NoBlackBoxes/BlackBoxes/README.md

# Black Boxes

> A collection of **black boxes** and instructions for opening them.

----

## License

<br />The entire BlackBoxes repository (hardware and software) is licensed under a <a rel="license" href="http://creativecommons.org/licenses/by-nc-sa/4.0/">Creative Commons Attribution-NonCommercial-ShareAlike 4.0 International License</a>.
