NoBlackBoxes/BlackBoxes/vision/python/README.md

# Vision : python

```bash
pip install opencv-python
```

```bash
# On Host (current Python version 3.12.3)
echo "/home/${USER}/NoBlackBoxes/LastBlackBox/boxes/vision/python/libs" > /home/${USER}/NoBlackBoxes/LastBlackBox/_tmp/NBB/lib/python3.12/site-packages/NBB_vision.pth
```
