NoBlackBoxes/BlackBoxes/electrons/README_new.md

# Electrons

Electrons are sub-atomic particles with a negative electric charge. Their negative charge produces a *force* that attracts positive charges and repels negative charges.

In this box, we will learn about electricity...how to measure it and how to **control** it.

### Required Materials

- {01}: NBB-11, multimeter
- {10}: NBB-21, multimeter
- {11}: NBB-31, multimeter, oscilliscope

## Electric Fields

Electric fields describe the force that a charged particle feels when nearby another charged particle.

{01}
Watch this video...closely.
- *Video*: [LBB:Electrons:Electric Fields](https://vimeo.com/625820421)

{10}
Watch this video.
- *Video*: [NB3:Electrons:Dipoles](https://vimeo.com/843622939)

Use the following image as a starting point for the next task.
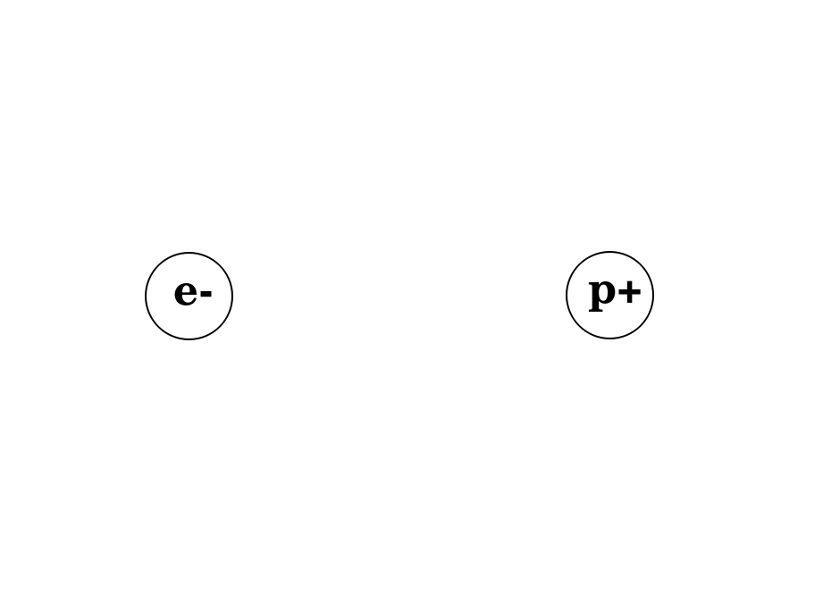
[picture p2: electrons/_data/images/dipole_field_template.png]
dipole field template


- **Task**(draw_a_dipole_field): Draw the electric field around an electron(-) and a proton(+) seperated by some small distance (as experienced by another electon). Upload a photo of your field drawing. [photo]

## Voltage

Voltage describes the difference in net charge in one location versus another.

{01}
- *Video*: [LBB:Electrons:Voltage](https://vimeo.com/XXX)

## Batteries

Producing a stable voltage was hard, but very useful.

{01}
- *Video*: [LBB:Electrons:Batteries](https://vimeo.com/XXX)

{10}
- *Video*: [NB3:Electrons:Household Battery](https://vimeo.com/XXX)
- **Task**(build_a_battery): Build a battery. Upload a photo of your design and the voltage generated (as shown on the multimeter screen) here: [photo]
 
## Measuring Voltage

We can measure voltage (and other electrical properties) with a multi-meter.

{01}
- *Video*: [NB3:Electrons:Measuring Voltage](https://vimeo.com/XXX)
- **Task**(measure_AA_battery): Measure the voltage of a AA battery. Enter your measurement [number].
- **Task**(measure_4xAA_batteries): Measure the voltage of 4xAA batteries in series (i.e. in your battery holder). Enter your measurement here [number].

## Conductors

Some materials have electrons that are very loosely connected to their atom's nucleus. In a material made up of many atom's of this type, then the electrons can hop from nucleus to nucleus. The electrons can "move". We call these materials conductors.

{10}
- *Video*: [LBB:Electrons:Conductors](https://vimeo.com/XXX)

## Resistors

In other materials, some electrons are free and others are not. They can move, but not as well. They experience resistance. We call these materials resitors, and they will help us *control* electricity.

{10}
- *Video*: [LBB:Electrons:Resistors](https://vimeo.com/XXX)

## Measuring Resistance

We can measure resitance (and other electrical properties) with a multi-mteter.

{10}
- *Video*: [NB3:Electrons:Measuring Resistance](https://vimeo.com/XXX)

## Circuit Diagrams

We can draw simple schematics of electronic circuits using symbols for the real devices. We will draw and build *many* of these.

{01}
- *Video*: [LBB:Electrons:Circuit Diagrams](https://vimeo.com/XXX)
- **Task**(draw_a_simple_circuit): Draw a circuit with one battery and two resistors. Lable the voltage and resistor values. Upload a picture of your circuit here [photo].

## Prototyping

Let's build a prototyping board for creating and testing our first circuits.

{01}
- *Video*: [NB3:Electrons:Assemble NB3 Body](https://vimeo.com/XXX)
- **Task**(assemble_nb3_body): Build your NB3 body [photo].

## Printed Circuit Boards

Let's have a look at a printed circuit board.

{01}
- *Video*: [NB3:Electrons:Assemble NB3 Body](https://vimeo.com/XXX)
- **Task**(assemble_nb3_body): Build your NB3 body [photo].
  
## Current

Electrons, pushed by a voltage, moving in a conductor, or less so in a resistor create a current.

{01}
- *Video*: [LBB:Electrons:Current](https://vimeo.com/XXX)
- **Task**(measure_current): Measure the current flowing across a resitor. Enter the votage you used here [number.voltage], the resistor value here [number.resistance], and the measured current here [number.current].

## Measuring Current

We can measure current (and other electrical properties) with a multi-mteter.

{01}
- *Video*: [LBB:Electrons:Measuring Current](https://vimeo.com/XXX)
- **Task**(measure_current): Measure the current flowing across a resistor. Enter the votage you used here [number.voltage], the resistor value here [number.resistance], and the measured current here [number.current].

## Ohm's Law

A simple, linear, relationship between voltage, current, and resistance.

{01}
- *Video*: [LBB:Electrons:Ohms's Law](https://vimeo.com/XXX)
- **Task**: Measure the current flowing across a resitor [number].

## Voltage Divider

Your first circuit.

{01}
- *Video*: [LBB:Electrons:Voltage Divider](https://vimeo.com/625820421)
- **Task**: Build a voltage divider using two resistors and measure the "divided" voltage level. Is it what you epxected? Upload a picture of your circuit diagram with voltage and resistor values indicated [photo].

## Capacitors

Capacitors are cool.

{10}
- *Video*: [LBB:Electrons:Capacitors](https://vimeo.com/625820421)
- **Task**: Measure the capacitance of your cap [number]
