NoBlackBoxes/BlackBoxes/amplifiers/images/NB3_amplifiers.png

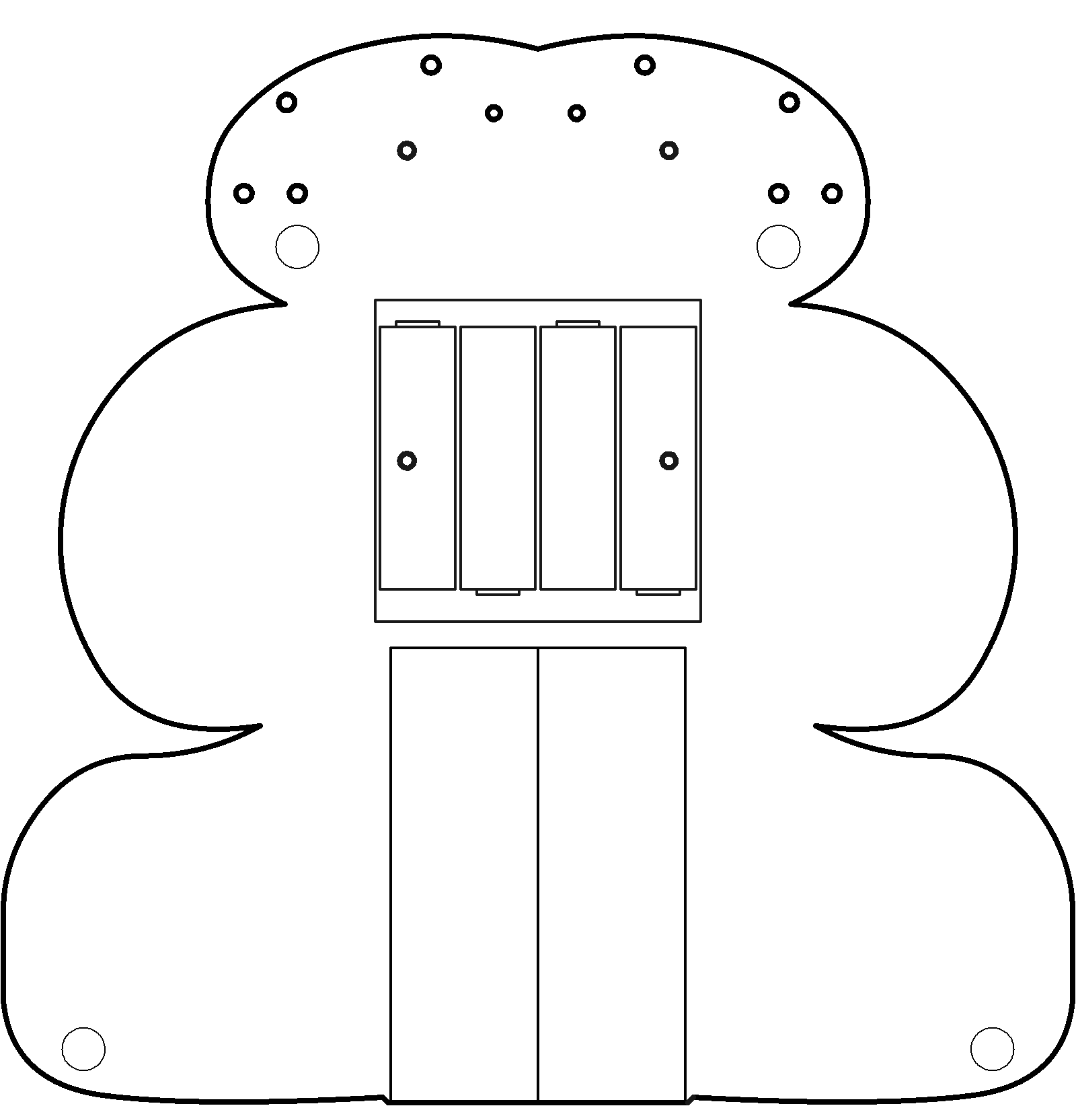
amplifiers/images/NB3_amplifiers.png
