NoBlackBoxes/BlackBoxes/atoms/_data/images/periodic_table.png

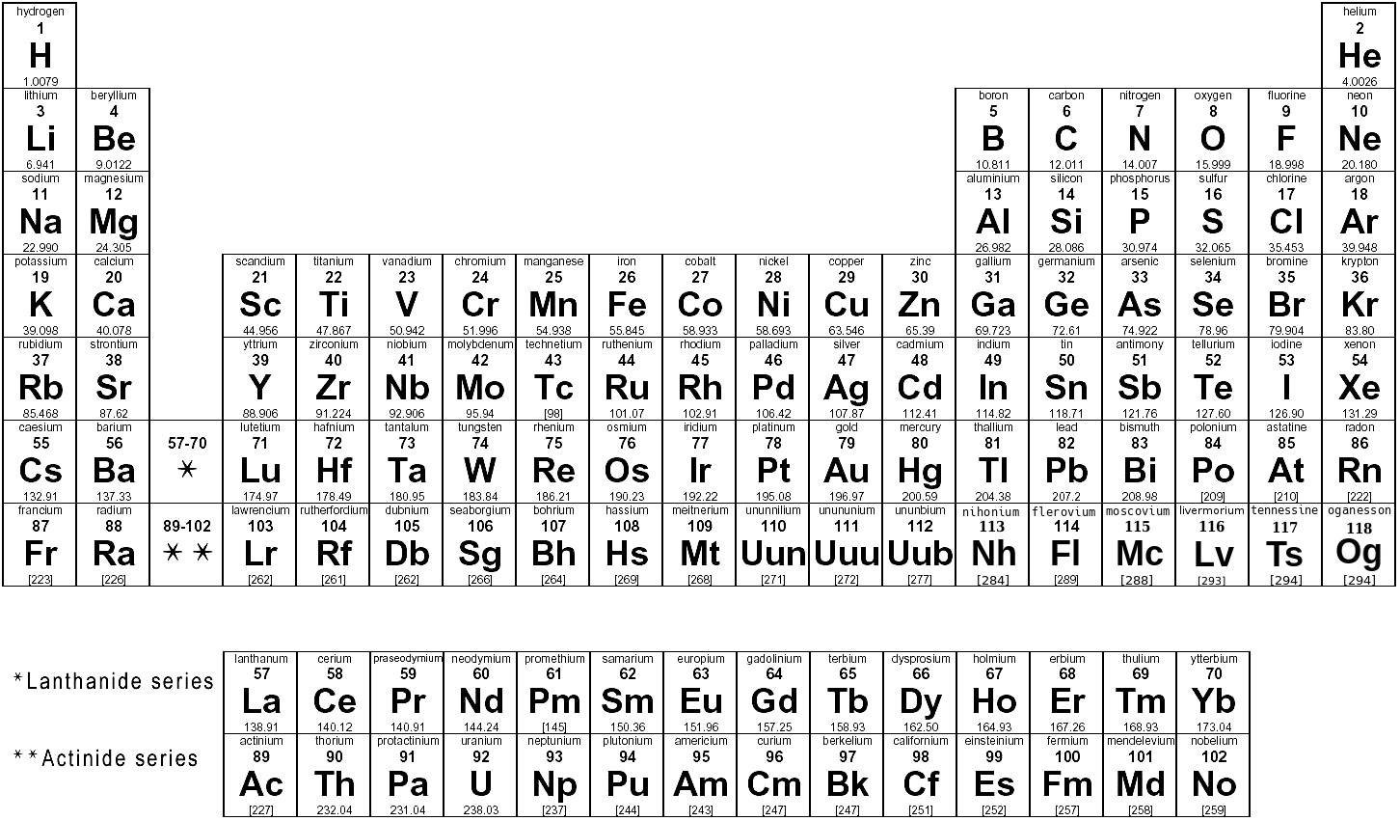
atoms/_data/images/periodic_table.png
