NoBlackBoxes/BlackBoxes/atoms/card/periodic_table_card_back.png

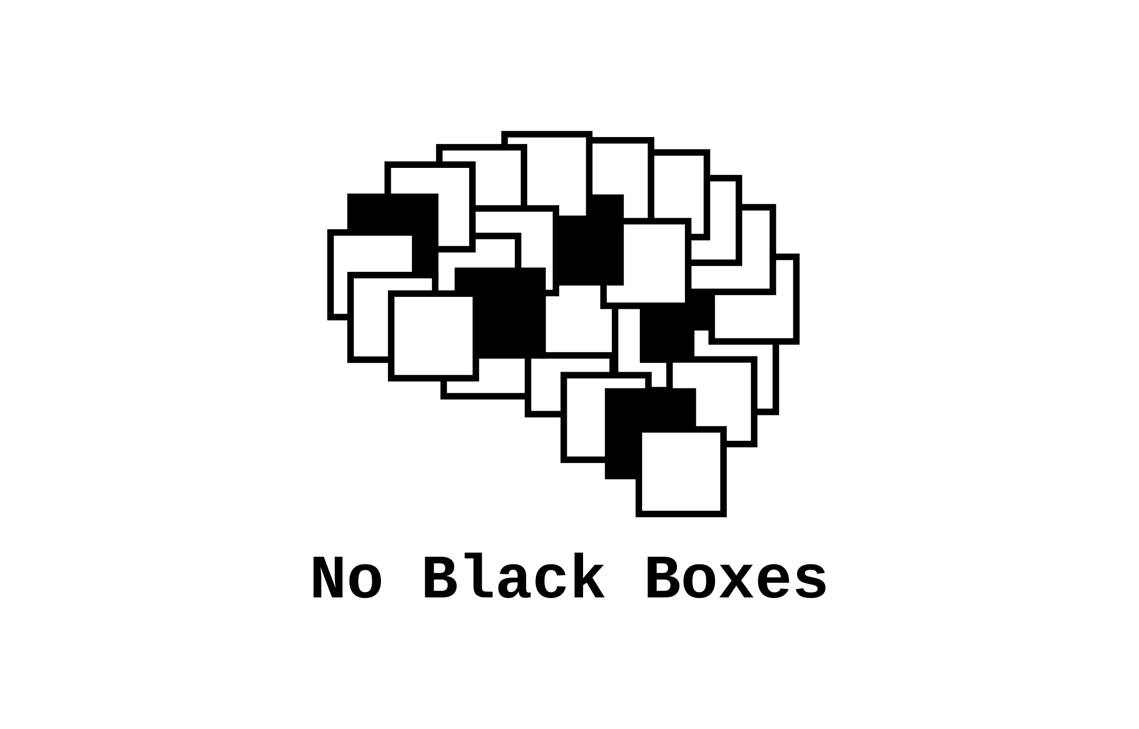
atoms/card/periodic_table_card_back.png
