NoBlackBoxes/BlackBoxes/atoms/card/periodic_table_card_front.png

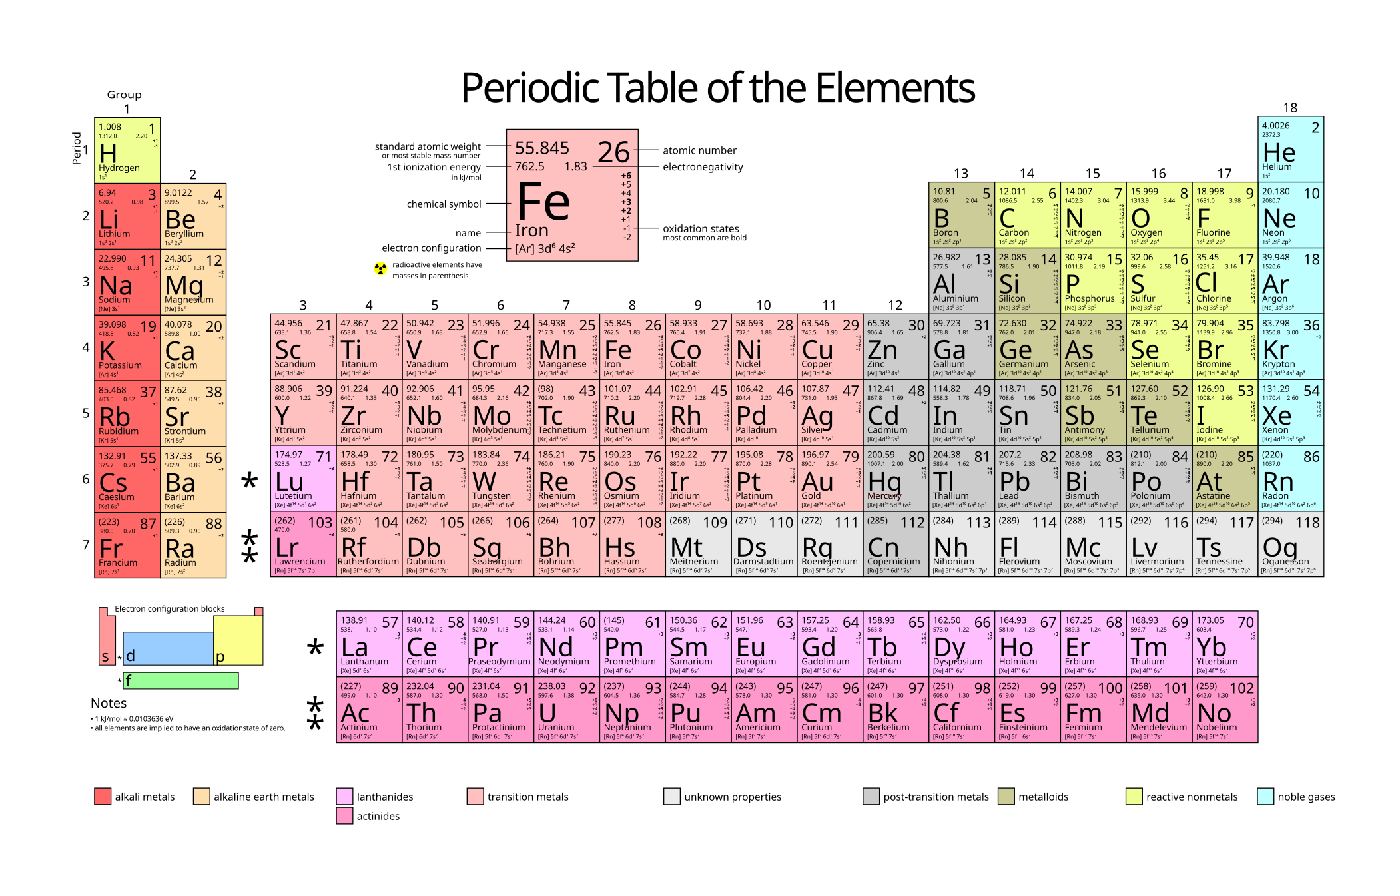
atoms/card/periodic_table_card_front.png
