NoBlackBoxes/BlackBoxes/audio/_data/datasheets/CQR0508.jpg

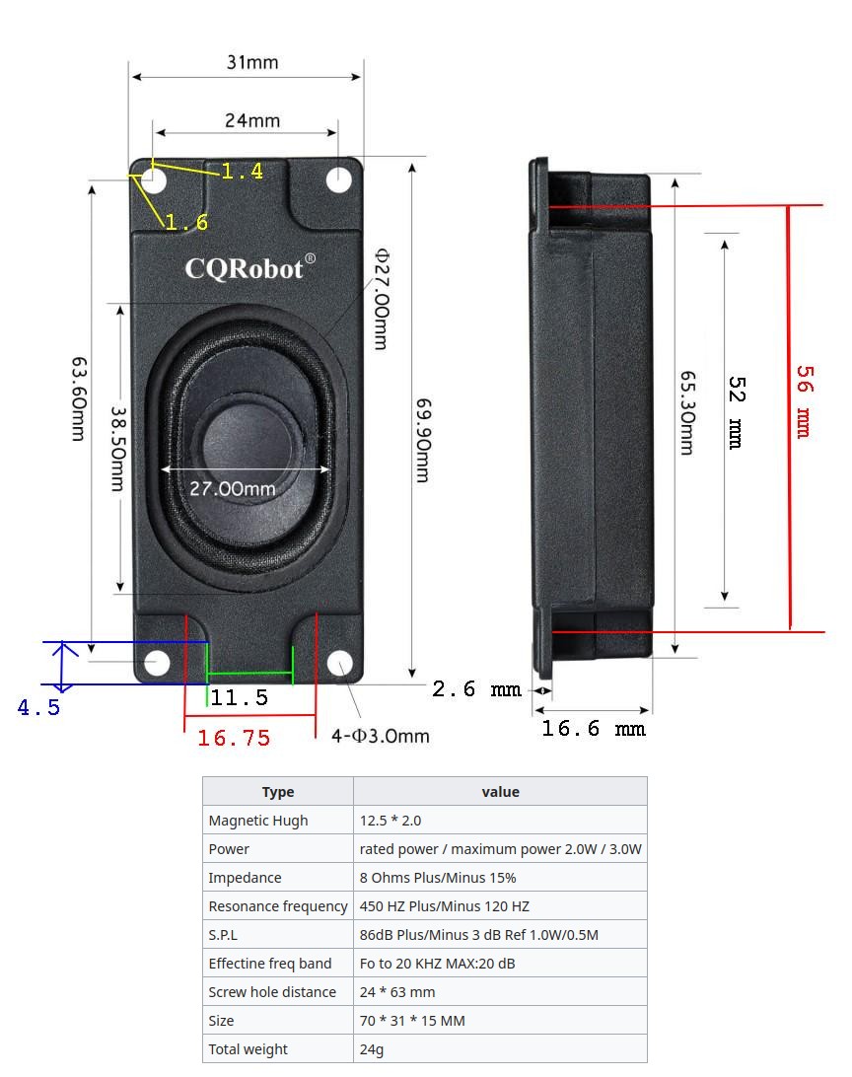
audio/_data/datasheets/CQR0508.jpg
