NoBlackBoxes/BlackBoxes/audio/_data/images/I2S.png

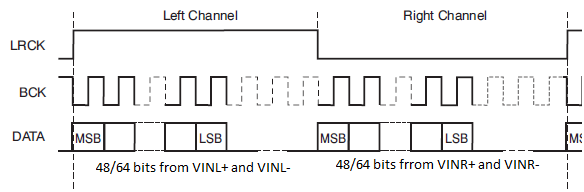
audio/_data/images/I2S.png
