NoBlackBoxes/BlackBoxes/audio/_data/images/NB3_audio.png

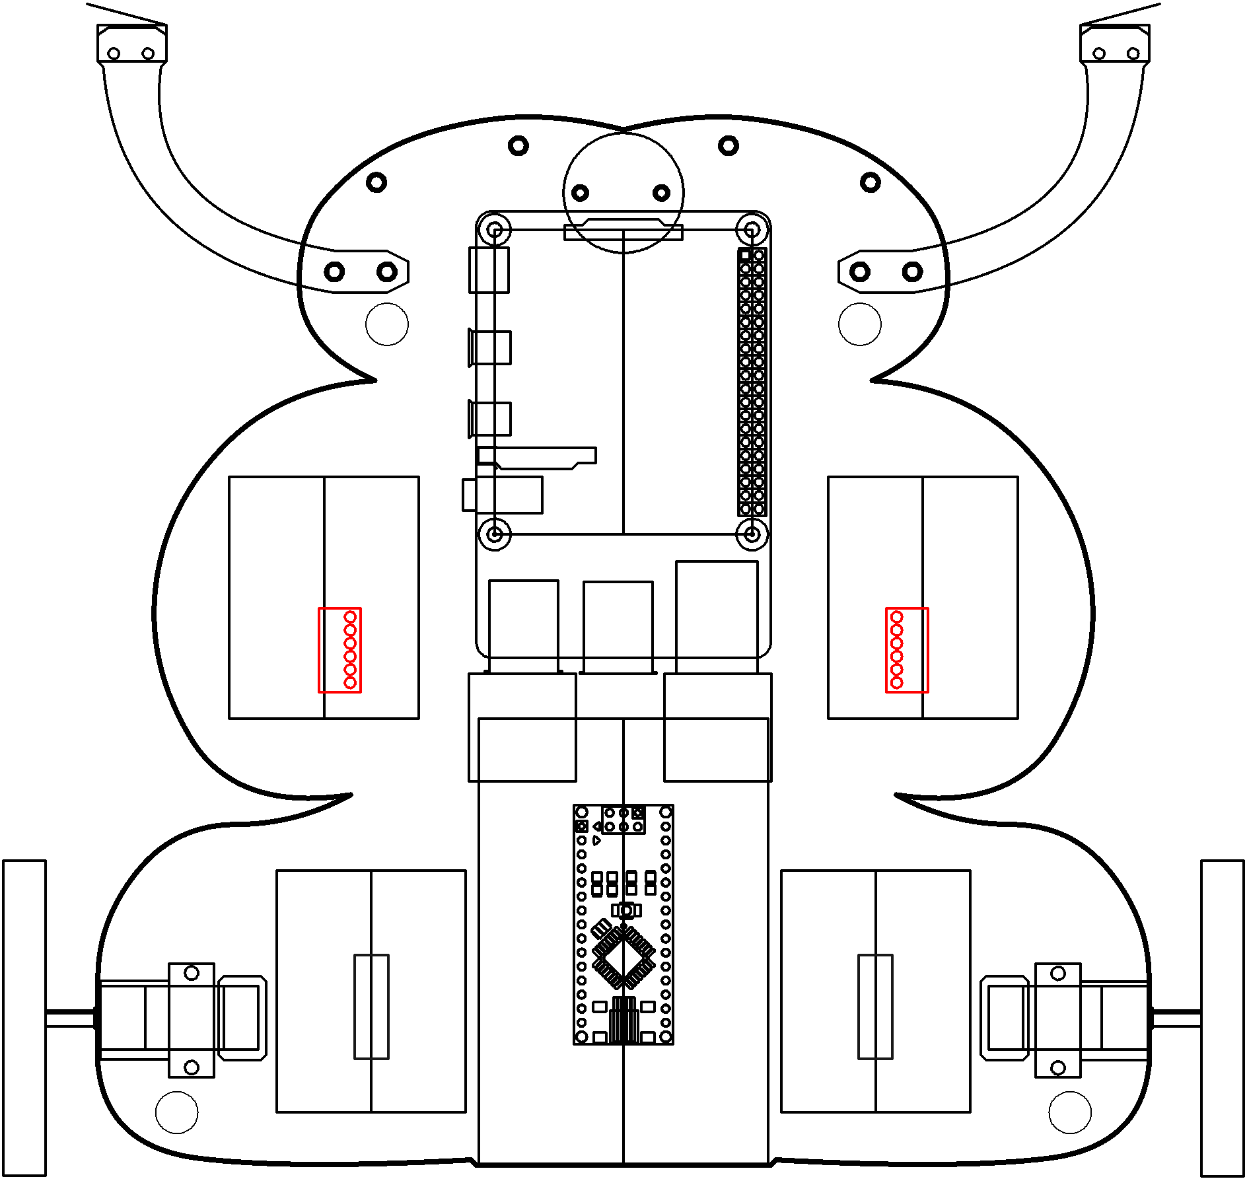
audio/_data/images/NB3_audio.png
