NoBlackBoxes/BlackBoxes/audio/NB3_ear/NB3_ear_back.png

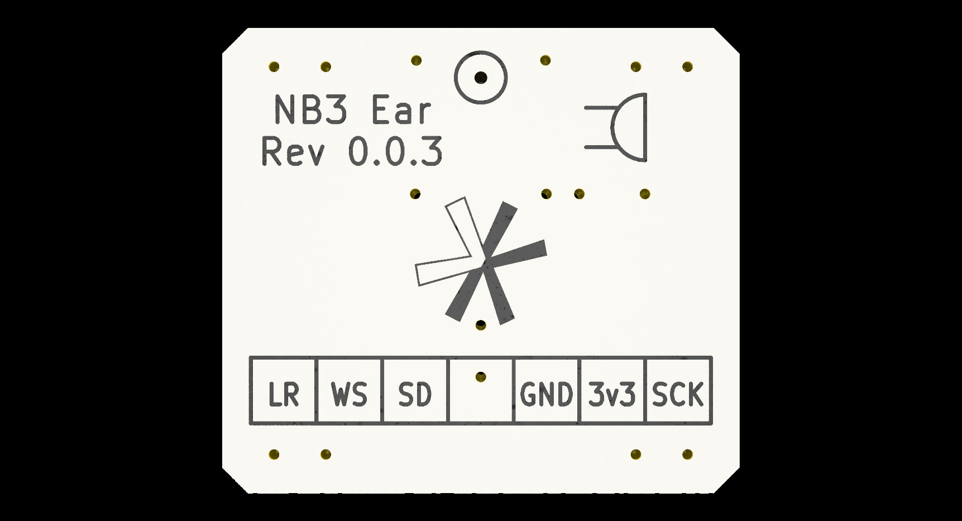
audio/NB3_ear/NB3_ear_back.png
