NoBlackBoxes/BlackBoxes/audio/NB3_ear/NB3_ear_FAB_drill_settings.png

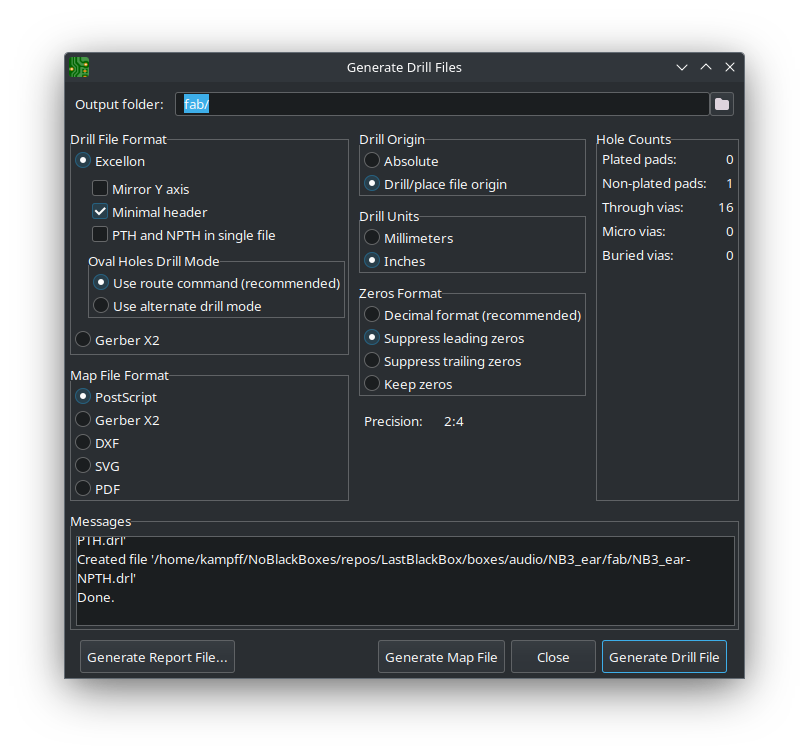
audio/NB3_ear/NB3_ear_FAB_drill_settings.png
