NoBlackBoxes/BlackBoxes/audio/NB3_ear/NB3_ear_FAB_plot_settings.png

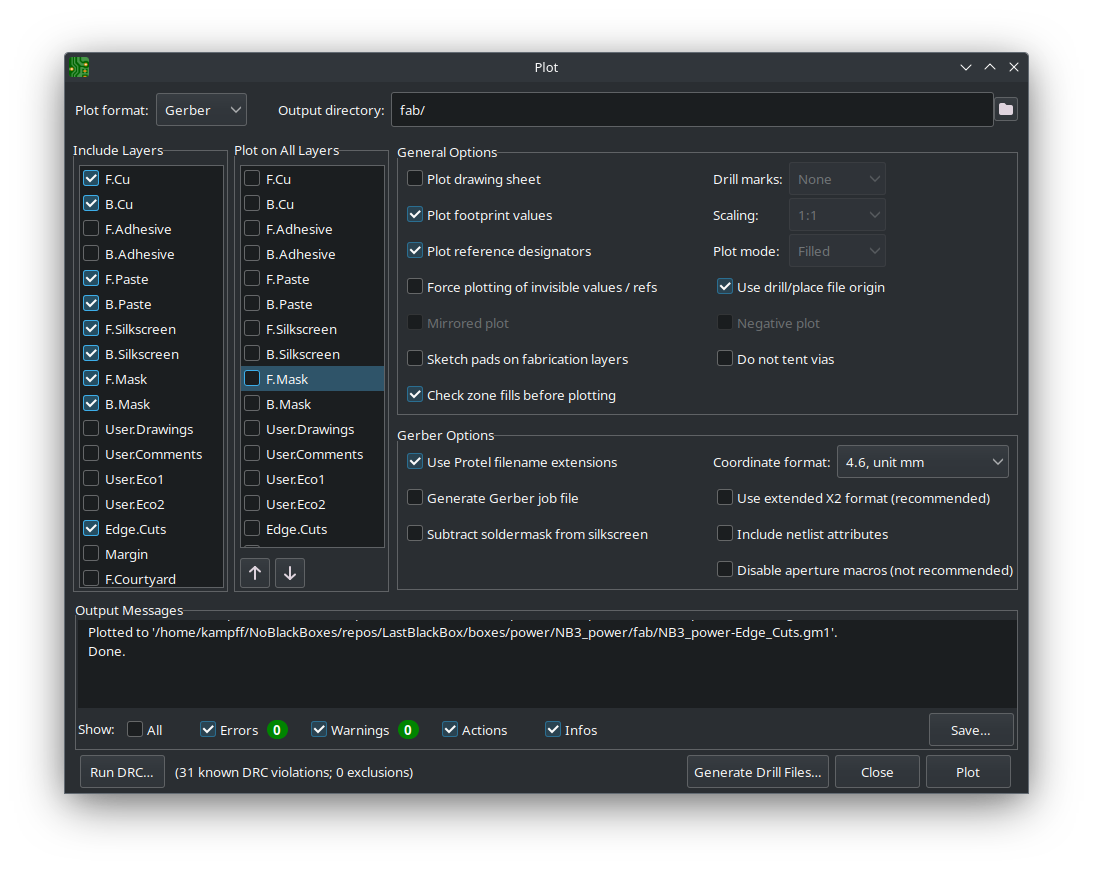
audio/NB3_ear/NB3_ear_FAB_plot_settings.png
