NoBlackBoxes/BlackBoxes/audio/NB3_ear/NB3_ear_FAB_pos_settings.png

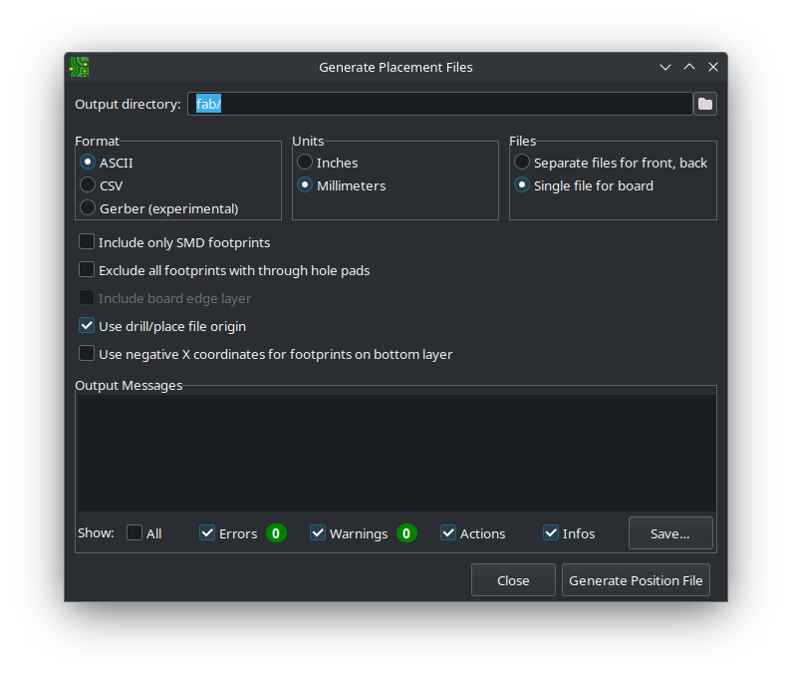
audio/NB3_ear/NB3_ear_FAB_pos_settings.png
