NoBlackBoxes/BlackBoxes/audio/NB3_ear/NB3_ear_front.png

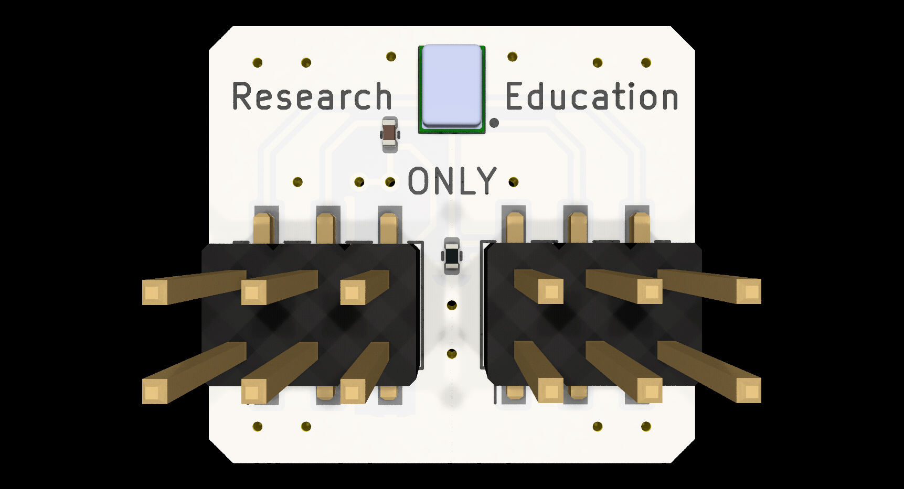
audio/NB3_ear/NB3_ear_front.png
