NoBlackBoxes/BlackBoxes/audio/NB3_mouth/NB3_mouth_back.png

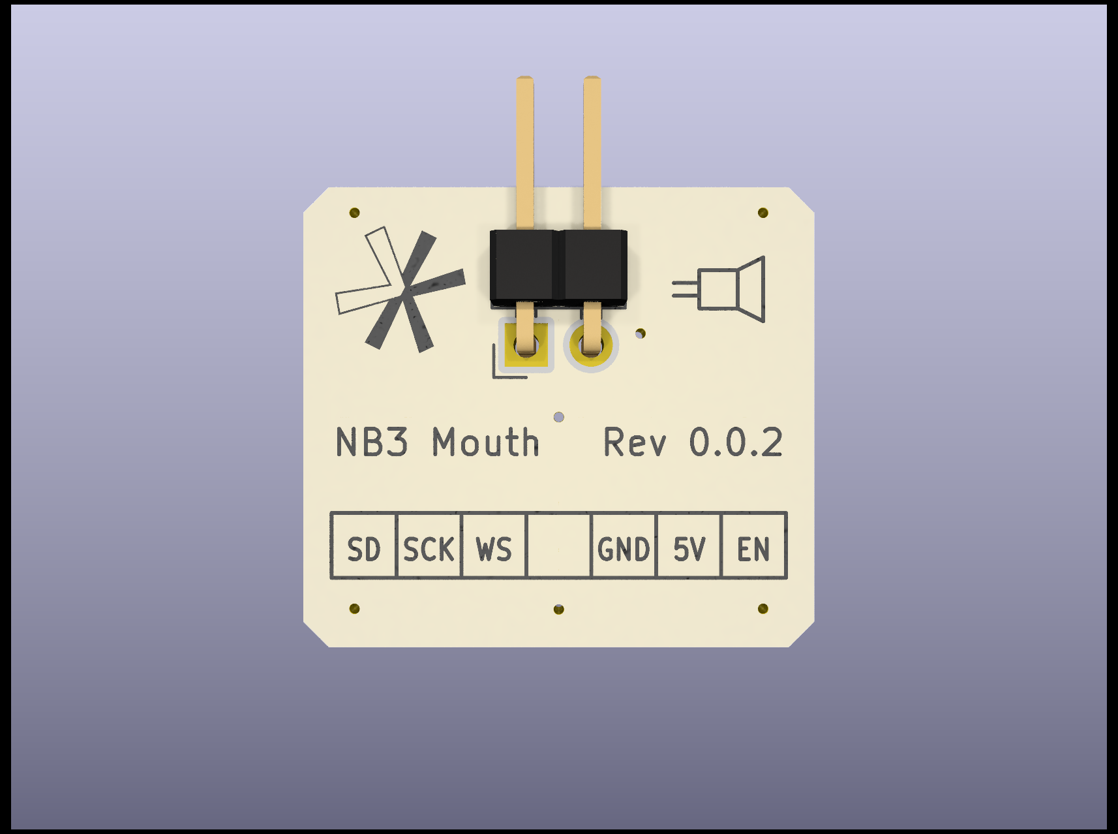
audio/NB3_mouth/NB3_mouth_back.png
