NoBlackBoxes/BlackBoxes/audio/NB3_mouth/NB3_mouth_front.png

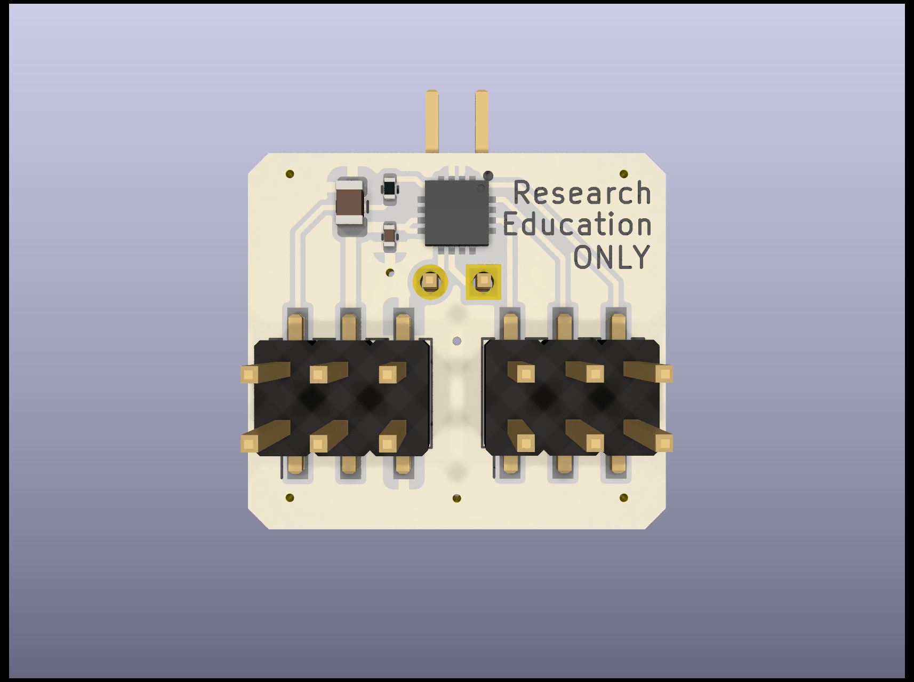
audio/NB3_mouth/NB3_mouth_front.png
