NoBlackBoxes/BlackBoxes/circuits/_data/images/NB3_reflexes.png

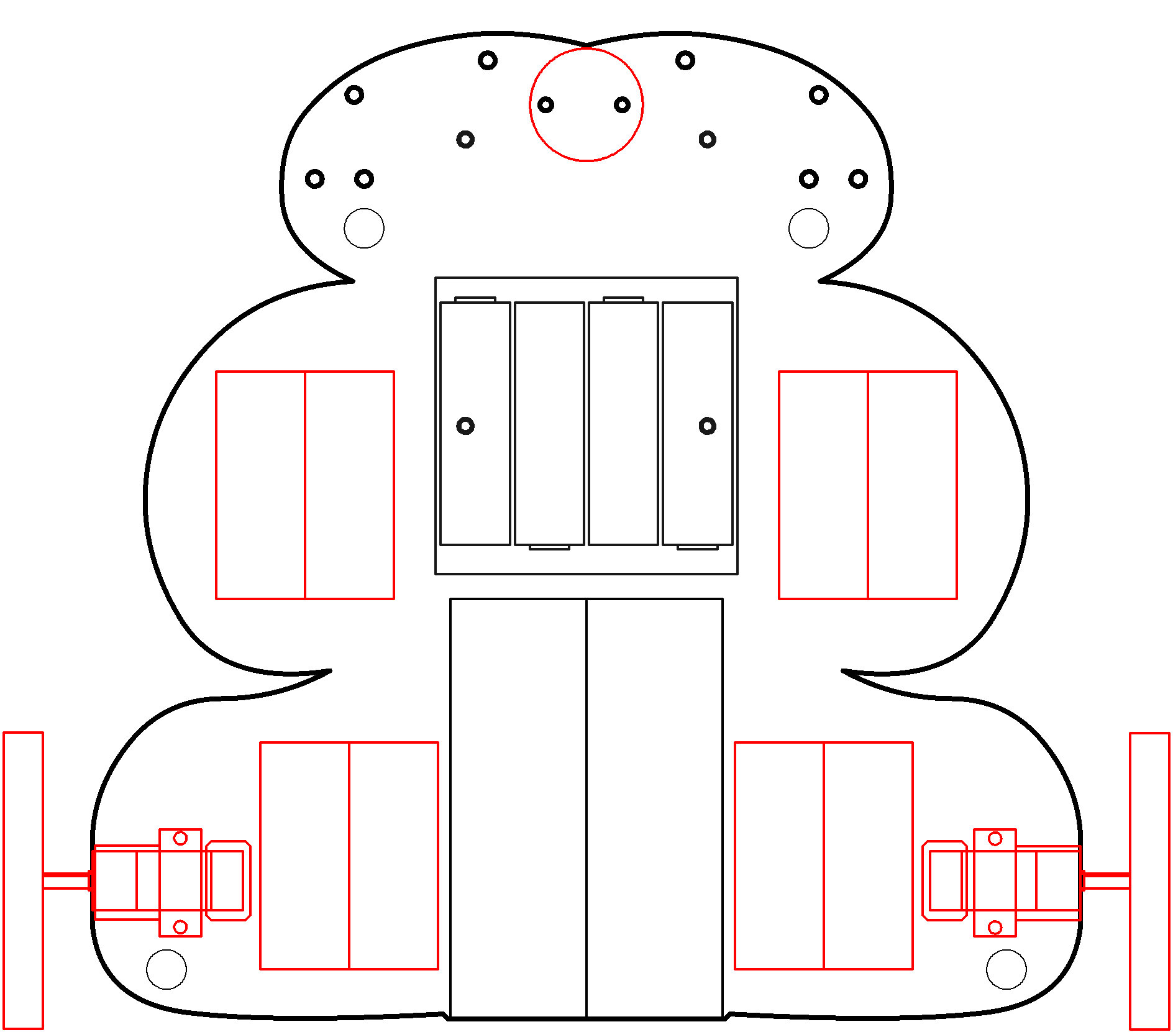
circuits/_data/images/NB3_reflexes.png
