NoBlackBoxes/BlackBoxes/computers/_data/images/ACE.png

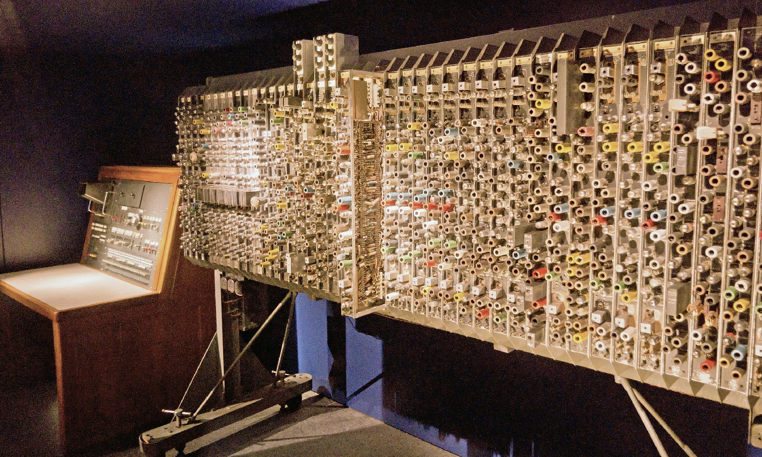
computers/_data/images/ACE.png
