NoBlackBoxes/BlackBoxes/computers/_data/images/ada_lovelace.png

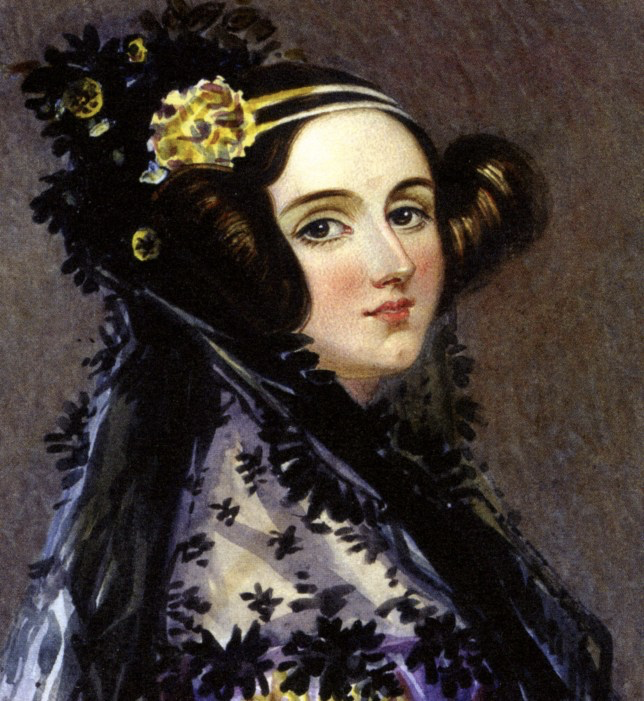
computers/_data/images/ada_lovelace.png
