NoBlackBoxes/BlackBoxes/computers/_data/images/AlanTuring.png

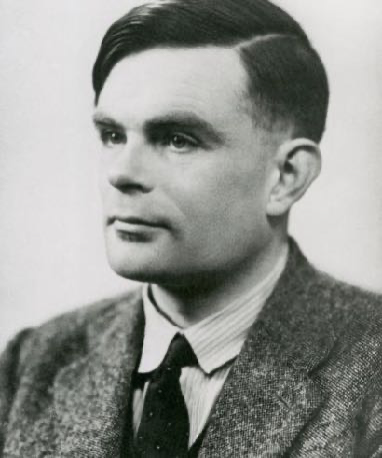
computers/_data/images/AlanTuring.png
