NoBlackBoxes/BlackBoxes/computers/_data/images/analog_analogues.png

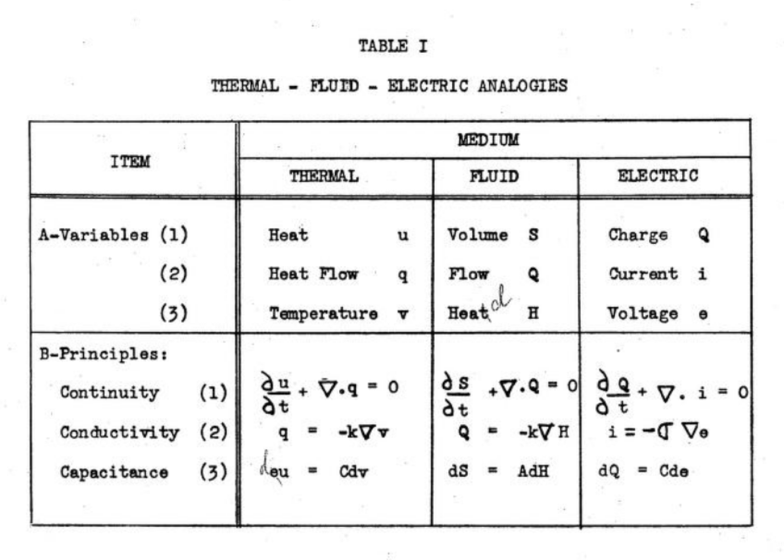
computers/_data/images/analog_analogues.png
