NoBlackBoxes/BlackBoxes/computers/_data/images/attiny_layout.png

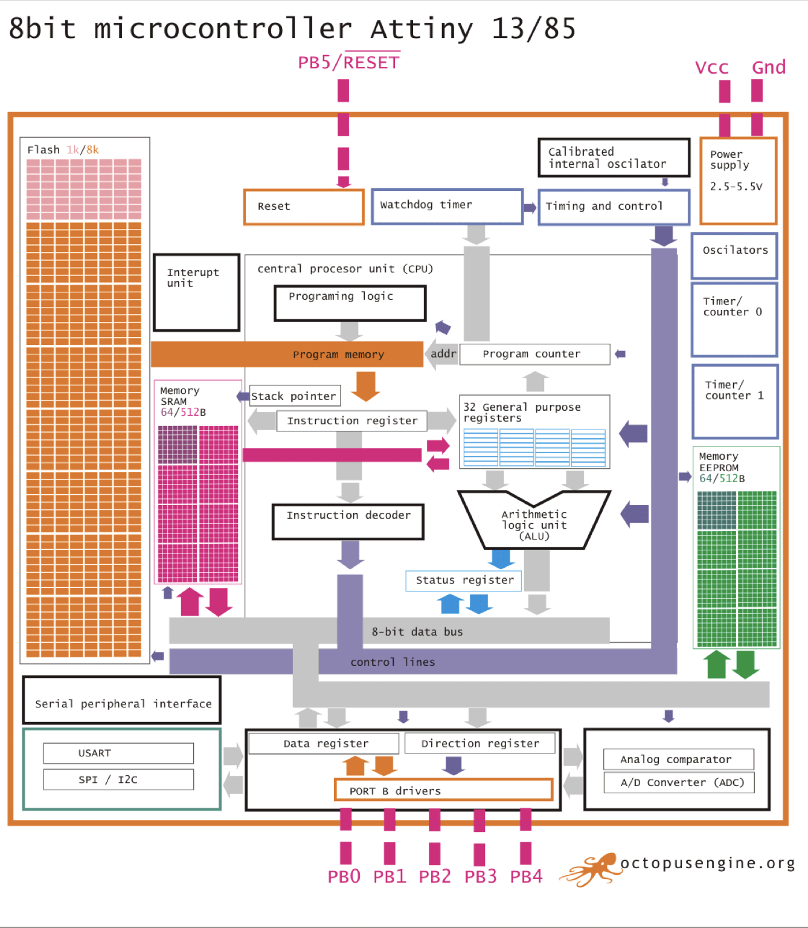
computers/_data/images/attiny_layout.png
