NoBlackBoxes/BlackBoxes/computers/_data/images/attiny_zoomin.png

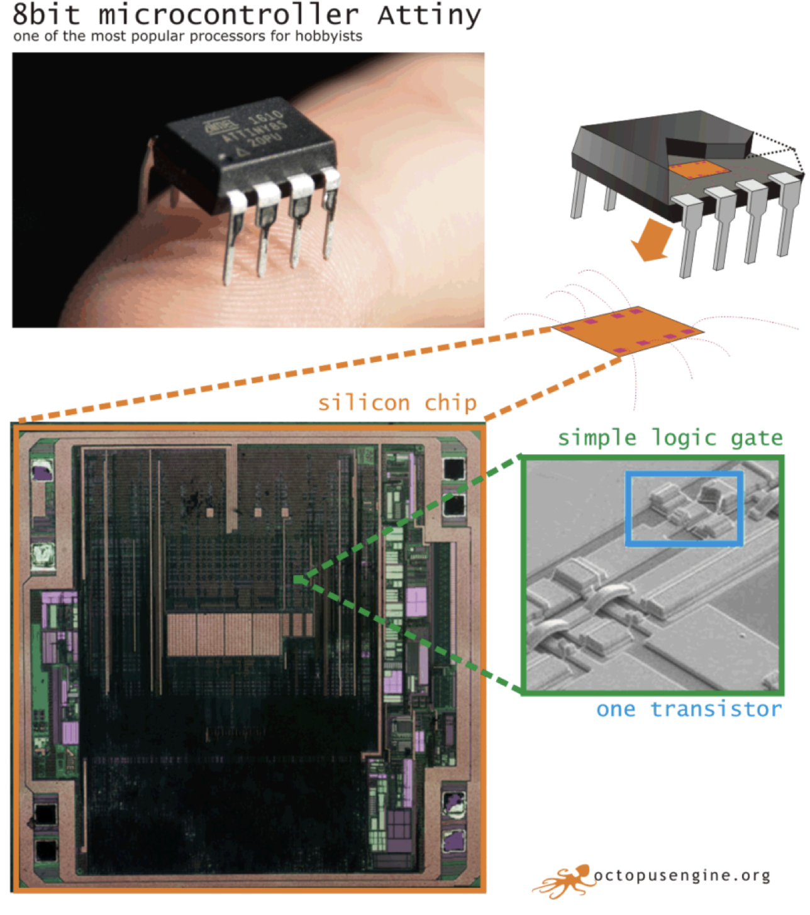
computers/_data/images/attiny_zoomin.png
