NoBlackBoxes/BlackBoxes/computers/_data/images/babbage.png

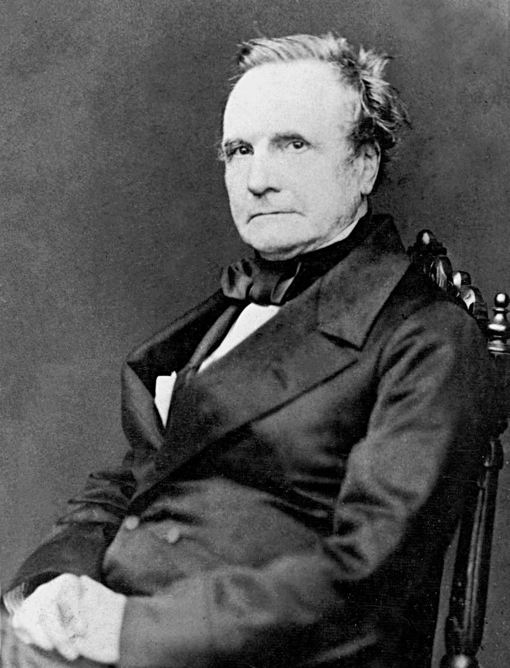
computers/_data/images/babbage.png
