NoBlackBoxes/BlackBoxes/computers/_data/images/ball_and_disk_integrator.png

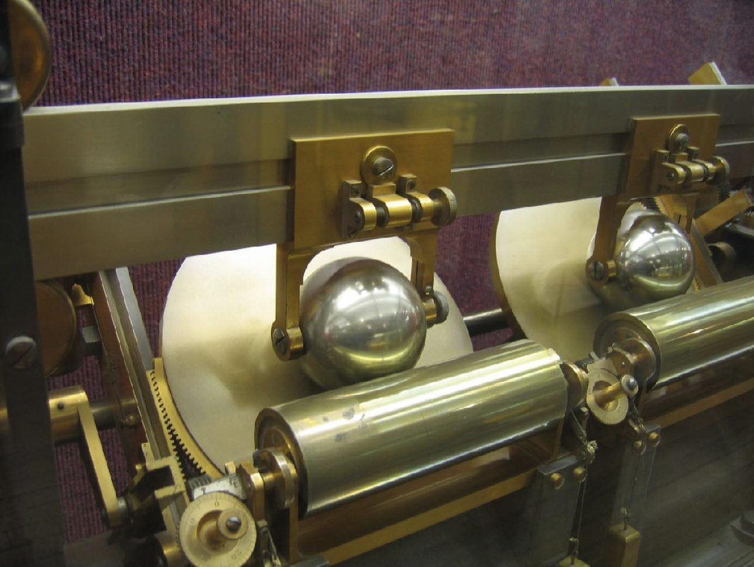
computers/_data/images/ball_and_disk_integrator.png
