NoBlackBoxes/BlackBoxes/computers/_data/images/BC237.png

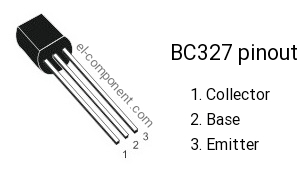
computers/_data/images/BC237.png
