NoBlackBoxes/BlackBoxes/computers/_data/images/colossus.png

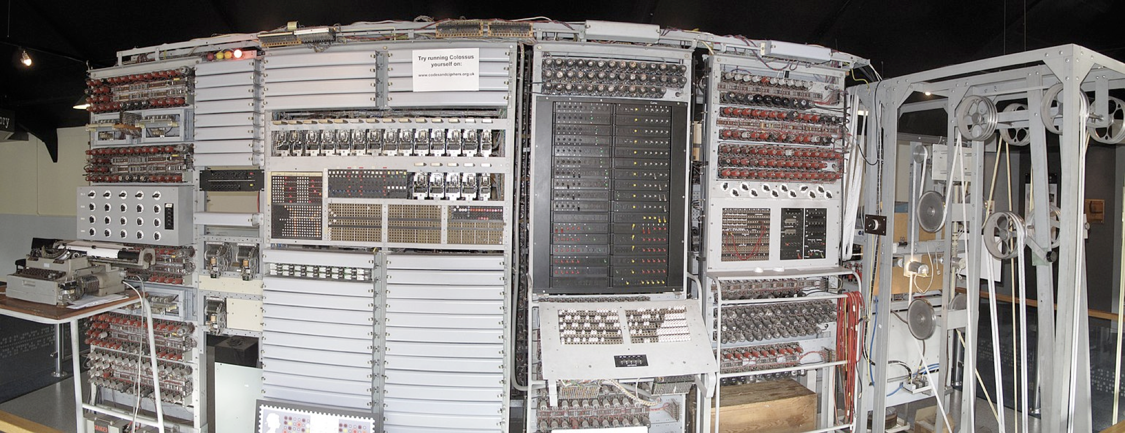
computers/_data/images/colossus.png
