NoBlackBoxes/BlackBoxes/computers/_data/images/difference_engine.png

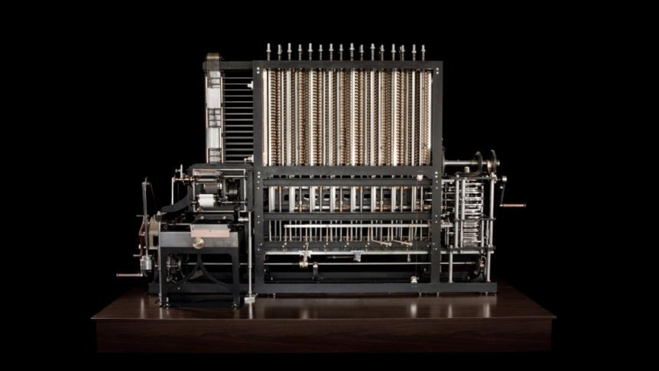
computers/_data/images/difference_engine.png
