NoBlackBoxes/BlackBoxes/computers/_data/images/differential_analyzer.png

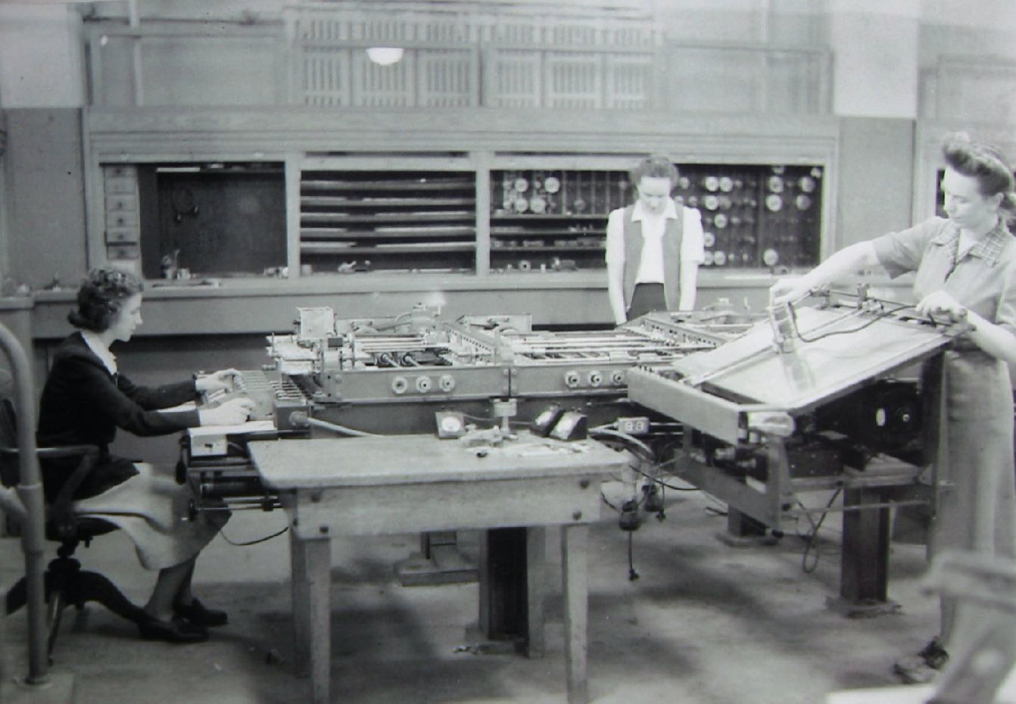
computers/_data/images/differential_analyzer.png
