NoBlackBoxes/BlackBoxes/computers/_data/images/EDVAC.png

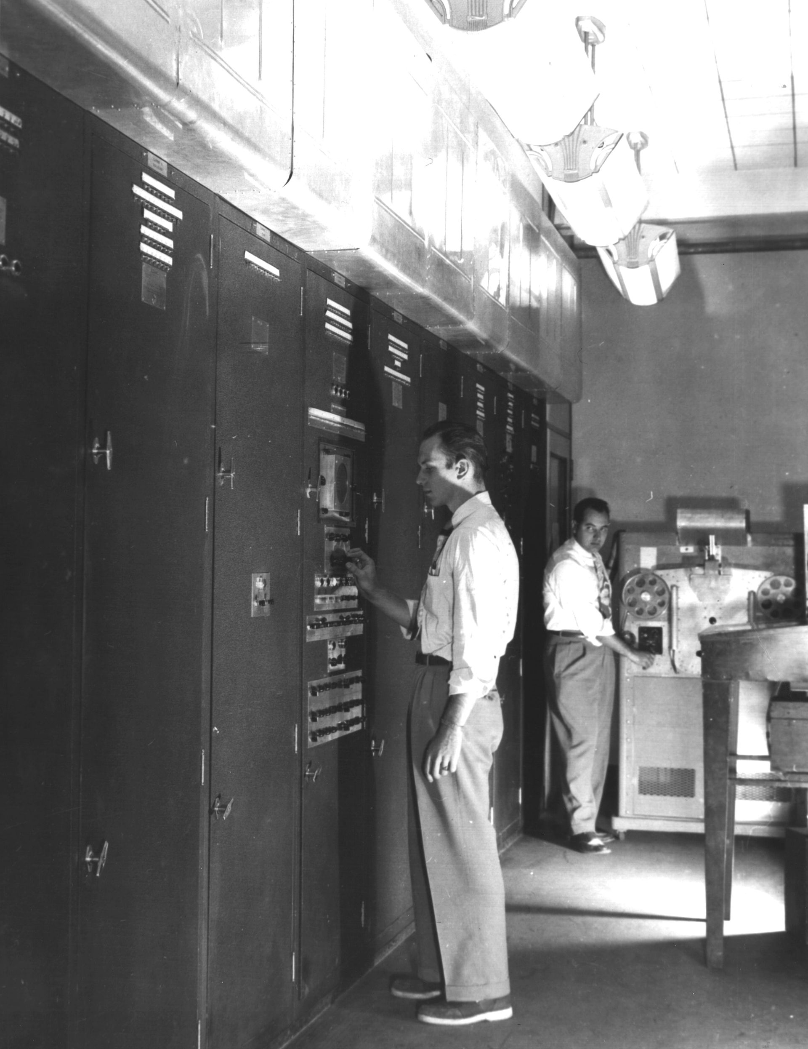
computers/_data/images/EDVAC.png
