NoBlackBoxes/BlackBoxes/computers/_data/images/ENIAC.png

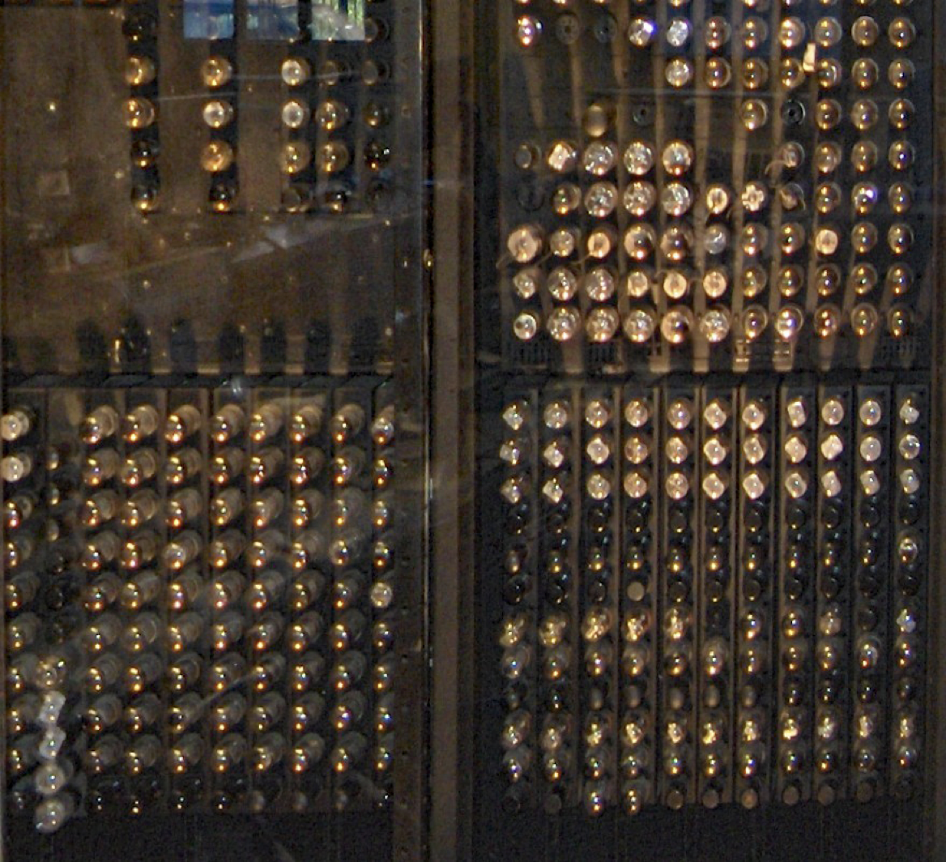
computers/_data/images/ENIAC.png
