NoBlackBoxes/BlackBoxes/computers/_data/images/first_transistor.png

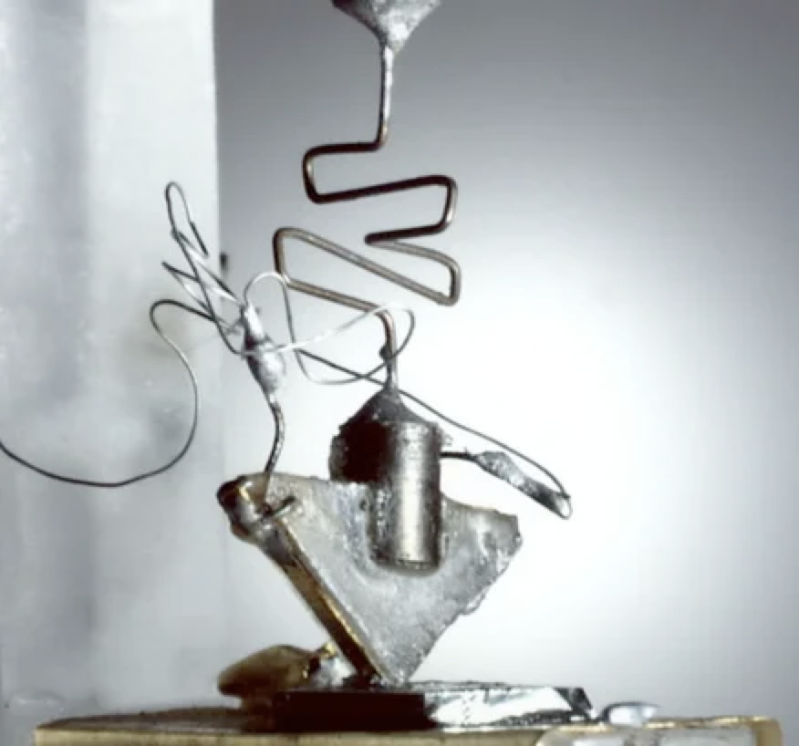
computers/_data/images/first_transistor.png
