NoBlackBoxes/BlackBoxes/computers/_data/images/first_transistor_schematic.png

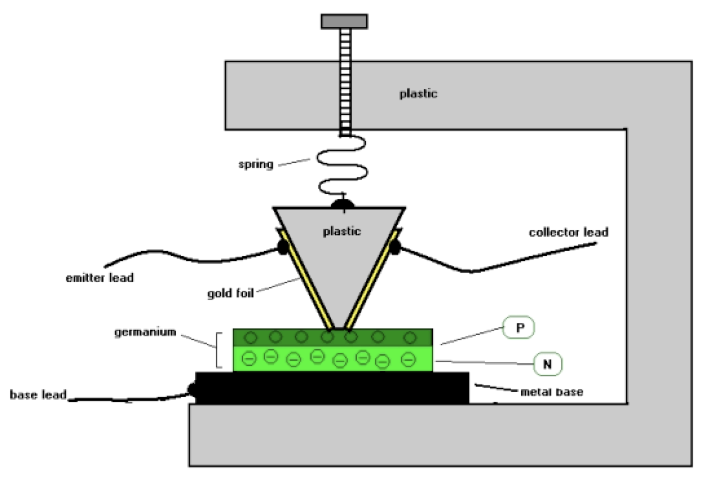
computers/_data/images/first_transistor_schematic.png
