NoBlackBoxes/BlackBoxes/computers/_data/images/ic_layout.png

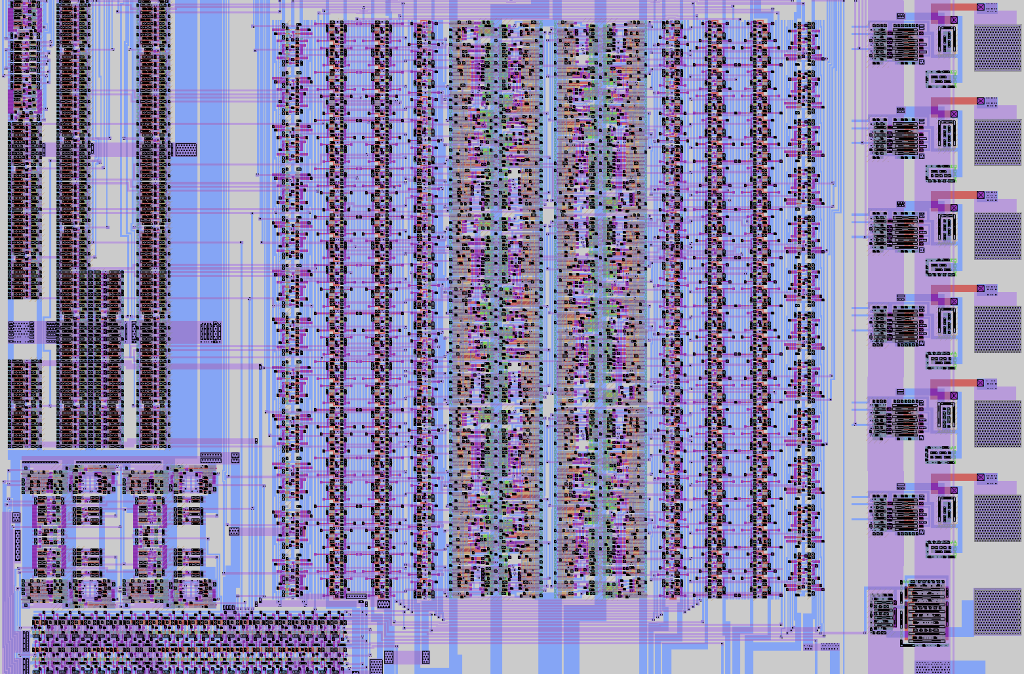
computers/_data/images/ic_layout.png
