NoBlackBoxes/BlackBoxes/computers/_data/images/MaxNewman.png

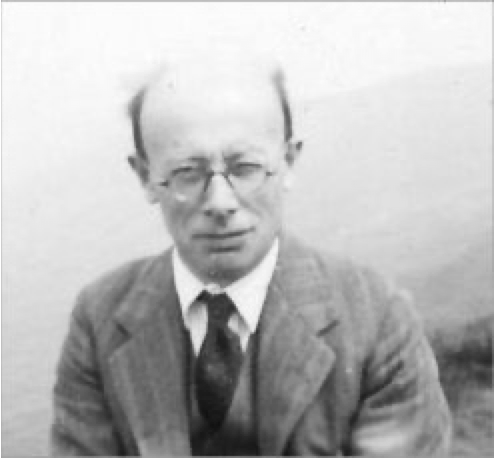
computers/_data/images/MaxNewman.png
