NoBlackBoxes/BlackBoxes/computers/_data/images/MONIAC.png

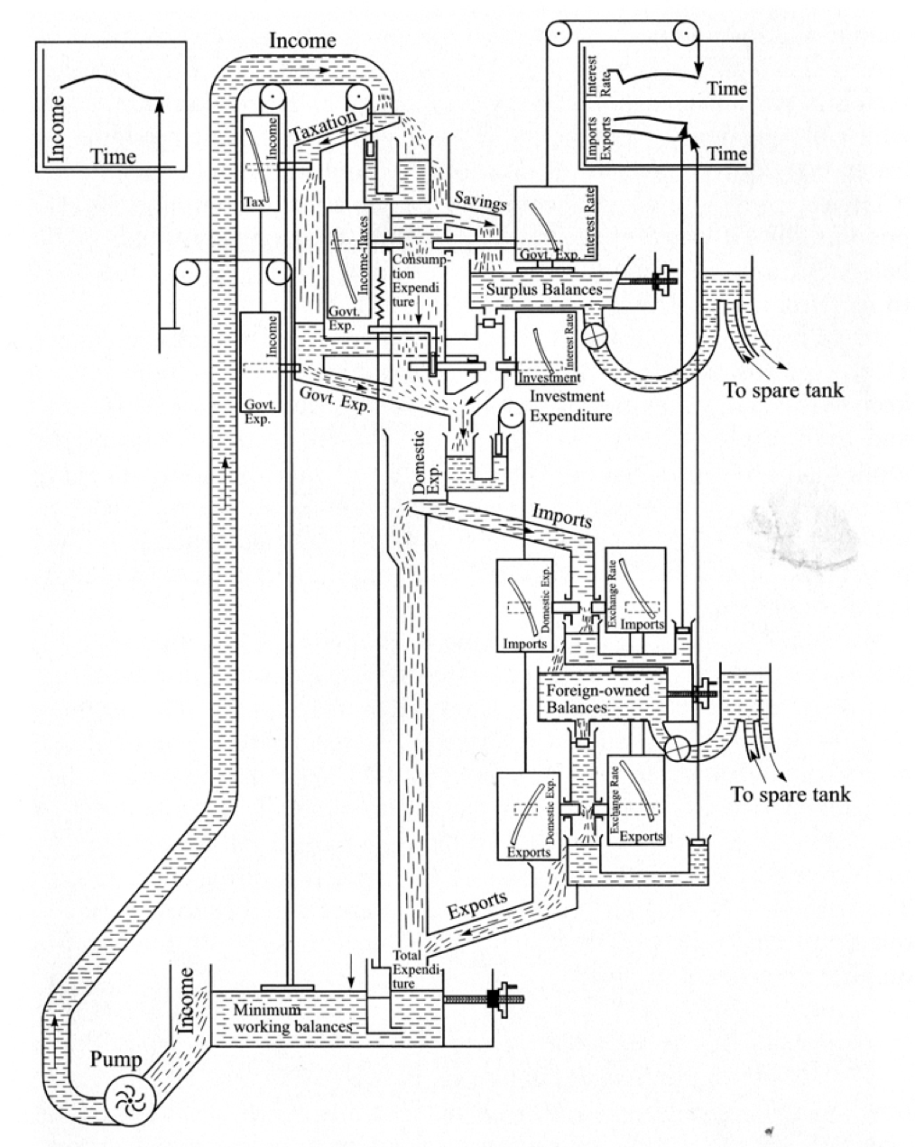
computers/_data/images/MONIAC.png
