NoBlackBoxes/BlackBoxes/computers/_data/images/moores_law.png

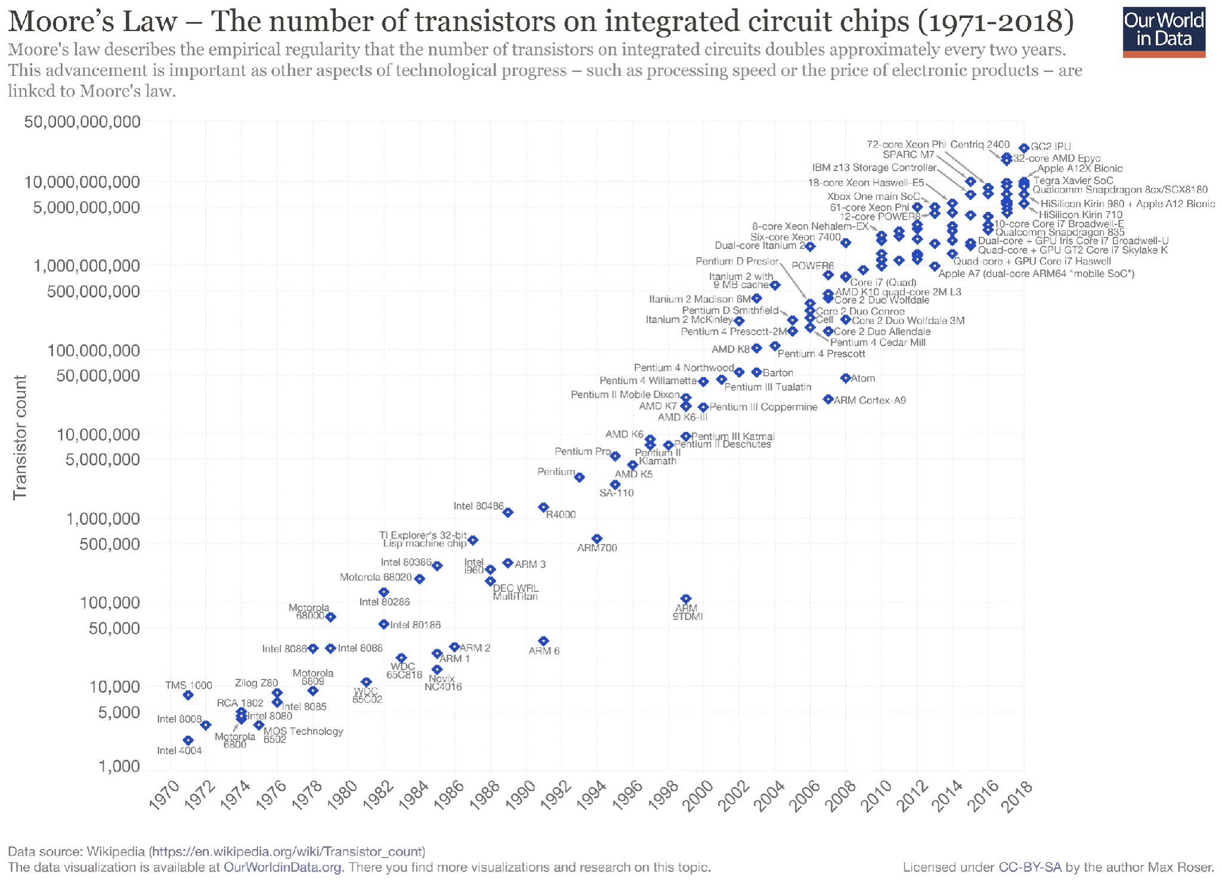
computers/_data/images/moores_law.png
