NoBlackBoxes/BlackBoxes/computers/_data/images/NB3_computers.png

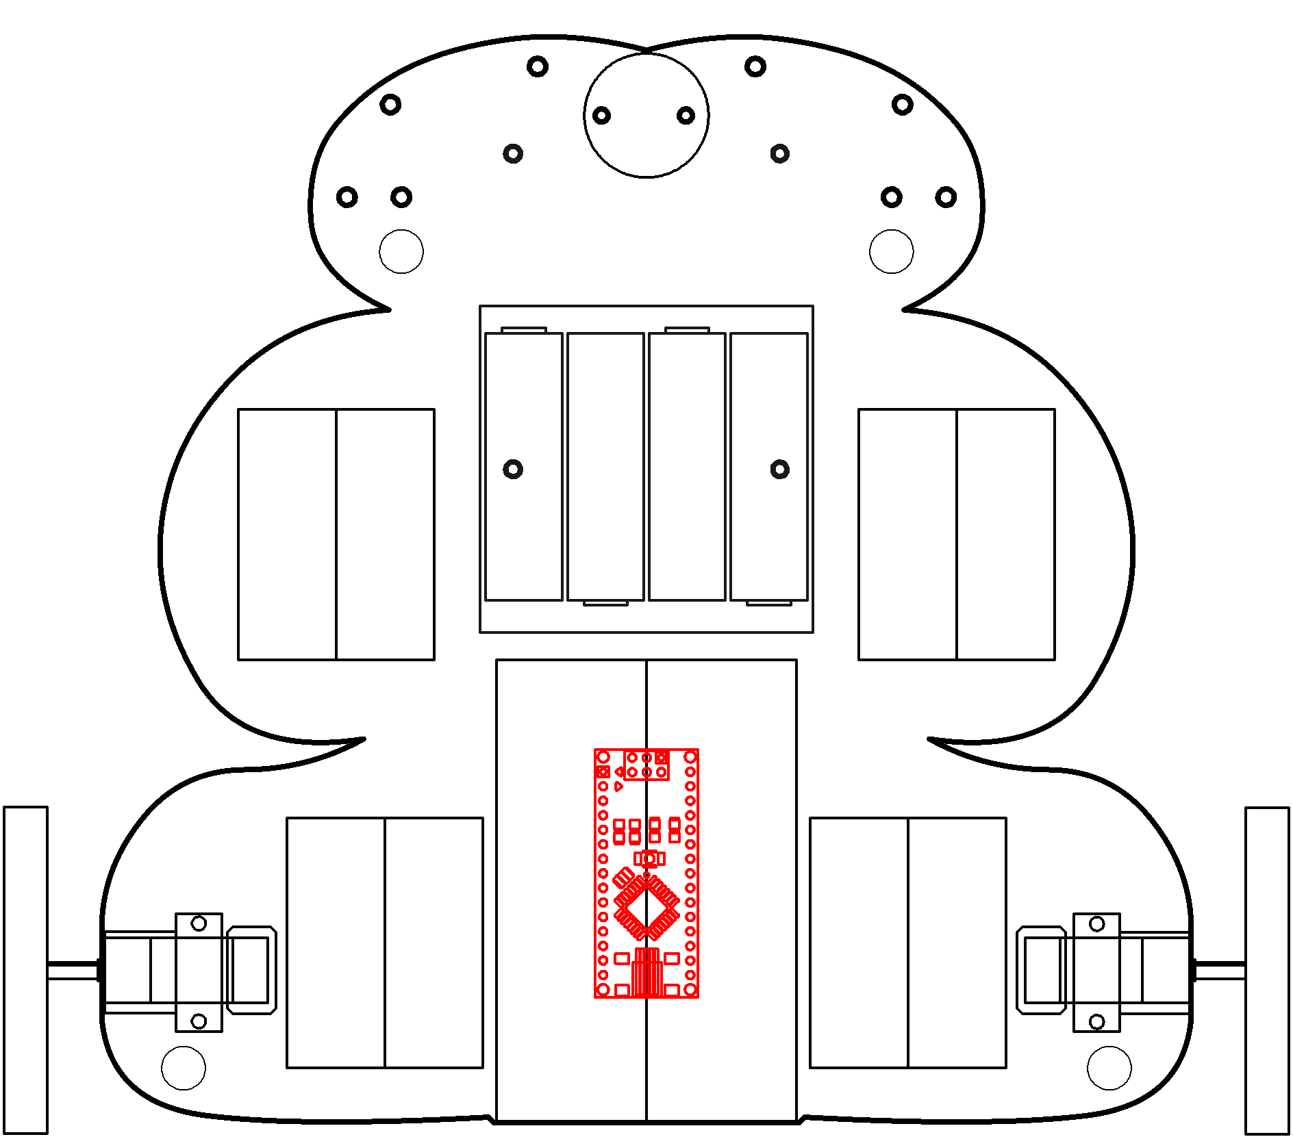
computers/_data/images/NB3_computers.png
