NoBlackBoxes/BlackBoxes/computers/_data/images/neumann.png

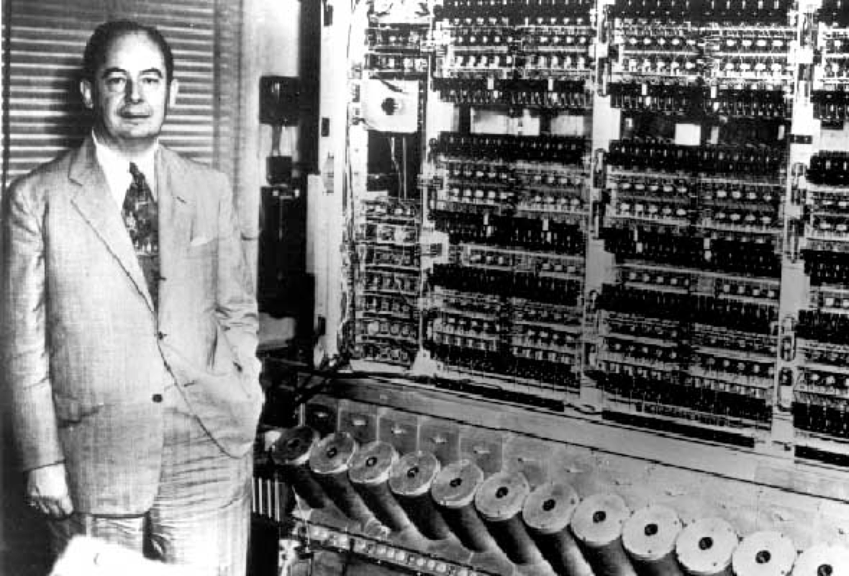
computers/_data/images/neumann.png
