NoBlackBoxes/BlackBoxes/computers/_data/images/neumann_architecture.png

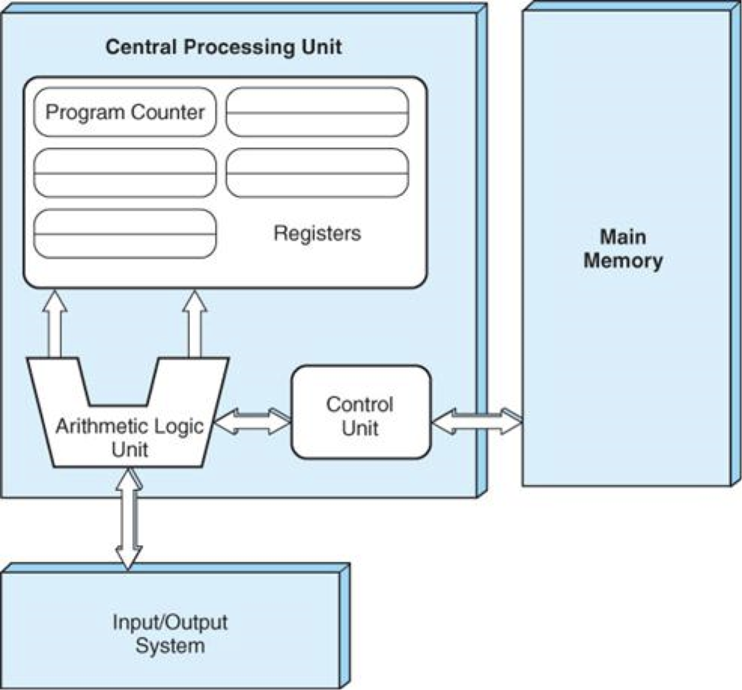
computers/_data/images/neumann_architecture.png
