NoBlackBoxes/BlackBoxes/computers/_data/images/PDP1.png

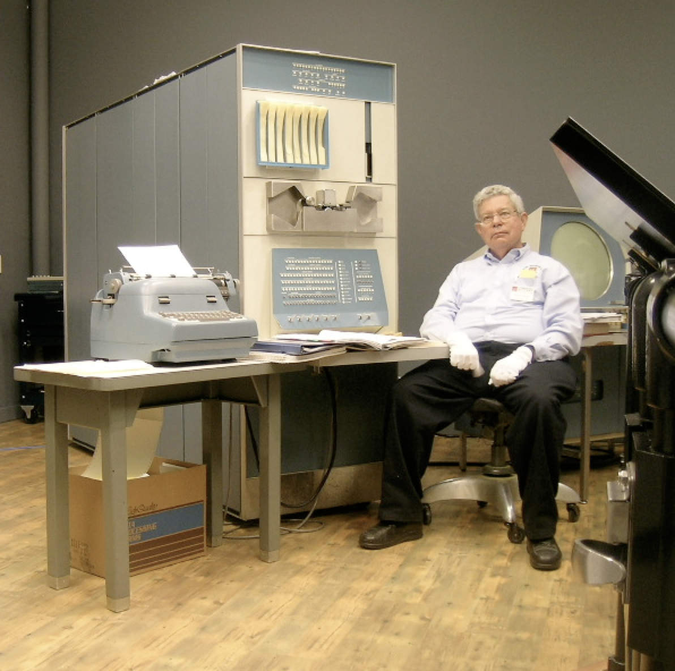
computers/_data/images/PDP1.png
