NoBlackBoxes/BlackBoxes/computers/_data/images/relay_circuit.png

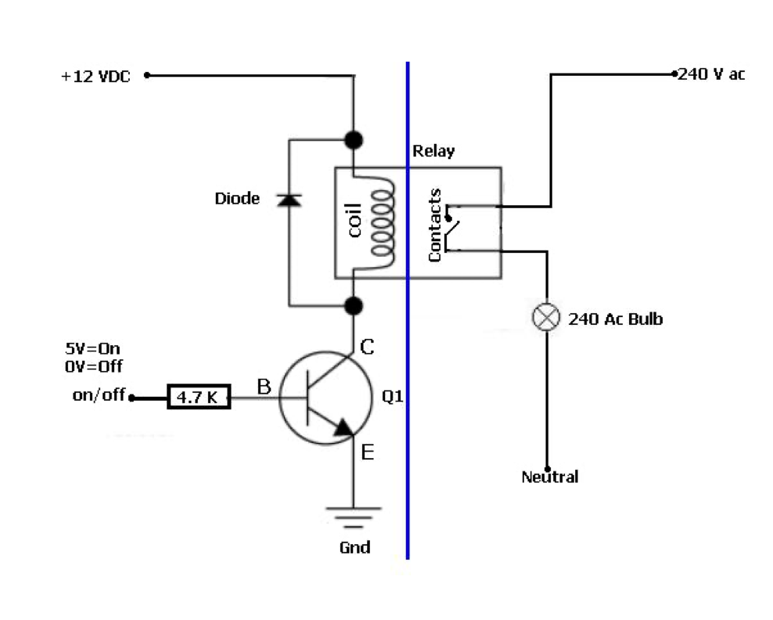
computers/_data/images/relay_circuit.png
