NoBlackBoxes/BlackBoxes/computers/_data/images/relay_schematic.png

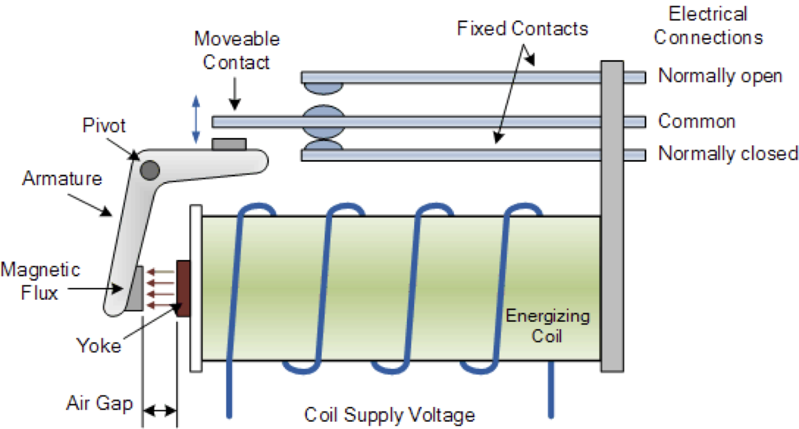
computers/_data/images/relay_schematic.png
