NoBlackBoxes/BlackBoxes/computers/_data/images/relays.png

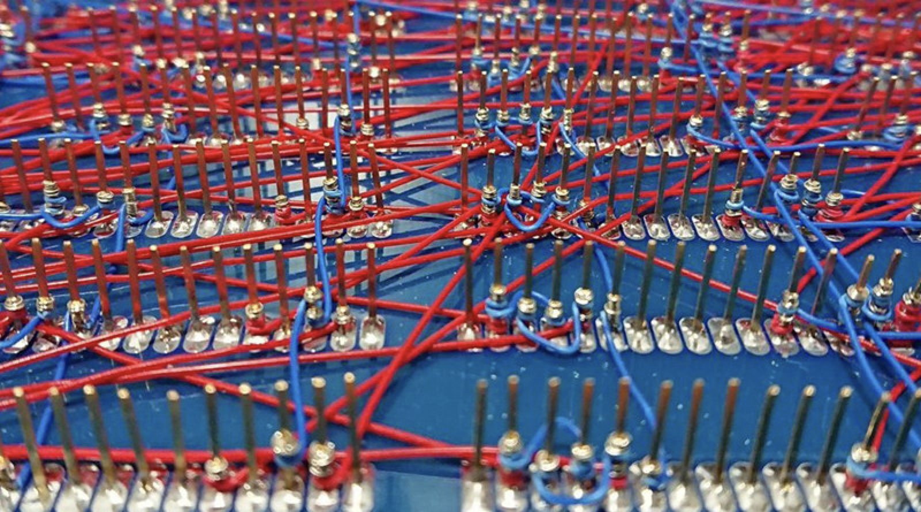
computers/_data/images/relays.png
