NoBlackBoxes/BlackBoxes/computers/_data/images/spacewar.png

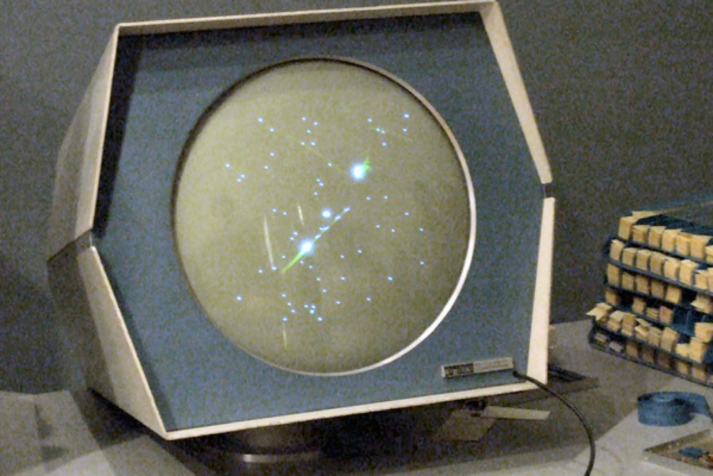
computers/_data/images/spacewar.png
