NoBlackBoxes/BlackBoxes/computers/_data/images/stereolithography.png

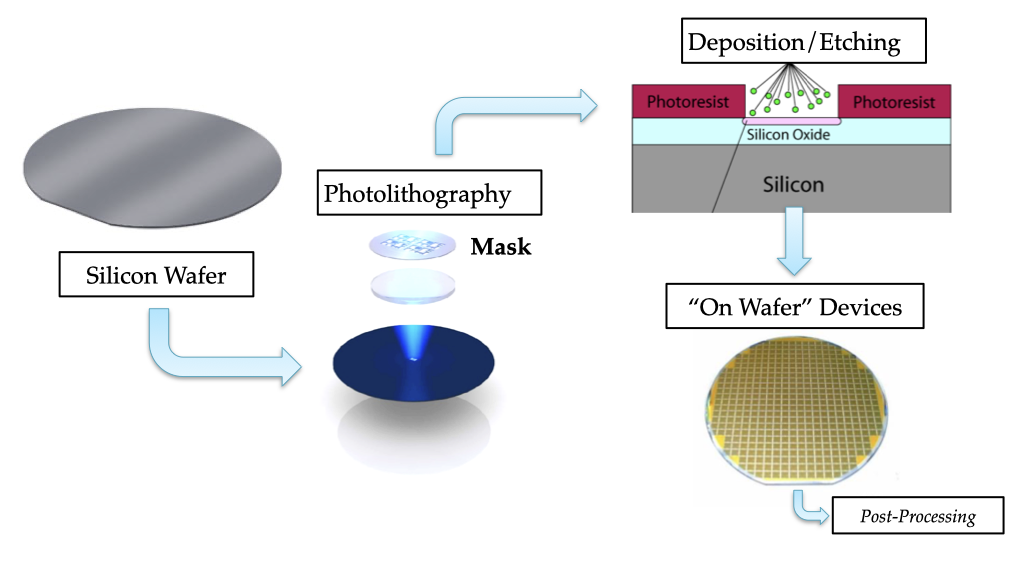
computers/_data/images/stereolithography.png
