NoBlackBoxes/BlackBoxes/computers/_data/images/stl_schematic.png

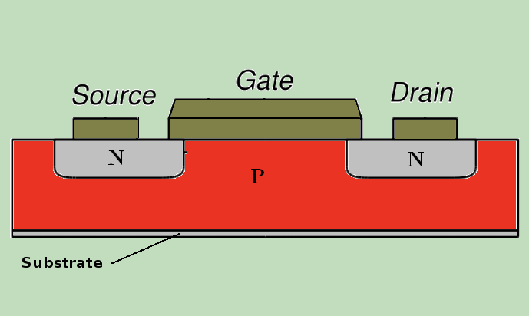
computers/_data/images/stl_schematic.png
