NoBlackBoxes/BlackBoxes/computers/_data/images/TommyFlowers.png

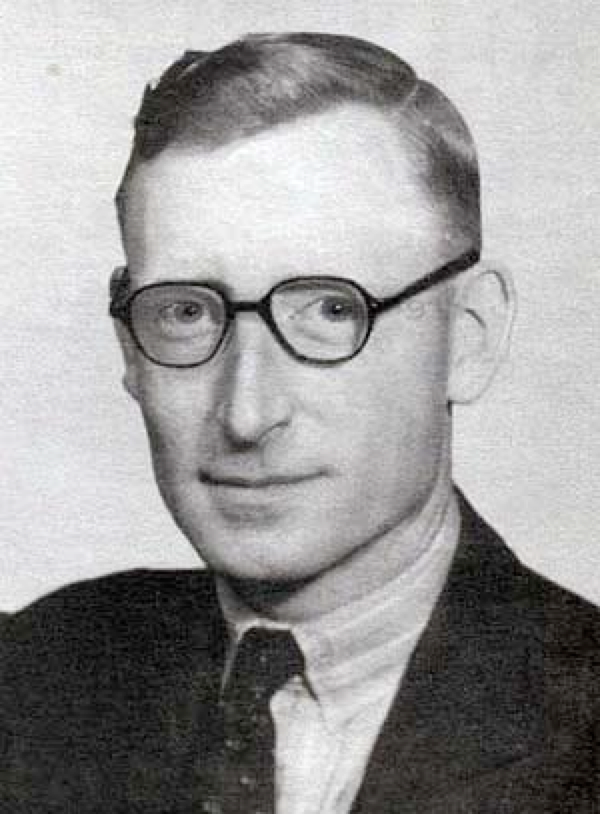
computers/_data/images/TommyFlowers.png
