NoBlackBoxes/BlackBoxes/computers/_data/images/transistor.png

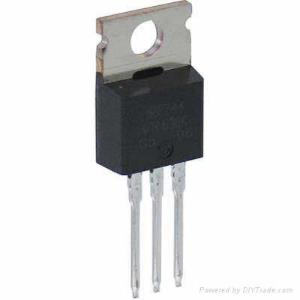
computers/_data/images/transistor.png
