NoBlackBoxes/BlackBoxes/computers/_data/images/transistor_schematic.png

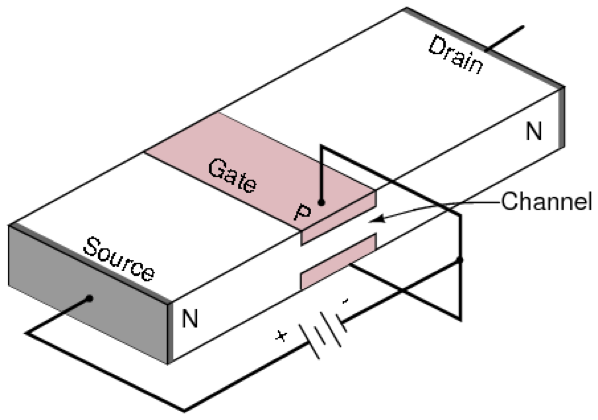
computers/_data/images/transistor_schematic.png
