NoBlackBoxes/BlackBoxes/computers/_data/images/vacuum_tube_video.png

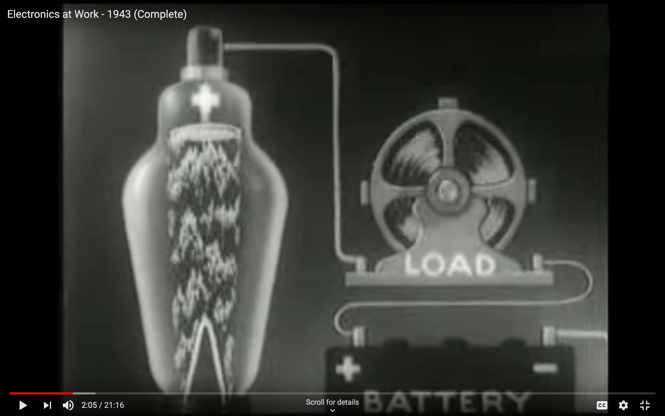
computers/_data/images/vacuum_tube_video.png
