NoBlackBoxes/BlackBoxes/computers/_data/images/vlsi_book.png

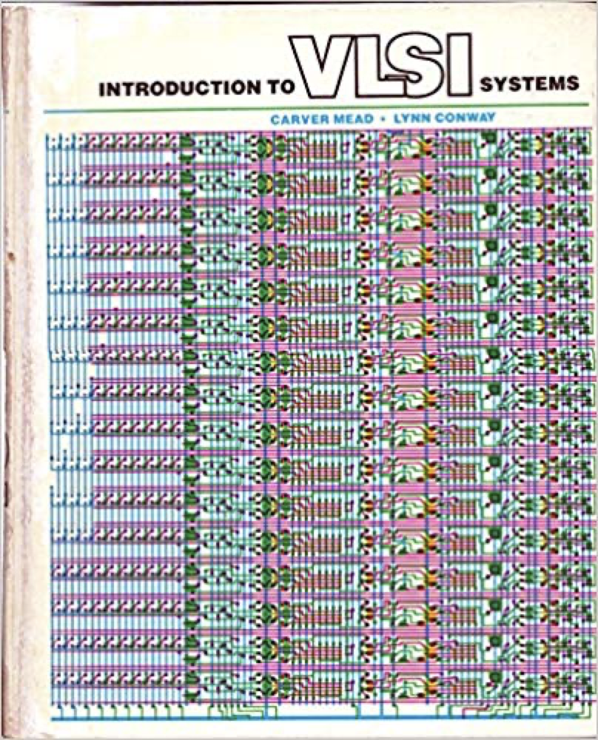
computers/_data/images/vlsi_book.png
