NoBlackBoxes/BlackBoxes/computers/_data/images/vlsi_image_sensor.png

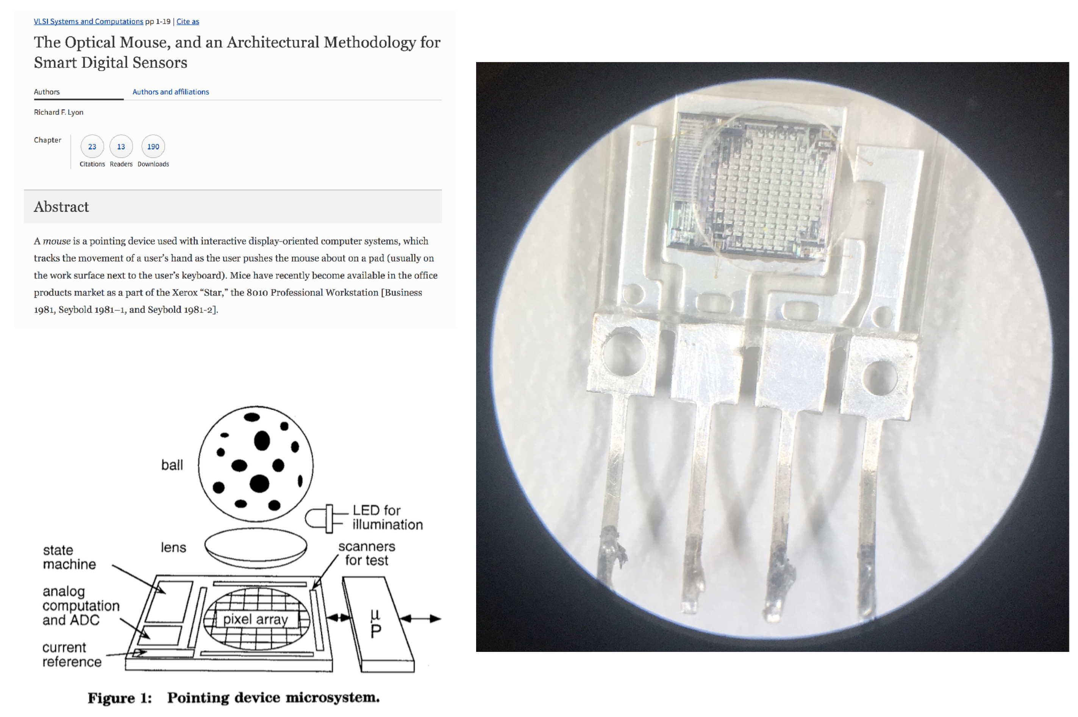
computers/_data/images/vlsi_image_sensor.png
