NoBlackBoxes/BlackBoxes/computers/_data/images/water_integrator.png

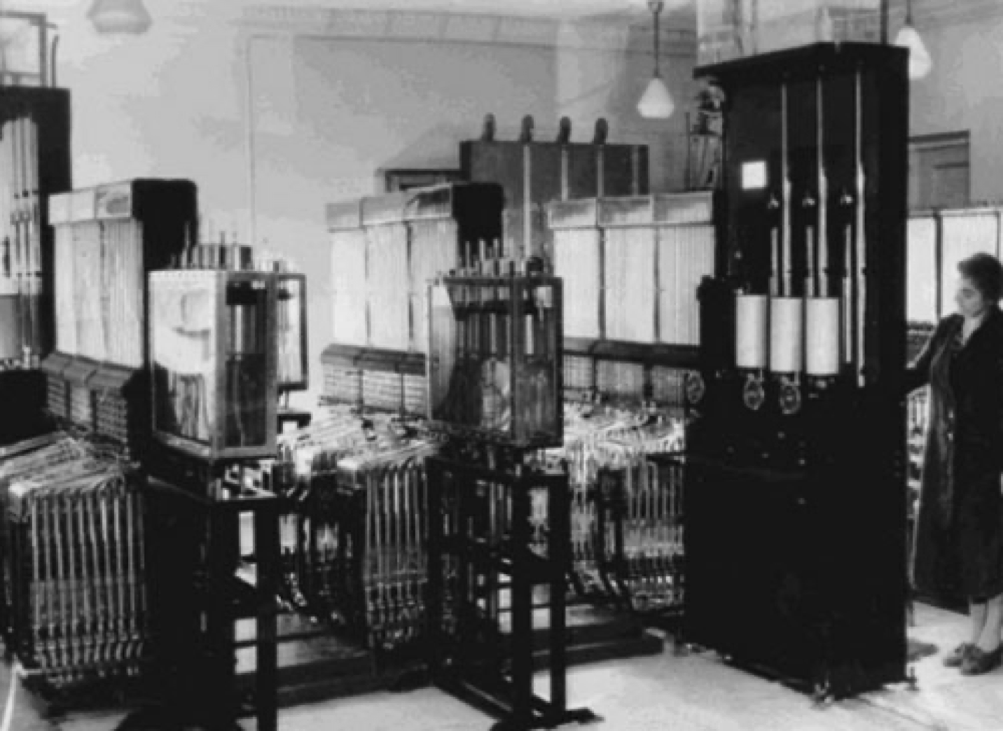
computers/_data/images/water_integrator.png
