NoBlackBoxes/BlackBoxes/computers/_data/images/Z2.png

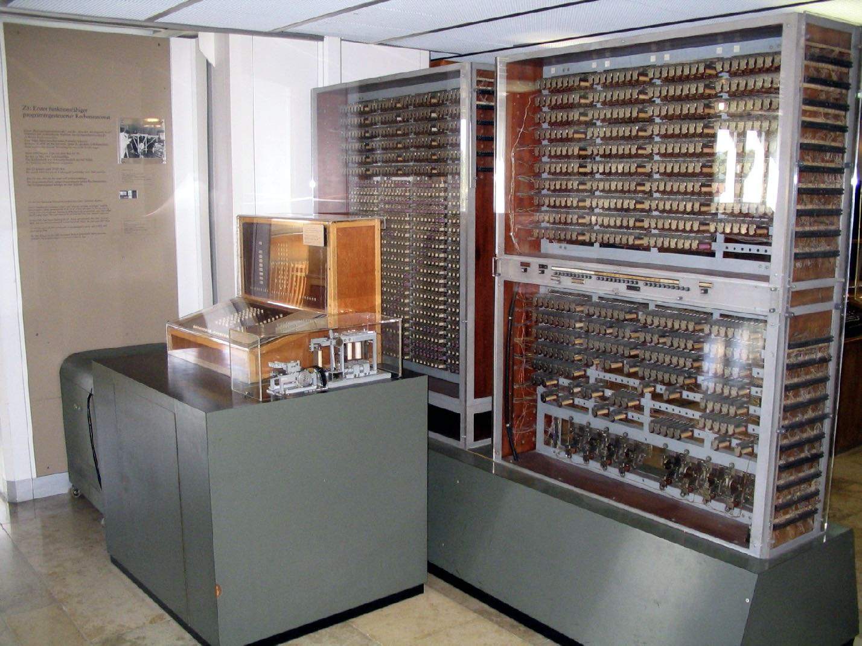
computers/_data/images/Z2.png
