NoBlackBoxes/BlackBoxes/computers/_data/images/Zuse.png

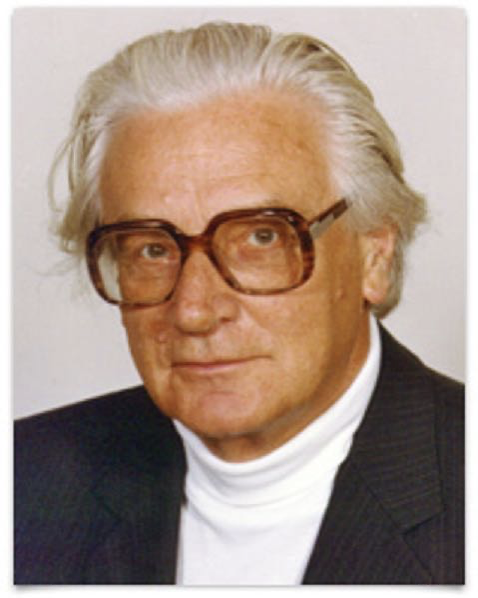
computers/_data/images/Zuse.png
