NoBlackBoxes/BlackBoxes/computers/programming/python/generate.png

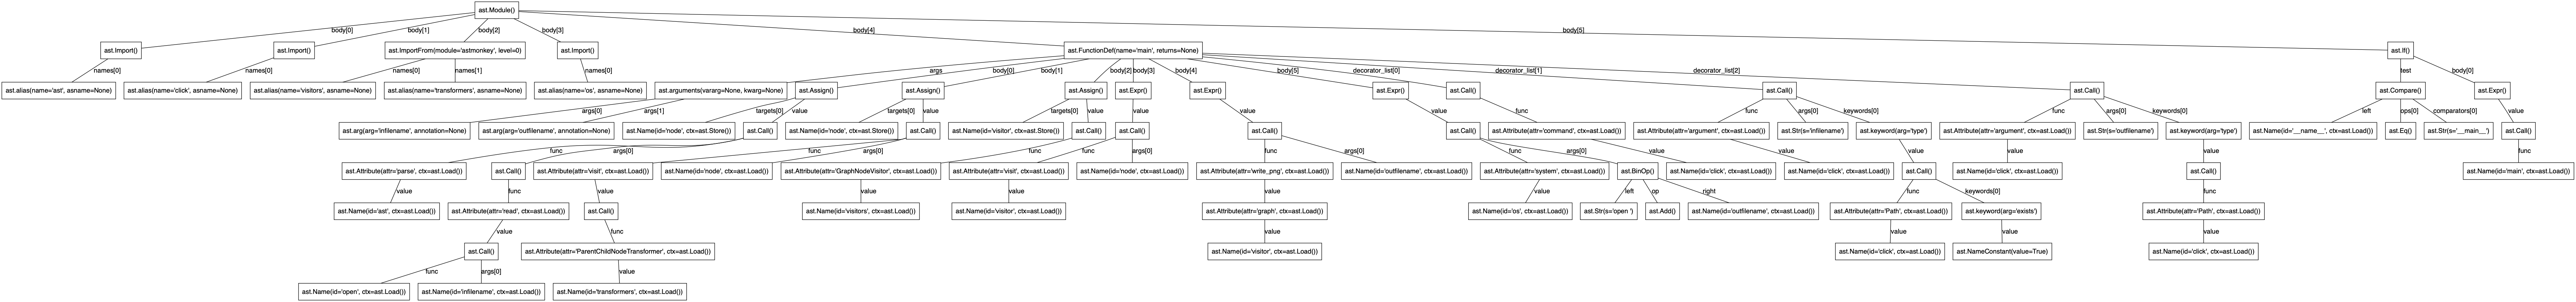
computers/programming/python/generate.png
