NoBlackBoxes/BlackBoxes/computers/programming/python/handmade_ast.png

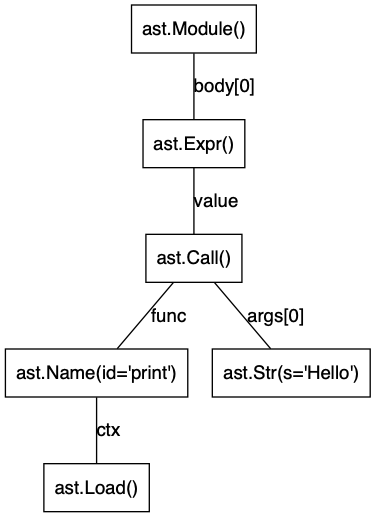
computers/programming/python/handmade_ast.png
