NoBlackBoxes/BlackBoxes/computers/programming/python/hello.png

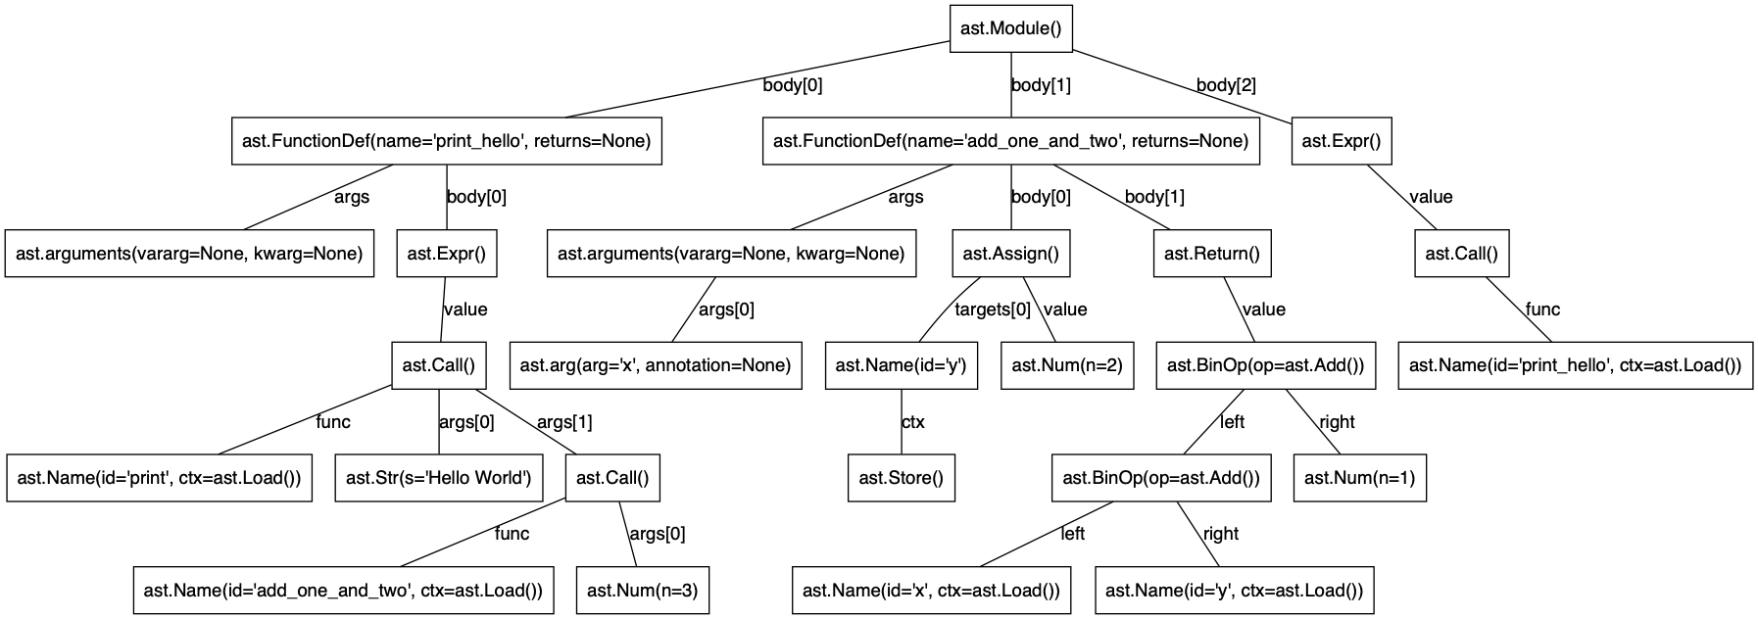
computers/programming/python/hello.png
