NoBlackBoxes/BlackBoxes/control/_data/images/NB3_control.png

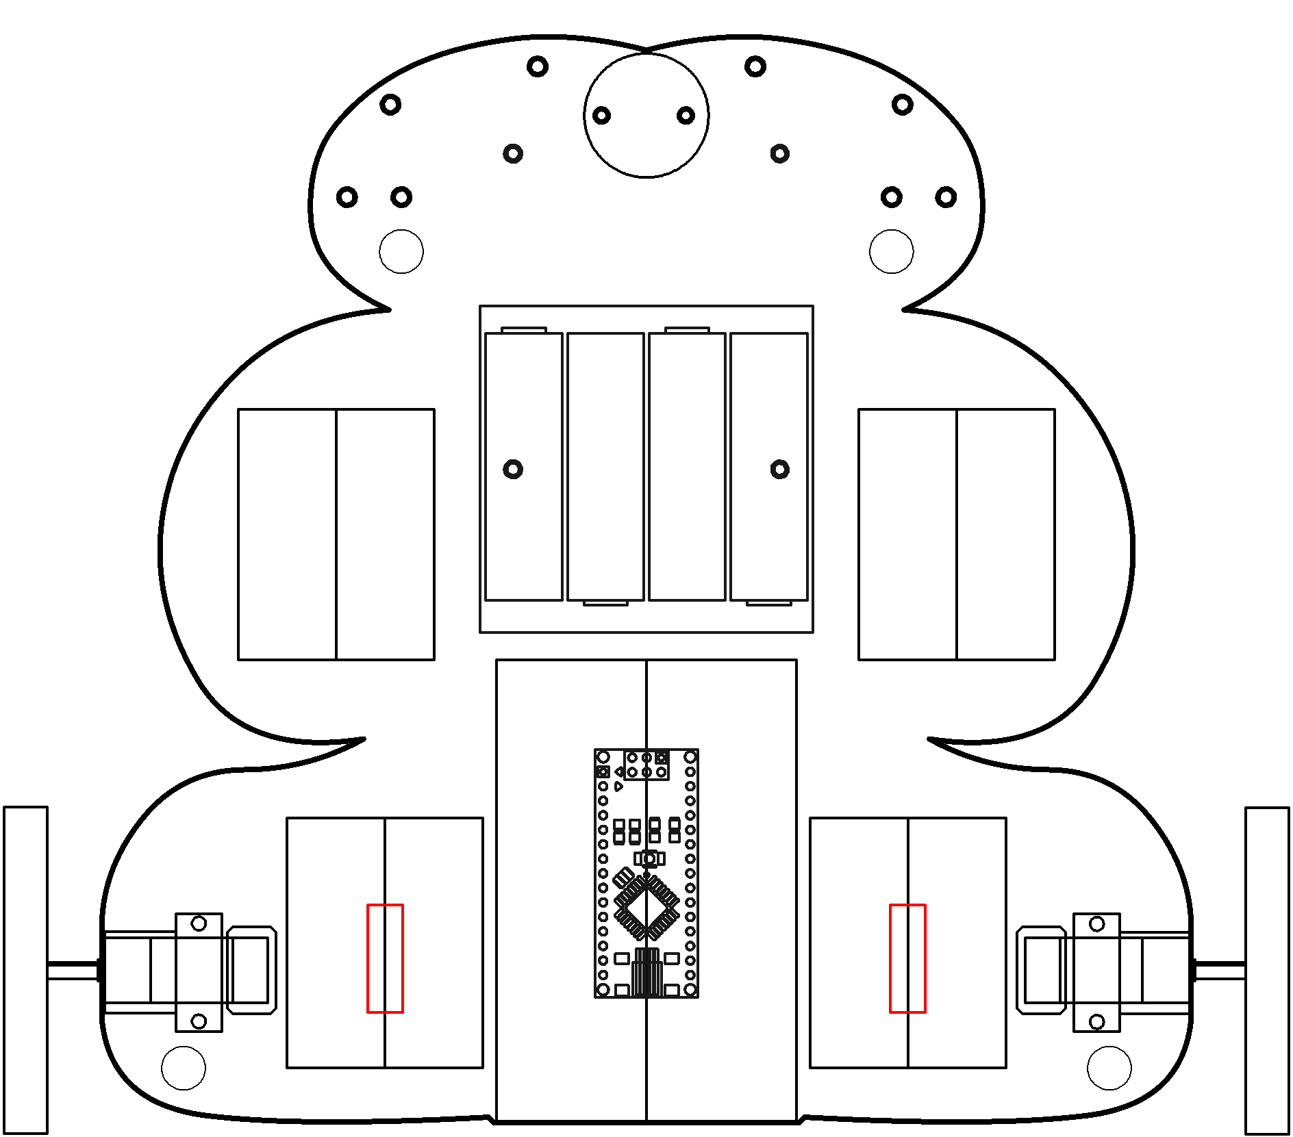
control/_data/images/NB3_control.png
