NoBlackBoxes/BlackBoxes/data/_data/images/comparator.gif

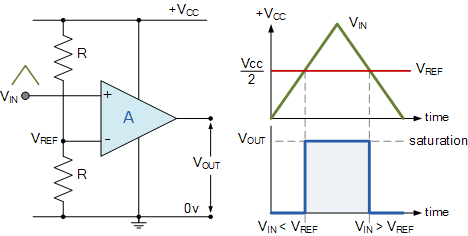
data/_data/images/comparator.gif
