NoBlackBoxes/BlackBoxes/data/_data/images/schmitt_trigger.png

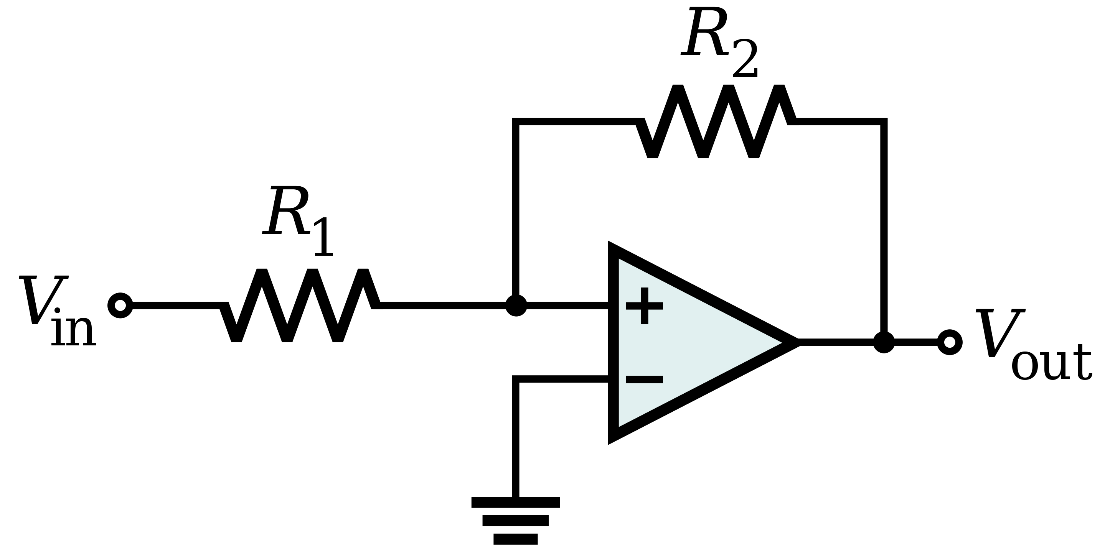
data/_data/images/schmitt_trigger.png
