NoBlackBoxes/BlackBoxes/data/_data/images/schmitt_trigger_transistors.png

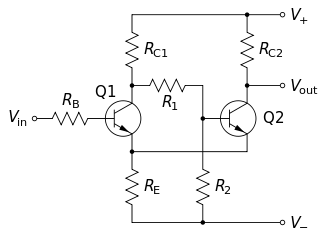
data/_data/images/schmitt_trigger_transistors.png
