NoBlackBoxes/BlackBoxes/data/_data/images/thresholds.jpeg

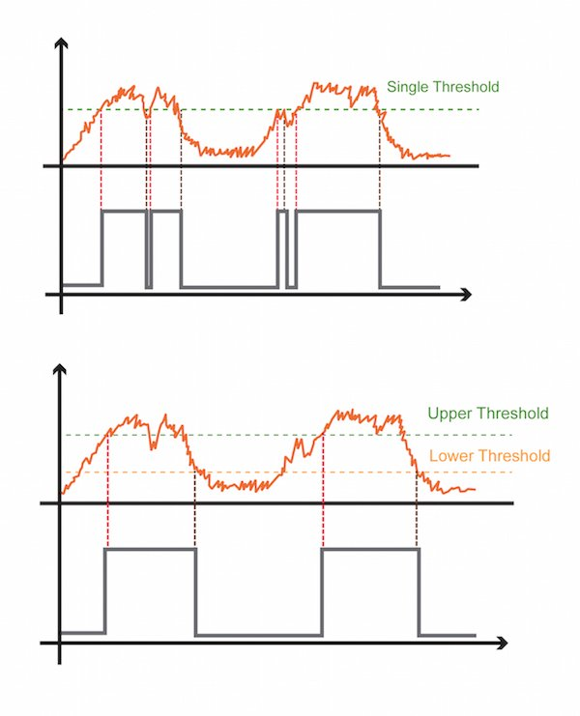
data/_data/images/thresholds.jpeg
