NoBlackBoxes/BlackBoxes/data/_data/images/trigger.jpeg

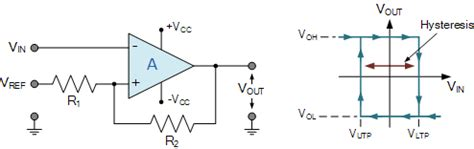
data/_data/images/trigger.jpeg
