NoBlackBoxes/BlackBoxes/electrons/NB3_body/NB3_body_back.png

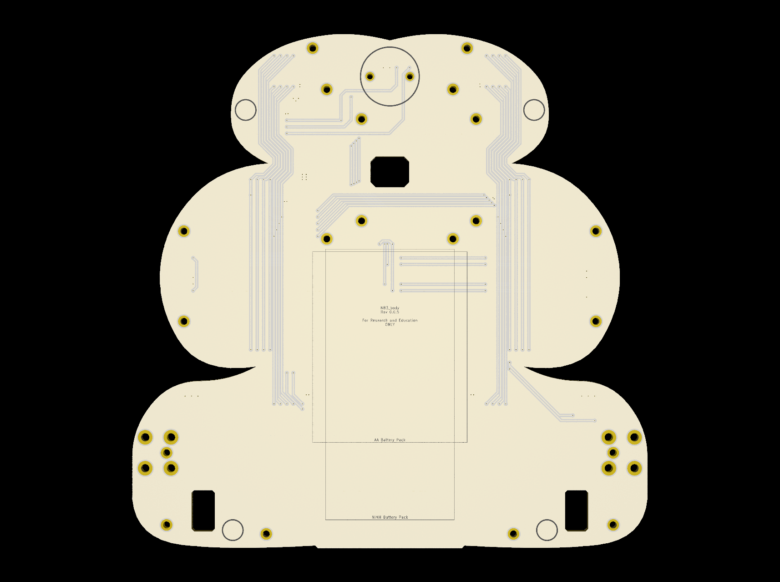
electrons/NB3_body/NB3_body_back.png
