NoBlackBoxes/BlackBoxes/electrons/NB3_body/NB3_body_front.png

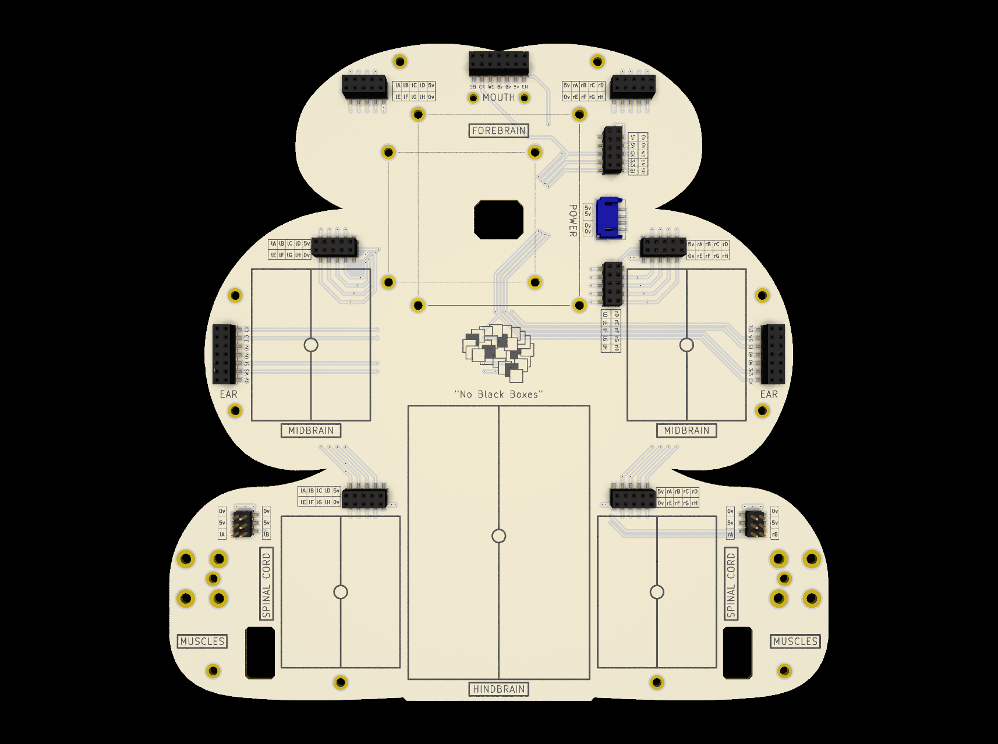
electrons/NB3_body/NB3_body_front.png
