NoBlackBoxes/BlackBoxes/fpgas/NB3_hindbrain/NB3_hindbrain_back.png

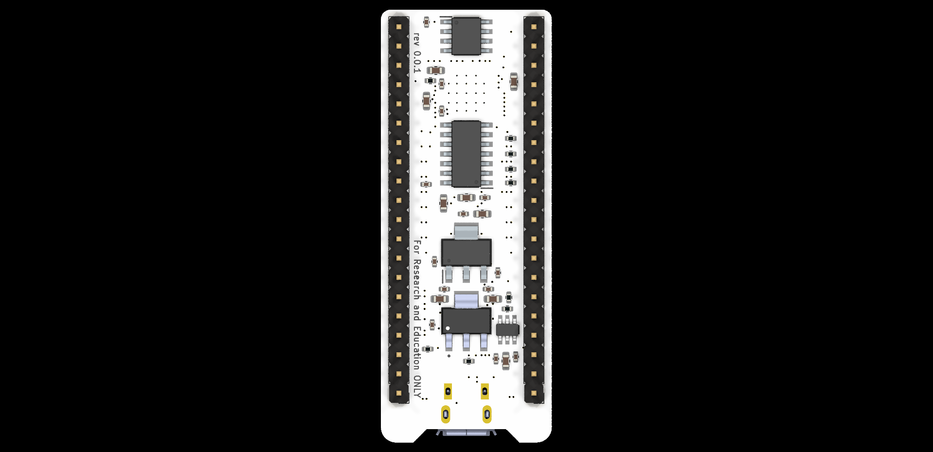
fpgas/NB3_hindbrain/NB3_hindbrain_back.png
