NoBlackBoxes/BlackBoxes/intelligence/_data/images/NB3_intelligence.png

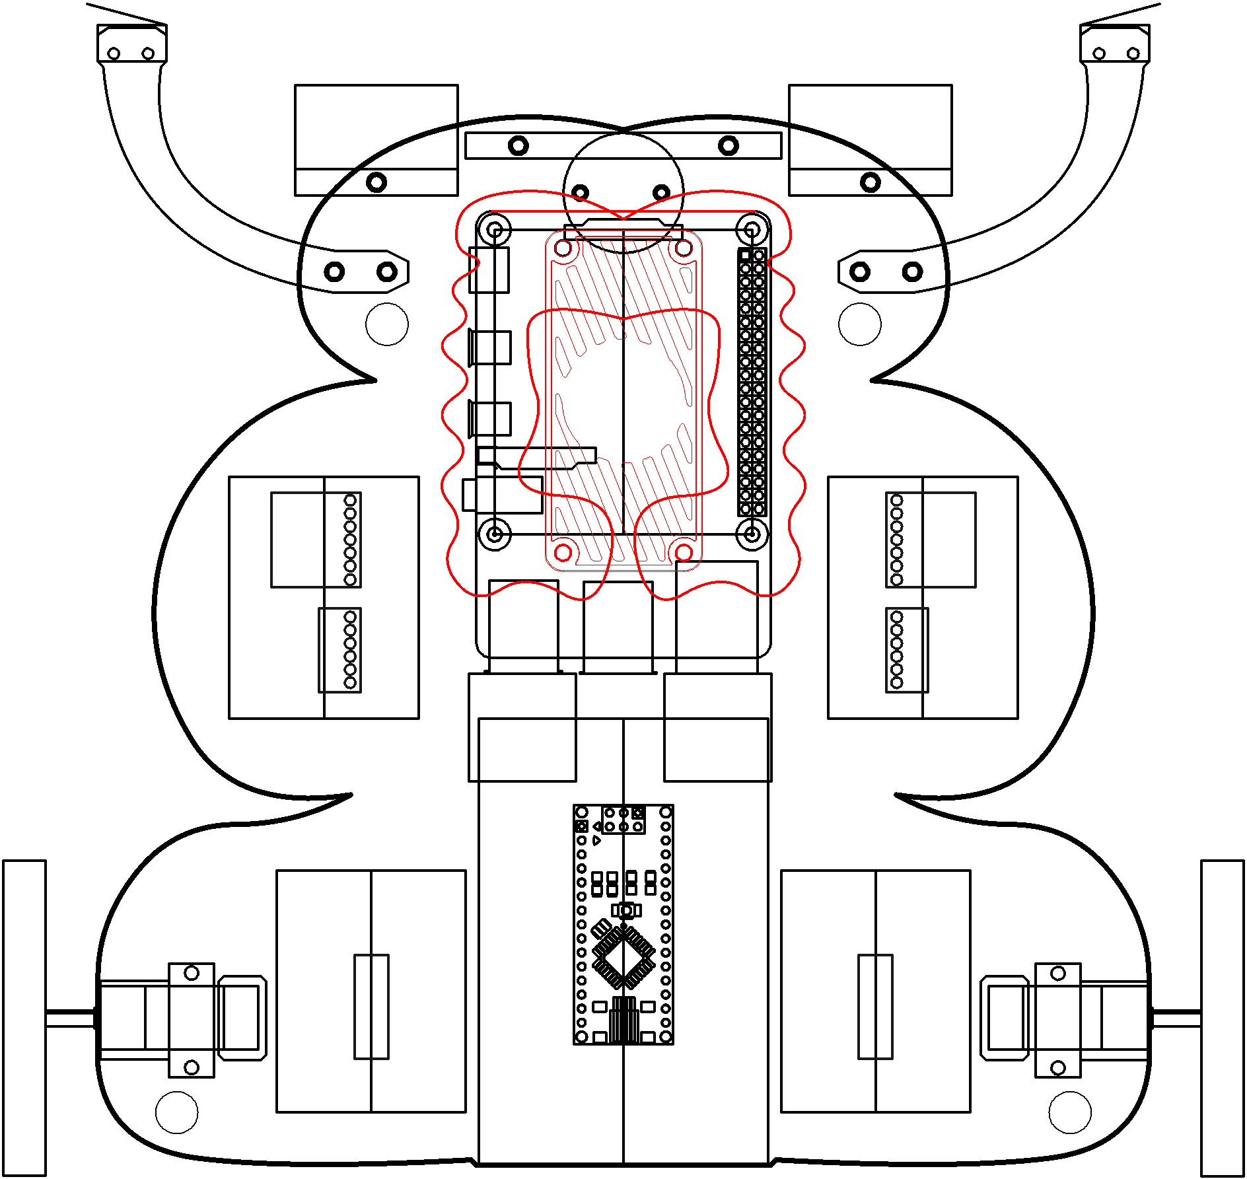
intelligence/_data/images/NB3_intelligence.png
