NoBlackBoxes/BlackBoxes/intelligence/transformers/vision/_data/zoom_lesson.jpg

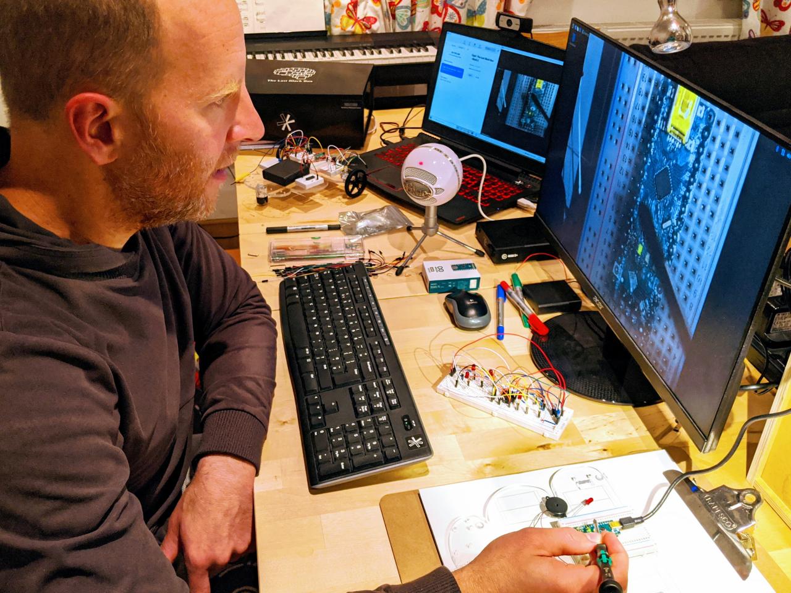
intelligence/transformers/vision/_data/zoom_lesson.jpg
