NoBlackBoxes/BlackBoxes/learning/transfer/backbone/_data/dog.jpg

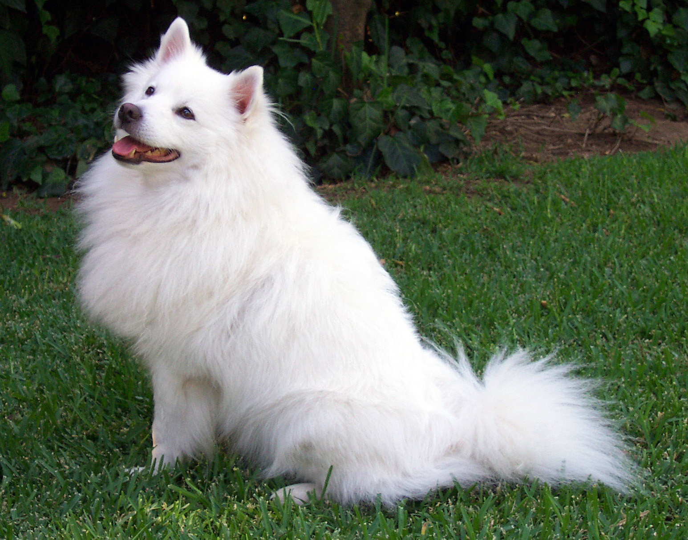
learning/transfer/backbone/_data/dog.jpg
