NoBlackBoxes/BlackBoxes/linux/_data/Tux.png

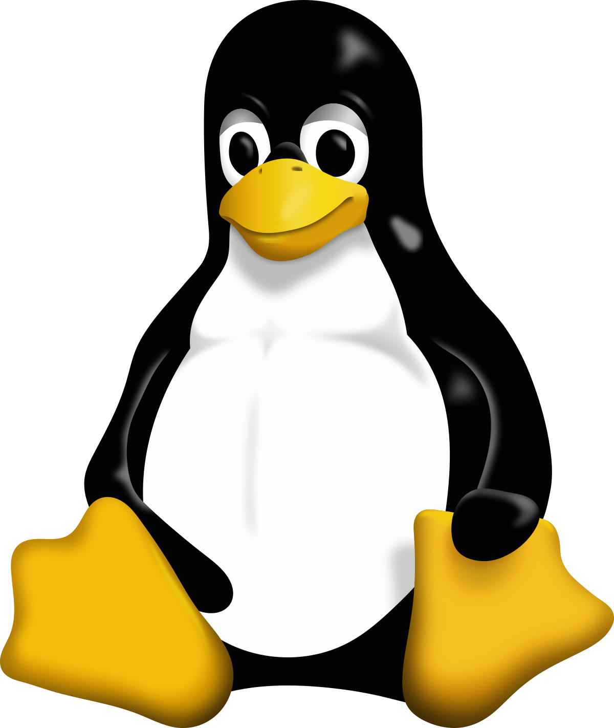
linux/_data/Tux.png
