NoBlackBoxes/BlackBoxes/logic/_data/images/2bit_adder.png

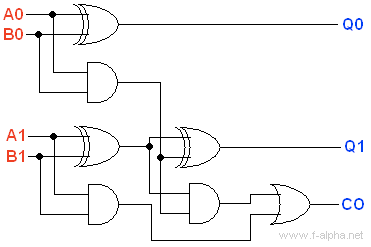
logic/_data/images/2bit_adder.png
