NoBlackBoxes/BlackBoxes/logic/_data/images/3bit_adder2.png

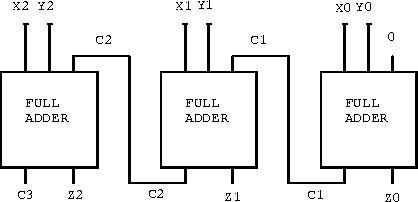
logic/_data/images/3bit_adder2.png
