NoBlackBoxes/BlackBoxes/logic/_data/images/3bit_adder.png

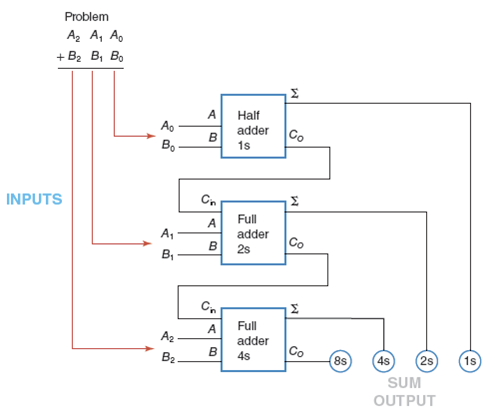
logic/_data/images/3bit_adder.png
