NoBlackBoxes/BlackBoxes/logic/_data/images/adder.png

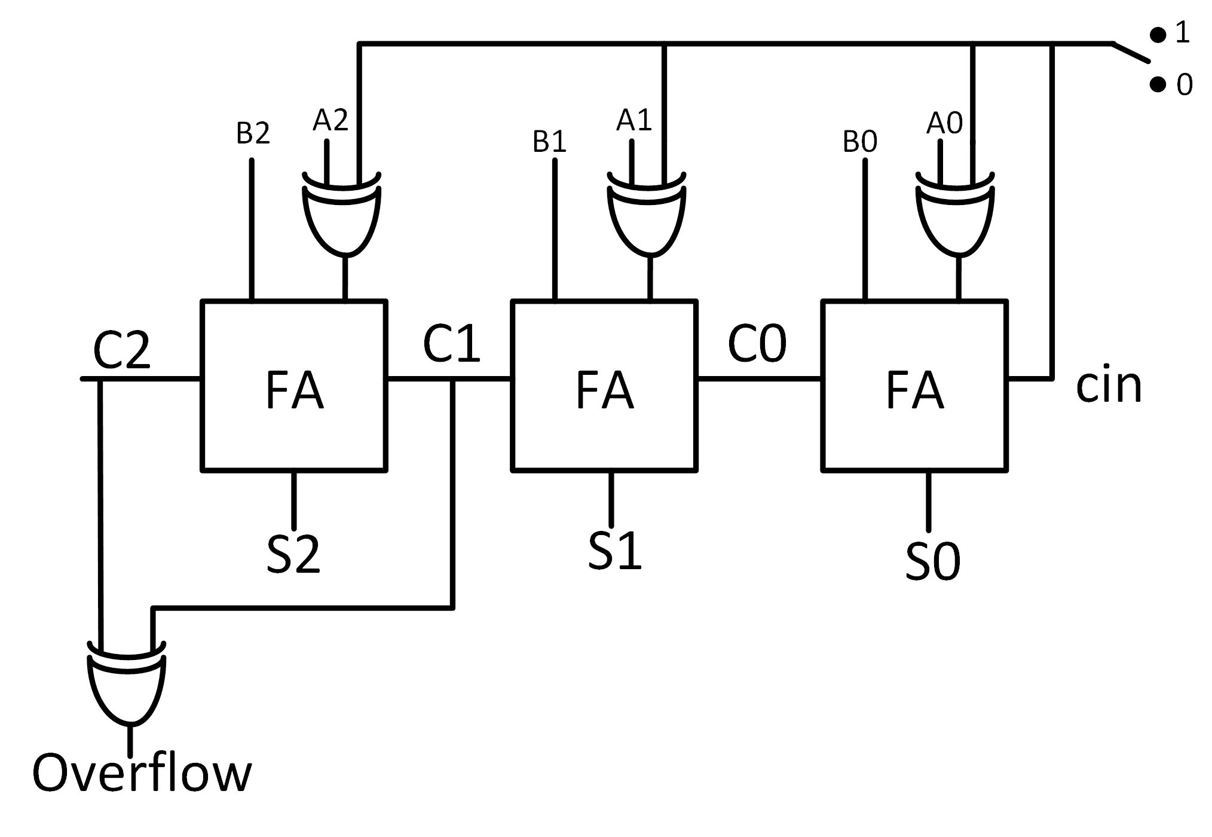
logic/_data/images/adder.png
