NoBlackBoxes/BlackBoxes/logic/_data/images/adders.png

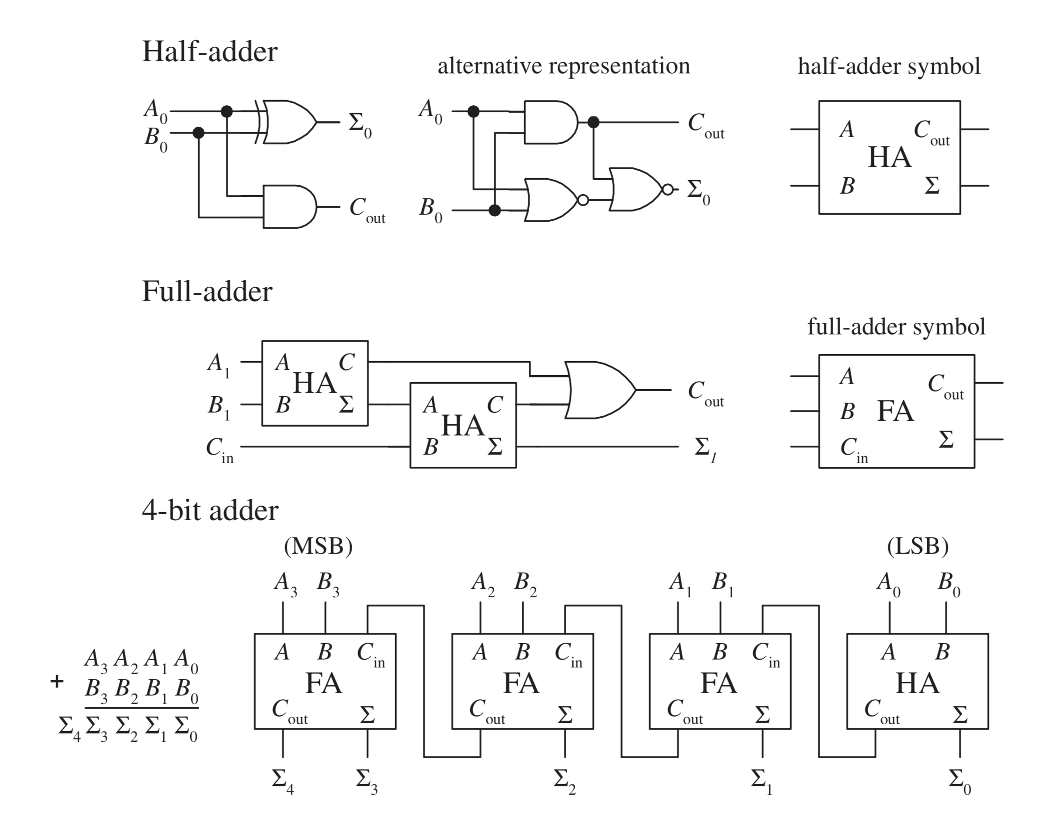
logic/_data/images/adders.png
