NoBlackBoxes/BlackBoxes/logic/_data/images/and_gate.png

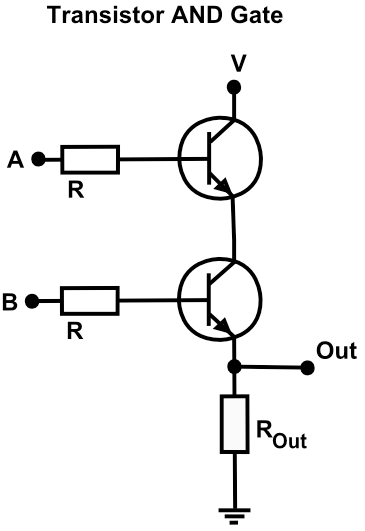
logic/_data/images/and_gate.png
