NoBlackBoxes/BlackBoxes/logic/_data/images/cmos_gate_quiz.png

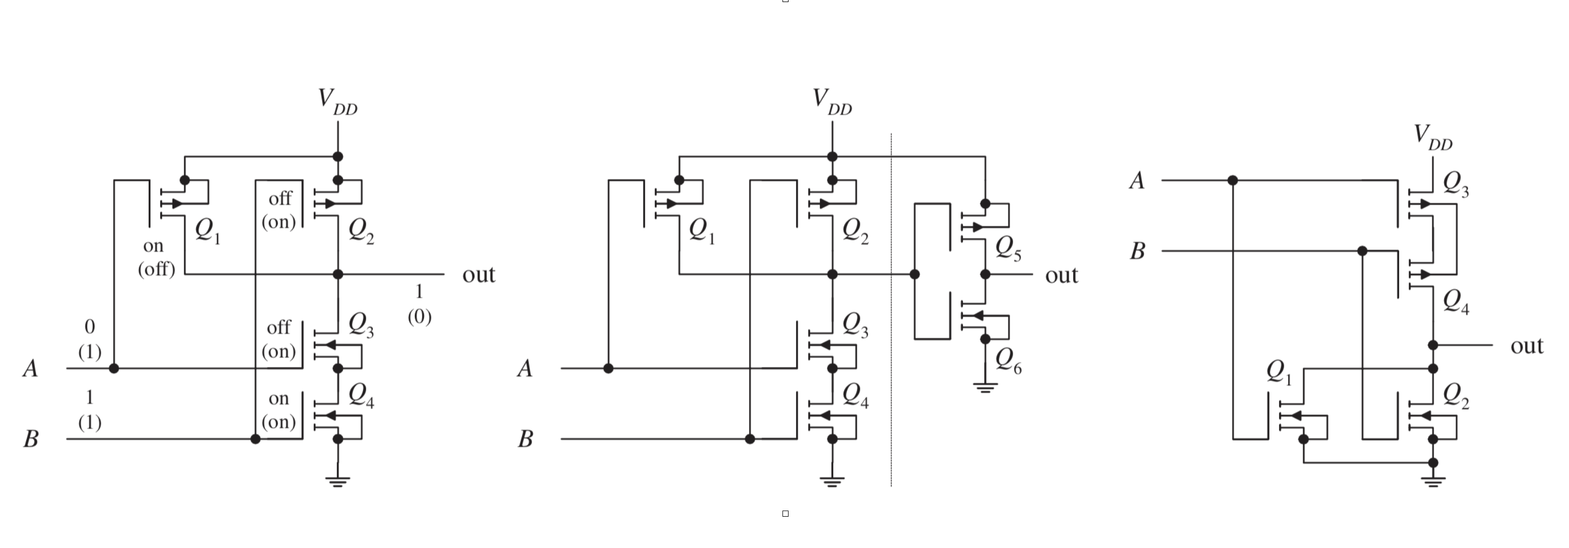
logic/_data/images/cmos_gate_quiz.png
