NoBlackBoxes/BlackBoxes/logic/_data/images/diode_XNOR.png

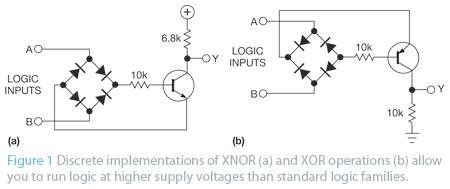
logic/_data/images/diode_XNOR.png
