NoBlackBoxes/BlackBoxes/logic/_data/images/full_1bitadder.png

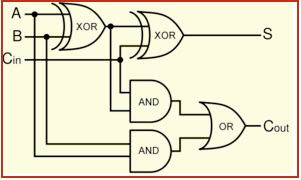
logic/_data/images/full_1bitadder.png
