NoBlackBoxes/BlackBoxes/logic/_data/images/gate_quiz.png

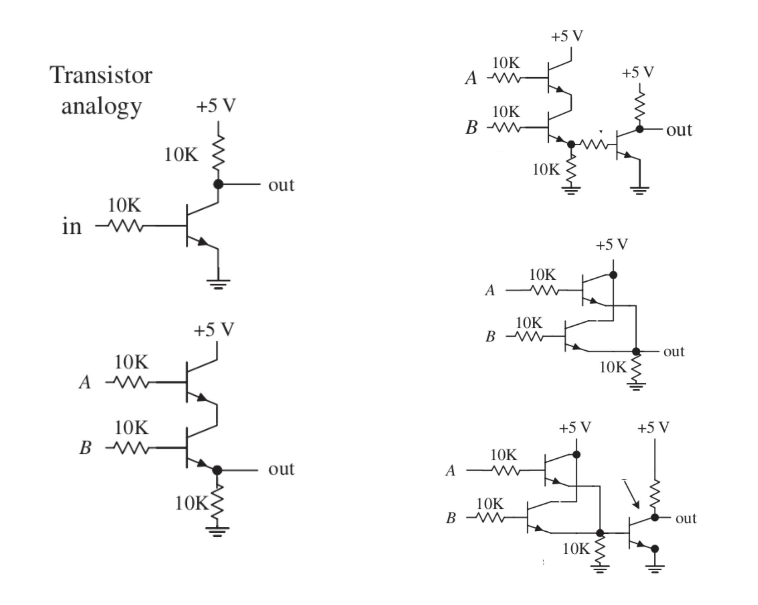
logic/_data/images/gate_quiz.png
