NoBlackBoxes/BlackBoxes/logic/_data/images/gates.png

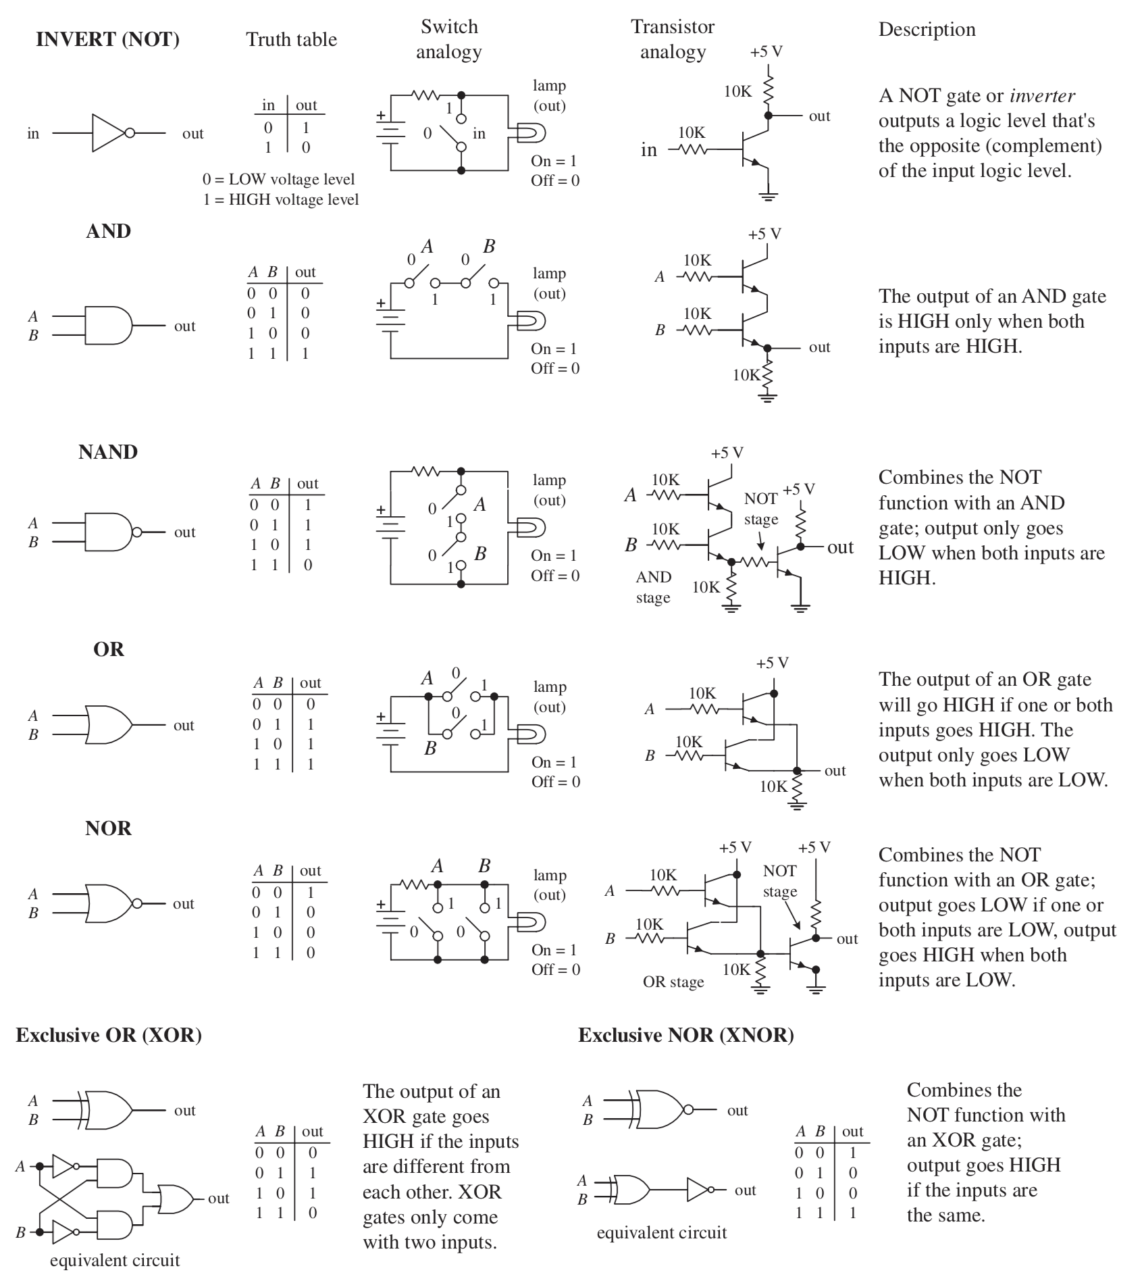
logic/_data/images/gates.png
