NoBlackBoxes/BlackBoxes/logic/_data/images/half_1bit_adder.png

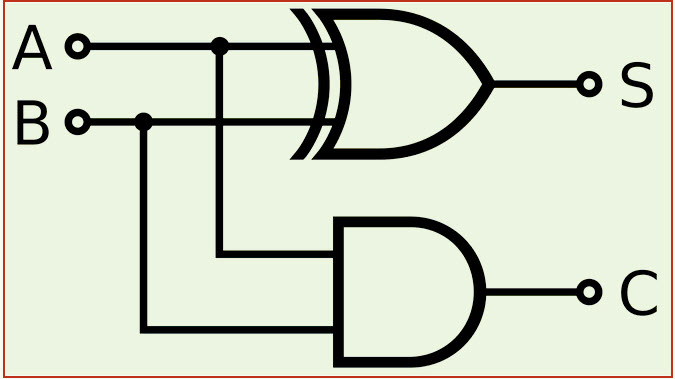
logic/_data/images/half_1bit_adder.png
