NoBlackBoxes/BlackBoxes/logic/_data/images/hex_pronunciation.jpg

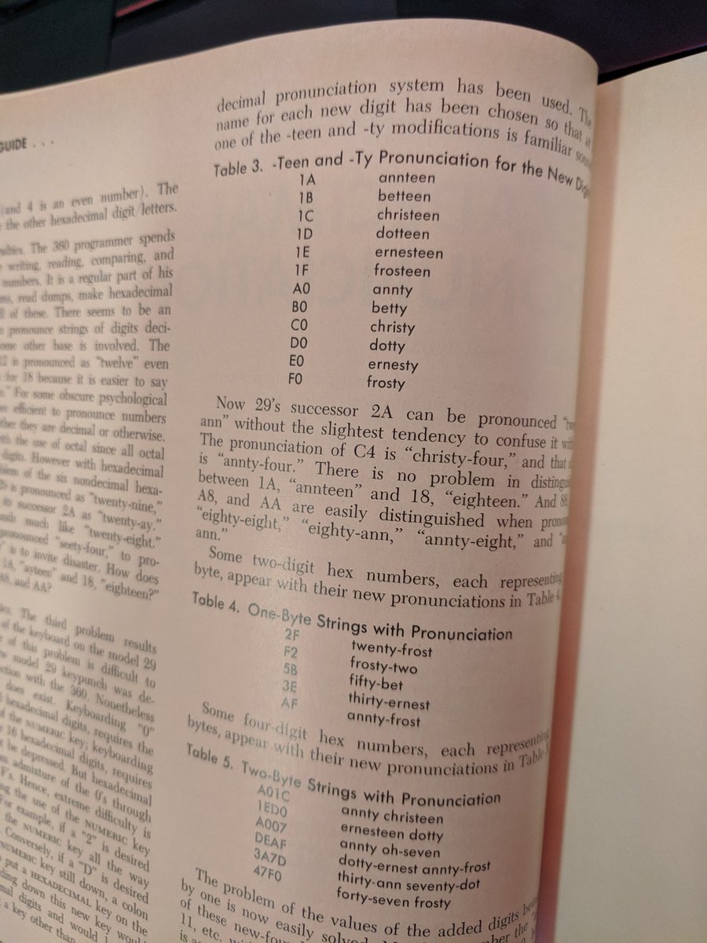
logic/_data/images/hex_pronunciation.jpg
