NoBlackBoxes/BlackBoxes/logic/_data/images/logic_symbols.png

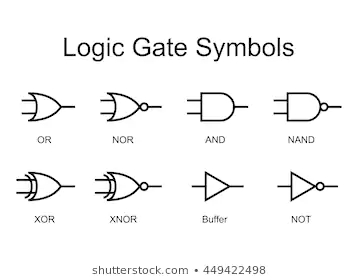
logic/_data/images/logic_symbols.png
