NoBlackBoxes/BlackBoxes/logic/_data/images/or_gate.png

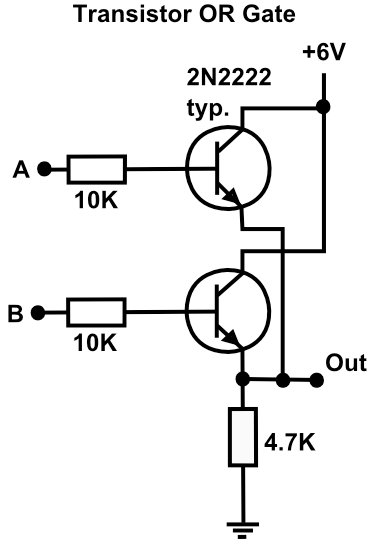
logic/_data/images/or_gate.png
