NoBlackBoxes/BlackBoxes/memory/_data/images/nandlatch.png

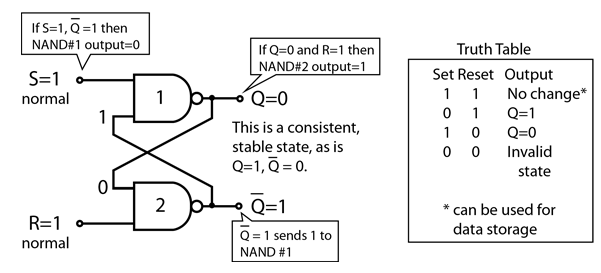
memory/_data/images/nandlatch.png
