NoBlackBoxes/BlackBoxes/networks/_data/images/Internet_map_in_February_82.png

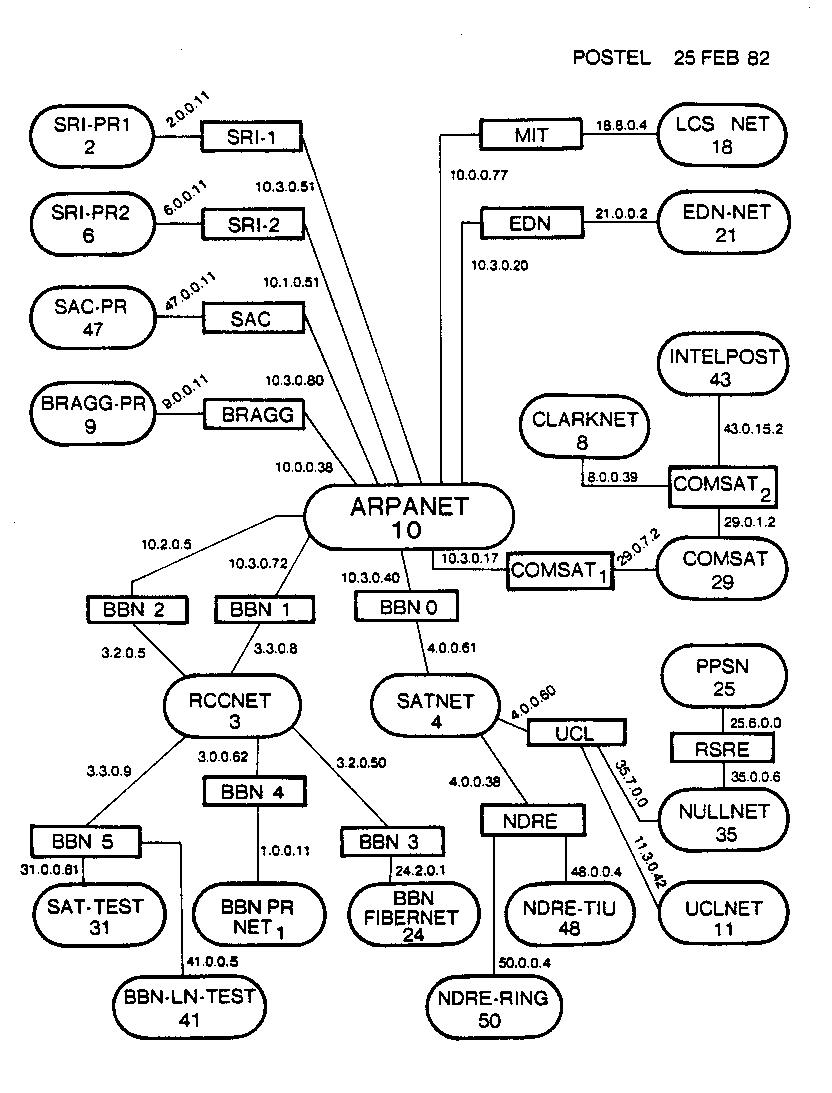
networks/_data/images/Internet_map_in_February_82.png
