NoBlackBoxes/BlackBoxes/power/NB3_power/NB3_power_back.png

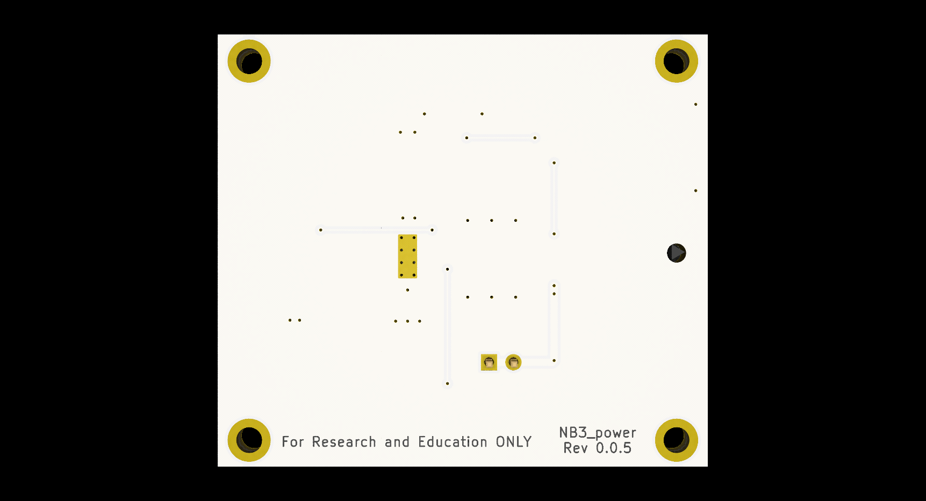
power/NB3_power/NB3_power_back.png
