NoBlackBoxes/BlackBoxes/power/NB3_power/NB3_power_front.png

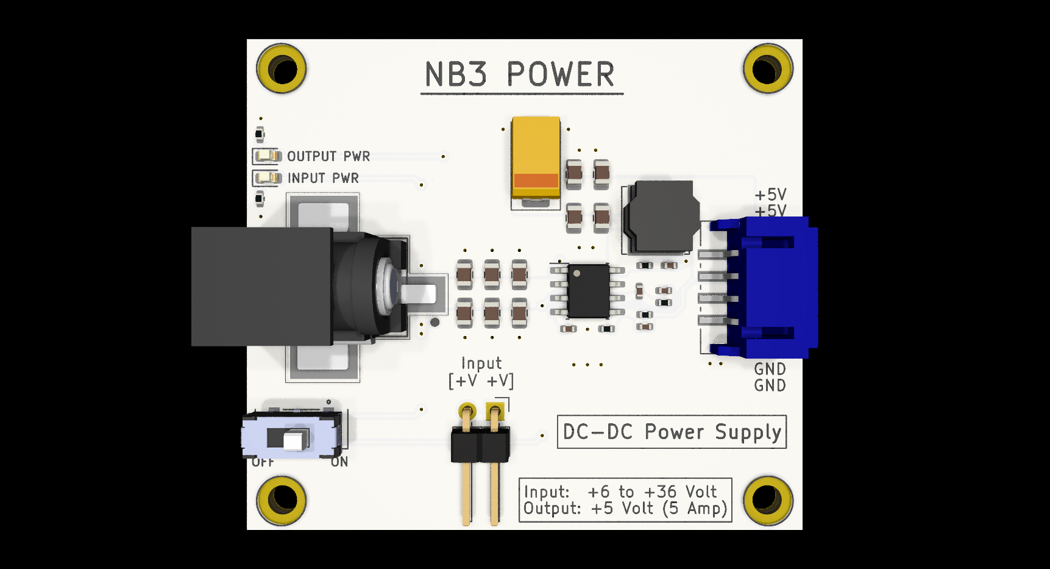
power/NB3_power/NB3_power_front.png
