NoBlackBoxes/BlackBoxes/python/_data/image.jpeg

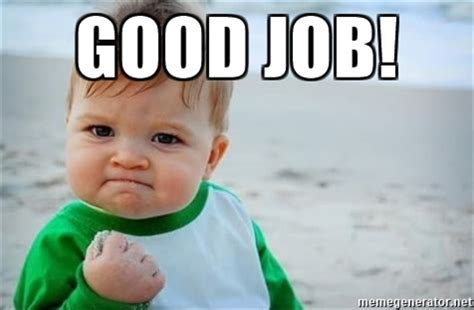
python/_data/image.jpeg
