NoBlackBoxes/BlackBoxes/robotics/_data/datasheets/micro_limit_switch.jpg

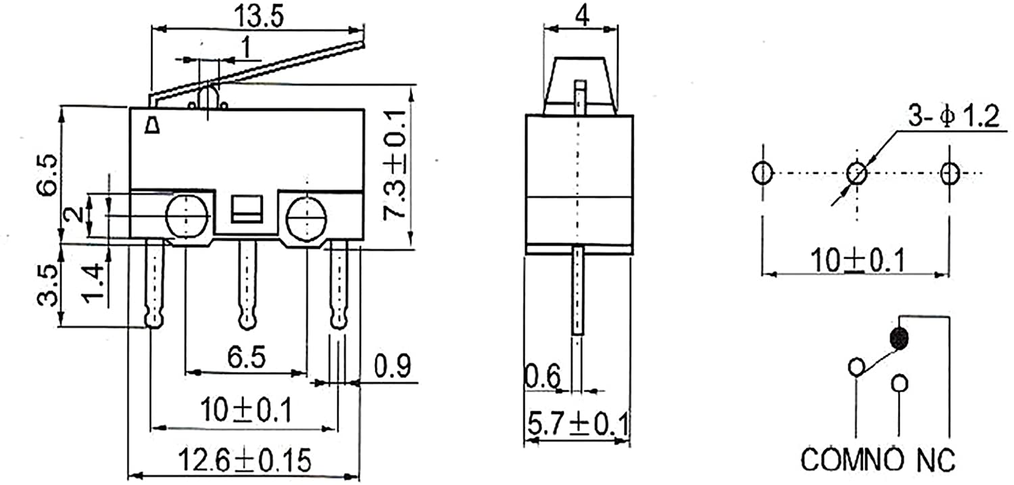
robotics/_data/datasheets/micro_limit_switch.jpg
