NoBlackBoxes/BlackBoxes/robotics/_data/images/NB3_behaviour.png

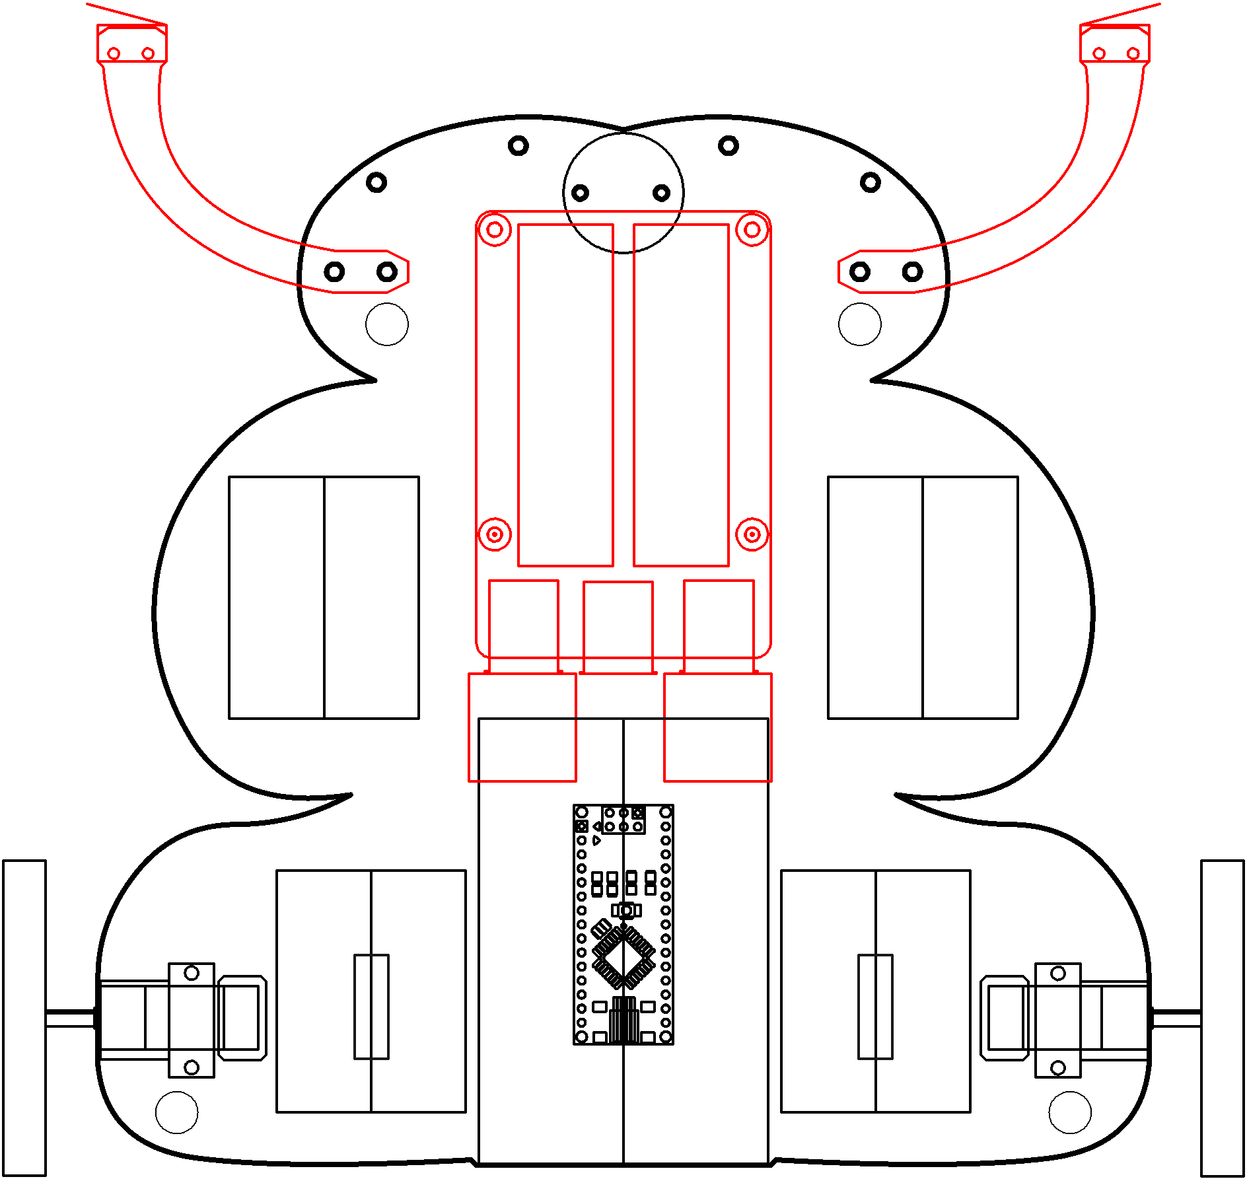
robotics/_data/images/NB3_behaviour.png
