NoBlackBoxes/BlackBoxes/systems/_data/datasheets/rpi4b_heatsinks.jpg

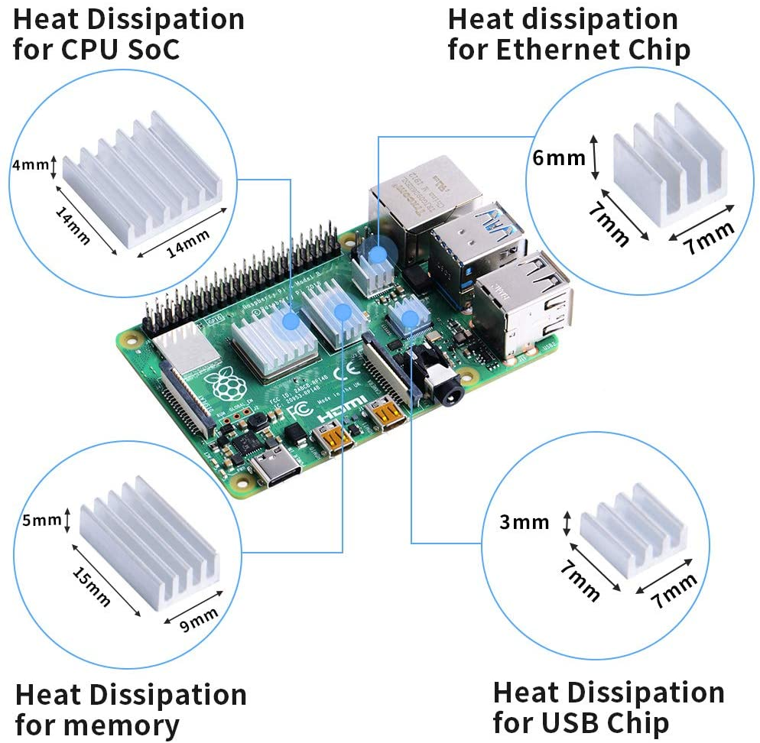
systems/_data/datasheets/rpi4b_heatsinks.jpg
