NoBlackBoxes/BlackBoxes/systems/_data/datasheets/speakers_3W.jpg

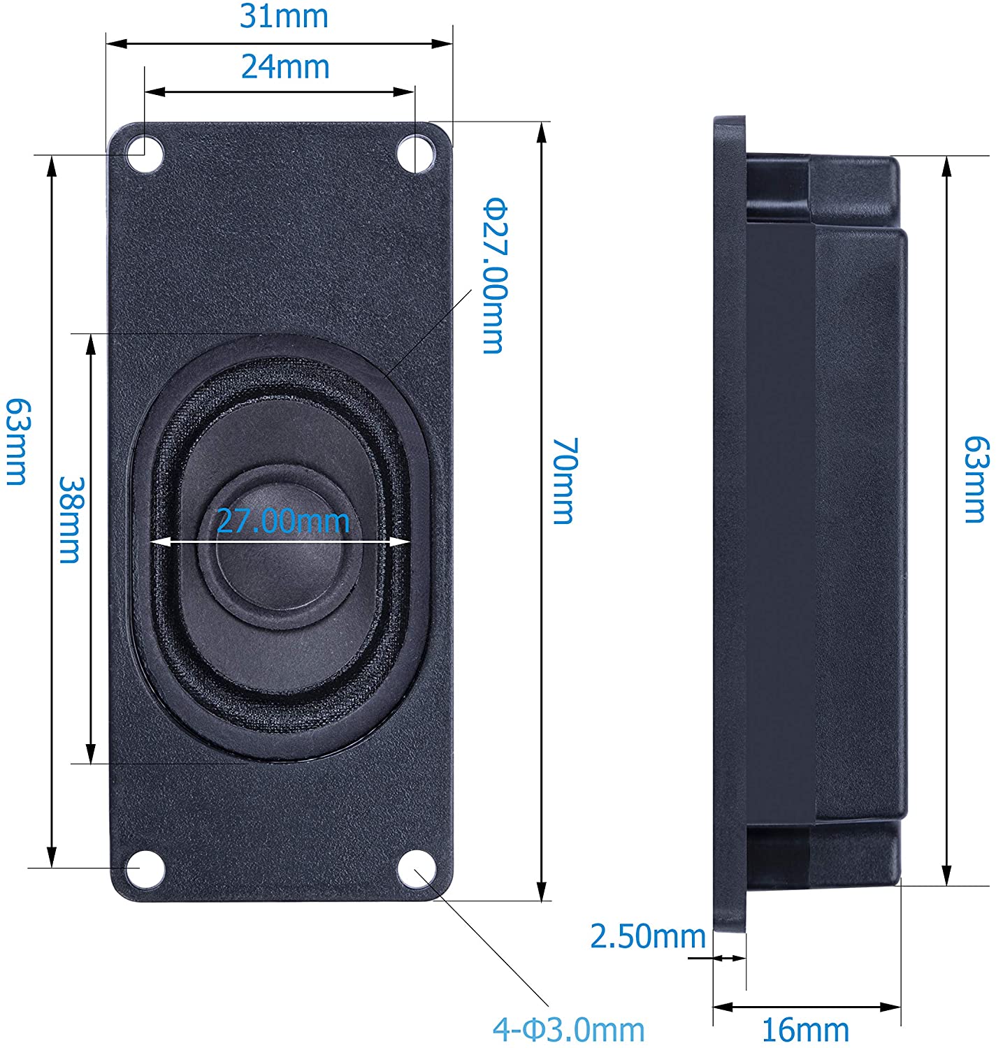
systems/_data/datasheets/speakers_3W.jpg
