NoBlackBoxes/BlackBoxes/systems/connecting/resources/images/nmap_output.png

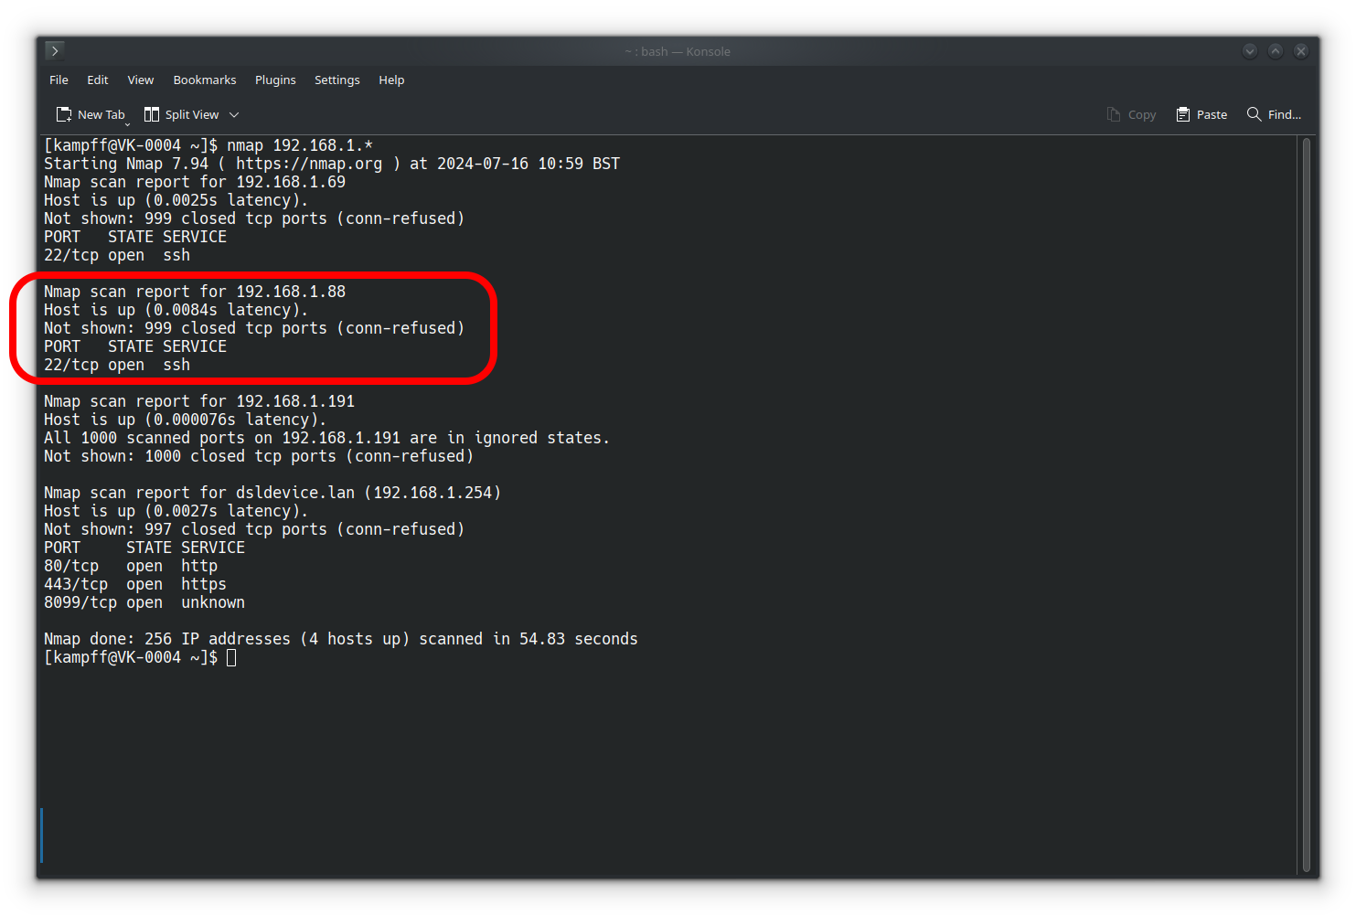
systems/connecting/resources/images/nmap_output.png
