NoBlackBoxes/BlackBoxes/systems/connecting/resources/images/raspi_config_interface_menu.png

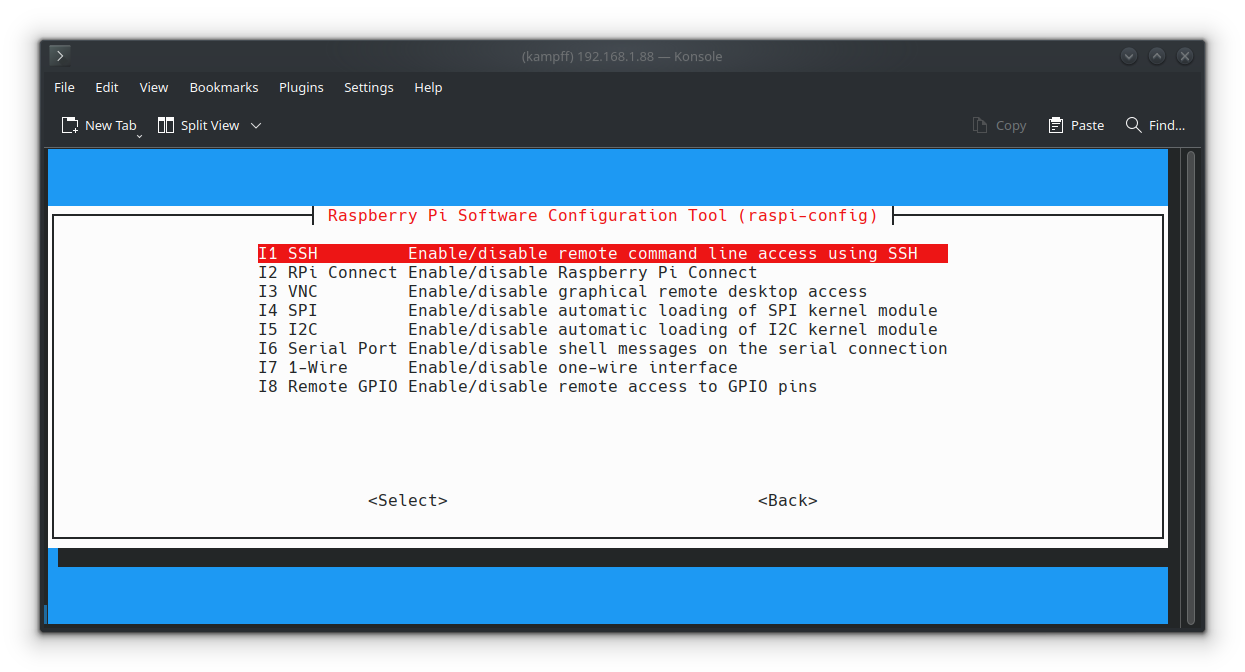
systems/connecting/resources/images/raspi_config_interface_menu.png
