NoBlackBoxes/BlackBoxes/systems/connecting/resources/images/raspi_config_main_menu.png

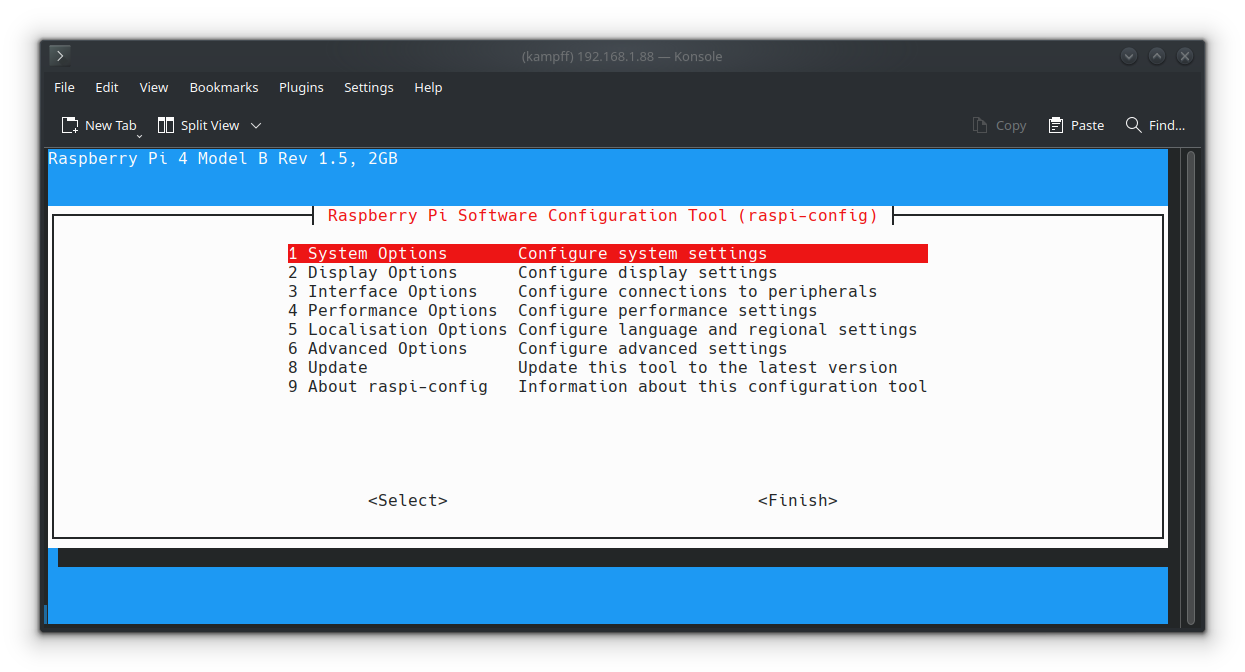
systems/connecting/resources/images/raspi_config_main_menu.png
