NoBlackBoxes/BlackBoxes/systems/connecting/resources/images/remote-ssh-button.png

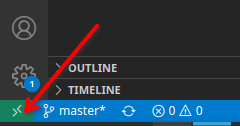
systems/connecting/resources/images/remote-ssh-button.png
