NoBlackBoxes/BlackBoxes/systems/connecting/resources/images/ssh_known_host_error.png

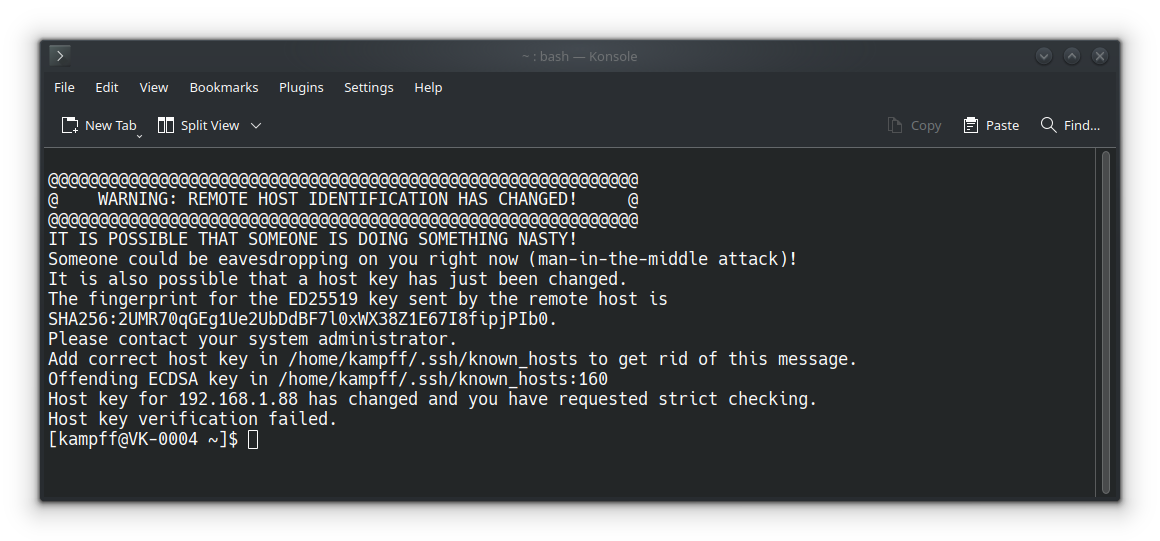
systems/connecting/resources/images/ssh_known_host_error.png
