NoBlackBoxes/BlackBoxes/systems/rpios/resources/images/rpi_imager_launch.png

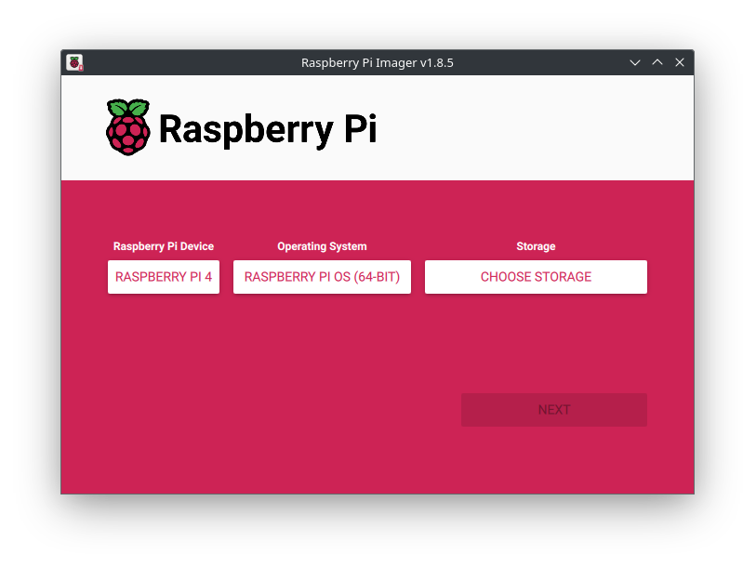
systems/rpios/resources/images/rpi_imager_launch.png
