NoBlackBoxes/BlackBoxes/systems/rpios/resources/images/rpi_imager_question.png

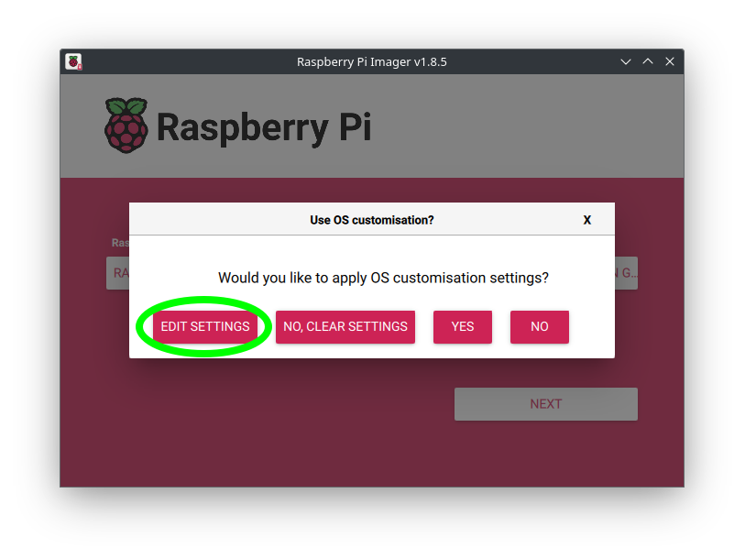
systems/rpios/resources/images/rpi_imager_question.png
