NoBlackBoxes/BlackBoxes/systems/rpios/resources/images/rpi_imager_services.png

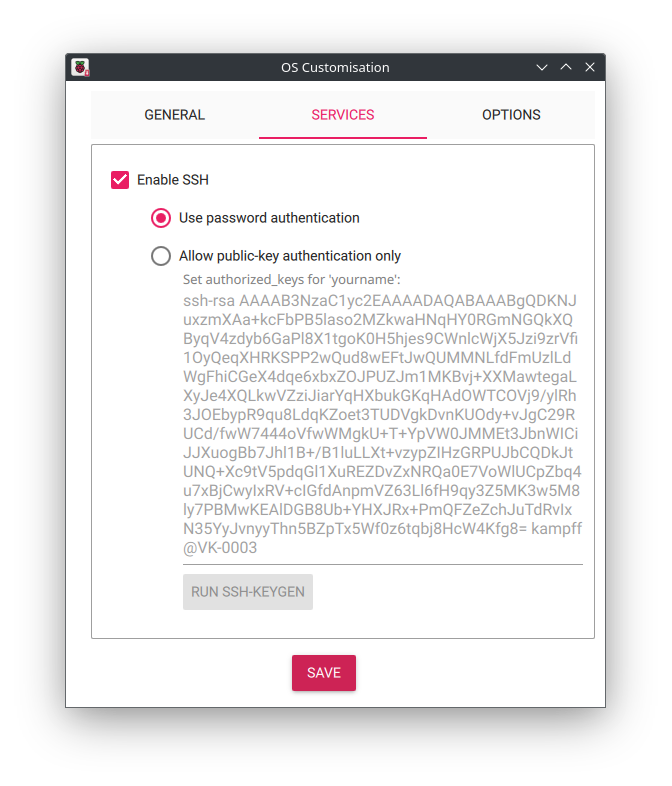
systems/rpios/resources/images/rpi_imager_services.png
