NoBlackBoxes/BlackBoxes/systems/rpios/resources/images/rpi_imager_settings.png

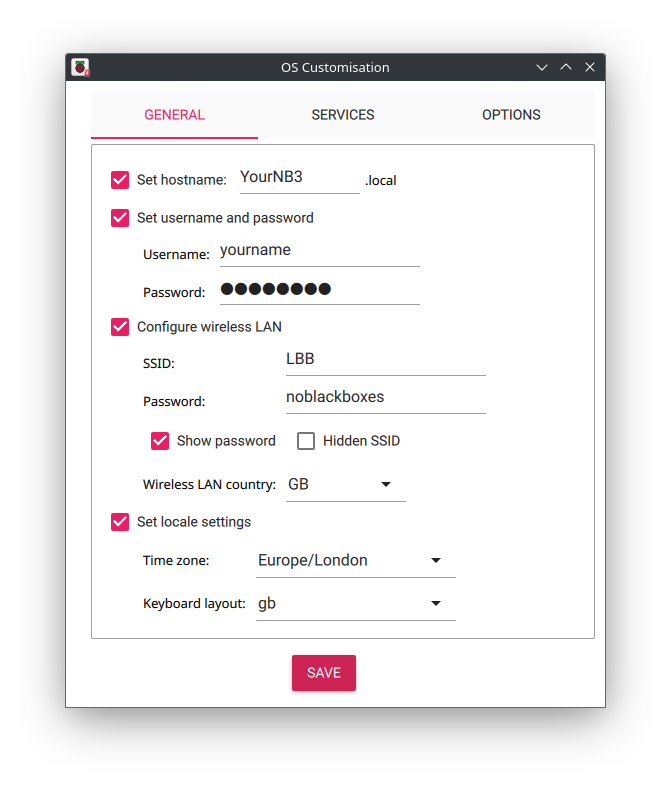
systems/rpios/resources/images/rpi_imager_settings.png
