NoBlackBoxes/BlackBoxes/amplifiers/materials.csv

LM741 | 10 | OpAmp | 1 | _data/datasheets/IRF510.pdf | https://uk.farnell.com/vishay/irf510pbf/mosfet-n-100v-5-6a-to-220ab/dp/1653658 | Active | 5 | 5 | 3
LM386N-4/NOPB | 10 | Audio-Amp | 2 | _data/datasheets/IRF510.pdf | https://uk.farnell.com/vishay/irf510pbf/mosfet-n-100v-5-6a-to-220ab/dp/1653658 | Active | 5 | 5 | 3
