NoBlackBoxes/BlackBoxes/audio/materials.csv

NB3 Ear | 01 | I2S mems microphone breakout board | 2 | NB3_ear | VK | Audio | 20 | 20 | 20
NB3 Mouth | 01 | I2S DAC-AMP breakout board | 1 | NB3_mouth | VK | Audio | 20 | 20 | 20
Speaker | 01 | 3 Watt 4 Ohm with Dupont 2.54 mm socket | 1 | _data/datasheets/CQR0508.jpg | https://www.amazon.co.uk/dp/B09JJ28D6R | Loose | 0 | 30 | 15
Speaker Mount | 01 | Custom laser cut mount for speaker | 1 | - | VK | Mounts | 75 | 20 | 5
M3 standoff (15/PS) | 01 | 15 mm long plug-to-socket M3 standoff | 2 | - | https://uk.farnell.com/ettinger/05-13-151/spacer-m3x15-vzk/dp/1466726 | Hardware | 5 | 5 | 15
M3 nut (square) | 01 | square M3 nut 1.8 mm thick | 2 | - | https://www.accu.co.uk/flat-square-nuts/21326-HFSN-M3-A2 | Hardware | 5 | 5 | 3
M3 bolt (6) | 01 | 6 mm long M3 bolt | 2 | - | https://www.accu.co.uk/pozi-pan-head-screws/500113-SPP-M3-6-ST-BZP | Hardware | 5 | 5 | 6
M2.5 bolt (6) | 01 | 6 mm long M2.5 bolt | 2 |  | https://www.accu.co.uk/pozi-pan-head-screws/9255-SPP-M2-5-6-A2 | Hardware | 5 | 5 | 6
M2.5 nut | 01 | regular M2.5 nut | 2 | - | https://www.accu.co.uk/hexagon-nuts/456430-HPN-M2-5-C8-Z | Hardware | 5 | 5 | 3
