NoBlackBoxes/BlackBoxes/circuits/materials.csv

Caster | 01 | ¾” metal ball caster | 1 | https://www.pololu.com/product/955 | https://www.hobbytronics.co.uk/ball-caster-metal?keyword=caster | Loose | 70 | 50 | 20
Spacer | 01 | NB3 spacer 3 mm spacer for mounting ball caster | 5 | NB3_spacer | VK | Mounts | 25 | 25 | 5
