NoBlackBoxes/BlackBoxes/computers/materials.csv

Microcontroller | 01 | Arduino Nano (rev.3) | 1 | _data/datasheets/arduino_nano_rev3.pdf | https://uk.farnell.com/arduino/a000005/arduino-nano-evaluation-board/dp/1848691 | Loose | 82 | 60 | 25
Piezo Buzzer | 01 | Piezoelectric speaker/transducer | 1 | _data/datasheets/piezo_buzzer.pdf | https://uk.farnell.com/tdk/ps1240p02bt/piezoelectric-buzzer-4khz-70dba/dp/3267212 | Passive | 30 | 30 | 1
Cable (MiniUSB-1m) | 01 | Mini-USB to Type-A cable (1 m) | 1 |  | https://uk.farnell.com/molex/88732-8602/usb-cable-2-0-plug-plug-1m/dp/1221071 | Loose | 100 | 50 | 15
