NoBlackBoxes/BlackBoxes/data/materials.csv

Comparator | 10 | LM339 (DIP-14) | 2 | _data/datasheets/lm2901.pdf | https://uk.farnell.com/texas-instruments/lm2901n/ic-comparator-quad-2901-dip14/dp/3118410 | Active | 7 | 6 | 5
LED (Red) | 01 | 5 mm/2 mA red LED | 2 | _data/datasheets/led_HLMP.pdf | https://uk.farnell.com/broadcom-limited/hlmp-4700/led-5mm-red-2-3mcd-626nm/dp/1003232 | Active | 50 | 5 | 3
LED (Green) | 01 | 3 mm/2 mA green LED | 2 | _data/datasheets/led_HLMP.pdf | https://uk.farnell.com/broadcom-limited/hlmp-1790/led-3mm-green-2-3mcd-569nm/dp/1003209 | Active | 50 | 5 | 3
Resistor (330) | 01 | 330 &Omega;/0.25 W | 6 | _data/datsheets/resistor.pdf | https://uk.farnell.com/multicomp/mf25-2k4/res-2k4-1-250mw-axial-metal-film/dp/9341595 | Passive | 50 | 5 | 3
