NoBlackBoxes/BlackBoxes/intelligence/materials.csv

NPU | 10 | Coral EdgeTPU USB Type-C | 1 | _data/datasheets/Coral-USB-Accelerator-datasheet.pdf | https://coral.ai/products/accelerator/ | Loose | 100 | 140 | 30
M3 screw (16) | 10 | 16 mm long M3 screw with phillips socket | 4 |  |  | Hardware | 5 | 5 | 16
M3 nut (square) | 10 | square M3 nut 1.8 mm thick | 4 |  | https://www.accu.co.uk/flat-square-nuts/21326-HFSN-M3-A2 | Hardware | 5 | 5 | 3
