NoBlackBoxes/BlackBoxes/power/materials.csv

NB3 Power Board | 01 | Regulated DC-DC power supply (5 Volts - 4 Amps) | 1 | NB3_power | VK | Power | 50 | 50 | 15
Power Cable | 01 | Custom 4 pin NB3 power connector cable | 1 |  | VK | Power | 50 | 10 | 5
M2.5 standoff (7/PS) | 01 | 7 mm long plug-to-socket M2.5 standoff | 4 |  | https://uk.farnell.com/wurth-elektronik/971070151/standoff-hex-male-female-7mm-m2/dp/2884371 | Hardware | 5 | 5 | 7
M2.5 bolt (6) | 01 | 6 mm long M2.5 bolt | 4 |  | https://www.accu.co.uk/pozi-pan-head-screws/9255-SPP-M2-5-6-A2 | Hardware | 5 | 5 | 6
M2.5 nut | 01 | regular M2.5 nut | 4 | - | https://www.accu.co.uk/hexagon-nuts/456430-HPN-M2-5-C8-Z | Hardware | 5 | 5 | 3
12V DC Power Supply | 01 | 12 V AC-DC transformer (UK/EU/USA plugs) | 1 |  | https://www.amazon.co.uk/gp/product/B09QG4R1R4 | Loose | 100 | 100 | 80
