NoBlackBoxes/BlackBoxes/robotics/materials.csv

Cable (Mini-USB/20cm) | 01 | Short mini-USB to Type-A cable (20 cm) | 1 | https://www.amazon.co.uk/LINDY-0-2-Type-Mini-B-Cable/dp/B01IZ4VFCO | Loose | 100 | 25 | 10
Battery | 01 | NiMH 9.6V 8-cell 2000 mAh battery | 1 | https://www.amazon.co.uk/BAKTH-Capacity-Rechargeable-Discharge-Customized/dp/B08VRC8KL7 | Loose | 100 | 60 | 15
Battery Charger | 01 | NiMH battery charger (UK plug) | 1 | https://www.amazon.co.uk/dp/B089VRXKWY?psc=1&smid=AOVA4BIXU2O7J&ref_=chk_typ_imgToDp | Loose | 90 | 90 | 70
Velcro Patch | 01 | Velcro adhesive | 1 |  | Loose | 50 | 75 | 4
