NoBlackBoxes/BlackBoxes/sensors/materials.csv

Thermistor | 10 | Temperature sensitive resistor | 2 | _data/datasheets/thermistor.pdf | https://uk.farnell.com/epcos/b57891m0103k000/thermistor-ntc-radial-leaded/dp/2285471 | Passive | 50 | 10 | 3
Photoresistor (LDR) | 01 | Light-dependent resistor (GL5516 and GL5528) | 8 |  | https://www.amazon.co.uk/Resistor-Dependent-Photoresistor-Sensitive-Sensors/dp/B08SC1M7V7 | Passive | 50 | 10 | 3
Piezo | 10 | Piezo element | 1 | _data/datasheets/piezo.pdf | https://uk.farnell.com/multicomp/mcabt-455-rc/audio-element-piezo-2-8khz-35mm/dp/2433035 | Passive | 50 | 50 | 3
Breadboards (170) | 01 | 170-tie solderless breadboard | 4 | _data/datasheets/breadboard_170.pdf | https://www.amazon.co.uk/ELEGOO-tie-points-Breadboard-Breadboards-Electronic/dp/B01N0YWIR7 | Loose | 35 | 50 | 10
