NoBlackBoxes/BlackBoxes/systems/materials.csv

Computer (RPi4) | 01 | Raspberry Pi 4b with 4 GB RAM | 1 | _data/datasheets/rpi4b_4gb.pdf | https://uk.farnell.com/raspberry-pi/rpi4-modbp-4gb/raspberry-pi-4-model-b-4gb/dp/3051887 | Loose | 95 | 70 | 26
Heatsinks | 01 | Heatsinks for RPi 4b chips | 1 | _data/datasheets/rpi4b_heatsinks.jpg | https://www.amazon.co.uk/gp/product/B07VRNT3HX | Loose | 40 | 20 | 10
SD Card | 01 | 16 GB micro SD card | 1 | _data/datasheets/SanDisk-SDSQUAR-016G-GN6MA-datasheet.pdf | https://uk.farnell.com/sandisk/sdsquar-016g-gn6ma/memory-card-microsdhc-uhs-i-16gb/dp/2931924 | Loose | 100 | 50 | 3
USB SD Card IO | 01 | SD card reader/writer | 1 |  | https://www.amazon.co.uk/Beikell-High-speed-Adapter-Supports-MMC-Compatible-Windows/dp/B07L9VT8YY | Loose | 70 | 40 | 15
M2.5 bolt (6) | 01 | 6 mm long M2.5 bolt | 4 |  | https://www.accu.co.uk/pozi-pan-head-screws/9255-SPP-M2-5-6-A2 | Hardware | 5 | 5 | 6
M2.5 standoff (20/SS) | 01 | 20 mm long socket-to-socket M2.5 standoff | 4 |  | https://uk.farnell.com/wurth-elektronik/970200154/standoff-hex-female-female-20mm/dp/2987903 | Hardware | 5 | 5 | 20
M2.5 standoff (20/PS) | 01 | 20 mm long plug-to-socket M2.5 standoff | 4 |  | https://uk.farnell.com/wurth-elektronik/971200151/standoff-hex-male-female-20mm/dp/2884418 | Hardware | 5 | 5 | 20
