NoBlackBoxes/BlackBoxes/transistors/materials.csv

MOSFET | 01 | Power MOSFET/N-channel (IRF510) | 2 | _data/datasheets/IRF510.pdf | https://uk.farnell.com/vishay/irf510pbf/mosfet-n-100v-5-6a-to-220ab/dp/1653658 | Active | 40 | 15 | 4
Diode | 01 | IN4001 | 2 | _data/datasheets/IN4001.pdf | https://uk.farnell.com/on-semiconductor/1n4001g/diode-standard-1a-do-41/dp/1458986 | Active | 40 | 5 | 3
Photodiode (Visible) | 10 | Visible (broadband) photodiode | 2 |  | https://uk.farnell.com/vishay/tefd4300/photodiode-950nm-3mm/dp/2251271 | Active | 40 | 5 | 3
Photodiode (IR) | 10 | IR sensitive photodiode | 2 |  | https://uk.farnell.com/osram-opto-semiconductors/sfh203-fa/photodiode-ir-filtered/dp/1212743 | Active | 40 | 5 | 3
LED (Blue) | 10 | Low power blue light emitting diode | 2 |  | https://uk.farnell.com/broadcom-limited/hlmp-ka45-e0000/led-3mm-blue-85mcd-470nm/dp/1863182 | Active | 40 | 5 | 3
LED (IR) | 10 | Low power IR light emitting diode | 2 |  | https://uk.farnell.com/vishay/tsal6100/infrared-emitter-940nm-t-1-3-4/dp/1328299 | Active | 40 | 5 | 3
