NoBlackBoxes/BlackBoxes/electrons/NB3_body/NB3_body.ods

Quantity | Designator | Description | Manufactuer | Manufacturer number | Supplier | Supplier number | Unit Price
2 | J12,J13 | Male Header 2x03 Surface Mount 2.54mm SMD P=2.54mm | Ckmtw | C124390 | LCSC | C124390 | 0.05
8 | J1,J2,J4,J15,J3,J5,J14,J6 | Female Header 2x05 Surface Mount 2.54mm SMD P=2.54mm | BOOMELE | C261072 | LCSC | C261072 | 0.1428
3 | J7,J9,J8 | Female Header 2x07 Surface Mount 2.54mm SMD P=2.54mm | BOOMELE | C84005 | LCSC | C84005 | 0.2098
1 | J10 | PH Header Male Pin 0.079"(2.00mm) 4 SMD P=2mm Wire To Board / Wire To Wire | JST | S4B-PH-SM4-TB(LF)(SN) | LCSC | C265102 | 0.2873
