NoBlackBoxes/BlackBoxes/audio/NB3_ear/NB3_ear.step

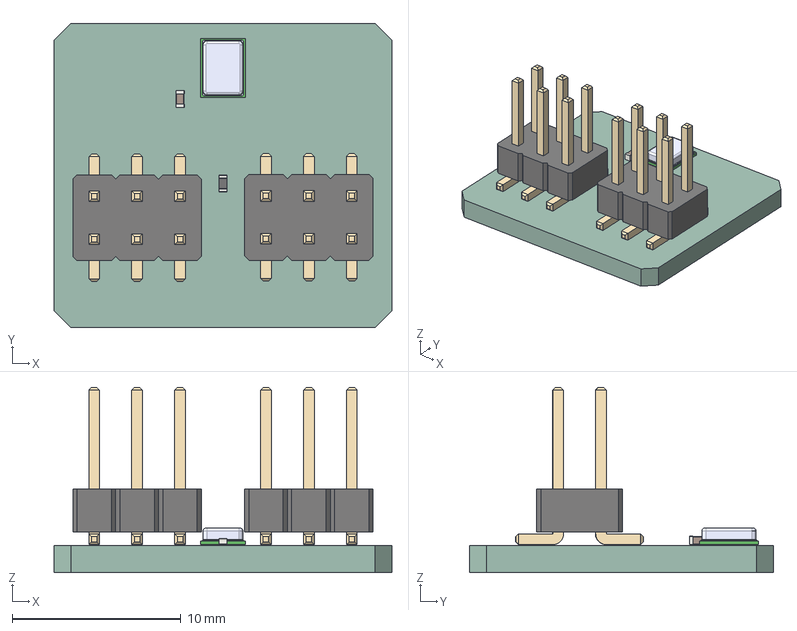
[picture p107: CAD file, 2024-06-29]
audio/NB3_ear/NB3_ear.step
20.0 x 18.0 x 11.0 mm
ICS-43434
C_0402_1005Metric
R_0402_1005Metric
PinHeader_2x03_P254mm_Vertical_SMD x 2
NB3_ear_PCB
