NoBlackBoxes/BlackBoxes/audio/NB3_mouth/NB3_mouth.step

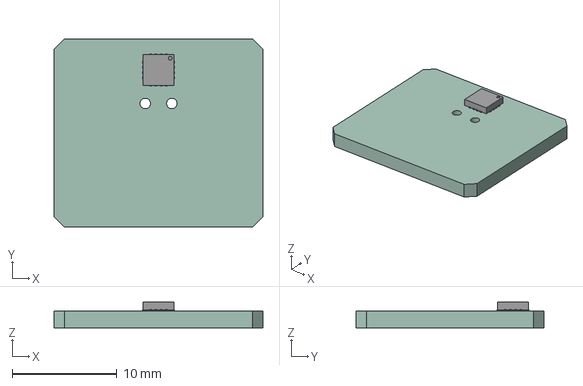
[picture p108: CAD file, 2024-02-26]
audio/NB3_mouth/NB3_mouth.step
20.0 x 18.0 x 2.45 mm
ASSEMBLY
_autosave-NB3_mouth PCB
