NoBlackBoxes/BlackBoxes/audio/NB3_speaker_mount/NB3_speaker_mount.dxf

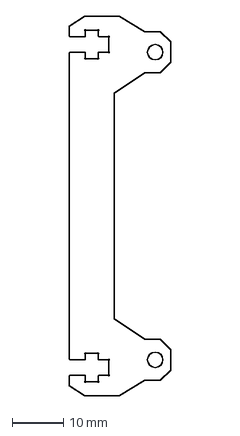
[picture p109: CAD file, 2023-09-02]
audio/NB3_speaker_mount/NB3_speaker_mount.dxf
19.7 x 74.0 mm
