NoBlackBoxes/BlackBoxes/boxes/audio/NB3_mounts/NB3_mouth_mount.dxf

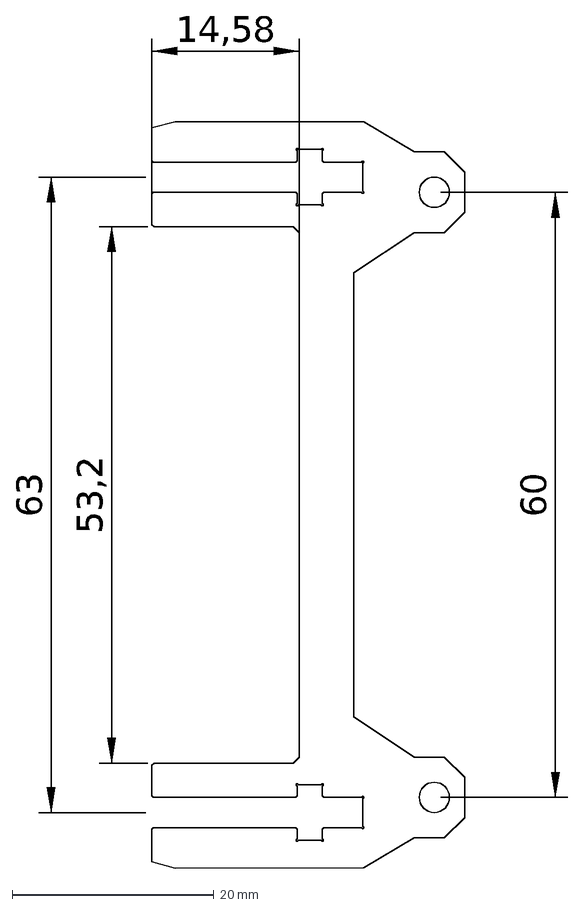
[picture p110: CAD file, 2023-09-02]
boxes/audio/NB3_mounts/NB3_mouth_mount.dxf
63
53,2
14,58
60
