NoBlackBoxes/BlackBoxes/circuits/NB3_servo_mount/NB3_servo_mount.dxf

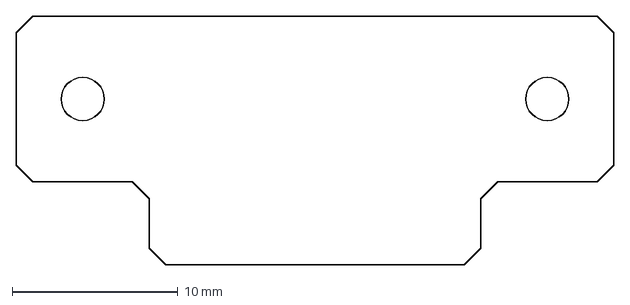
[picture p112: CAD file, 2023-06-06]
circuits/NB3_servo_mount/NB3_servo_mount.dxf
36.0 x 15.0 mm
