NoBlackBoxes/BlackBoxes/circuits/NB3_spacer/NB3_spacer.dxf

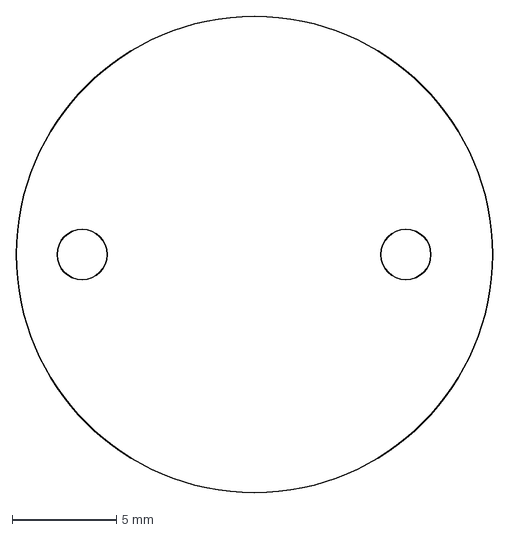
[picture p113: CAD file, 2021-07-05]
circuits/NB3_spacer/NB3_spacer.dxf
22.8 x 22.8 mm
