NoBlackBoxes/BlackBoxes/electrons/NB3_body/NB3_body.step

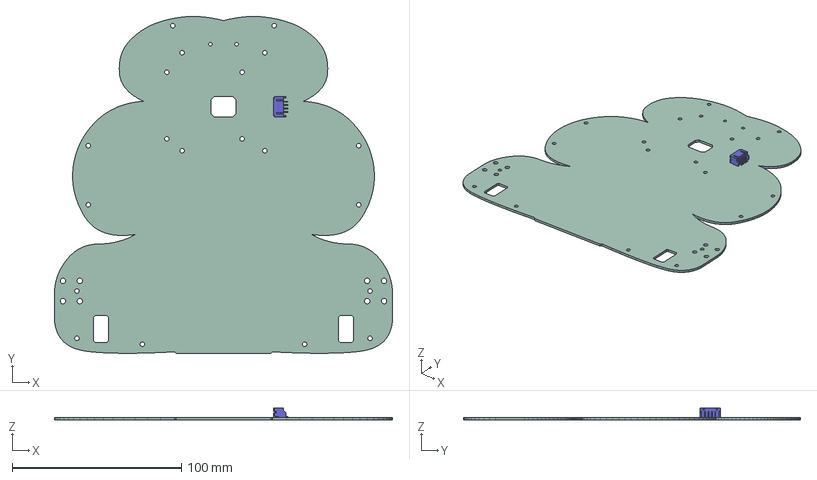
[picture p114: CAD file, 2024-02-26]
electrons/NB3_body/NB3_body.step
200.0 x 199.5 x 7.15 mm
S4B-PH-SM4
NB3_body PCB
