NoBlackBoxes/BlackBoxes/power/NB3_power/NB3_power.step

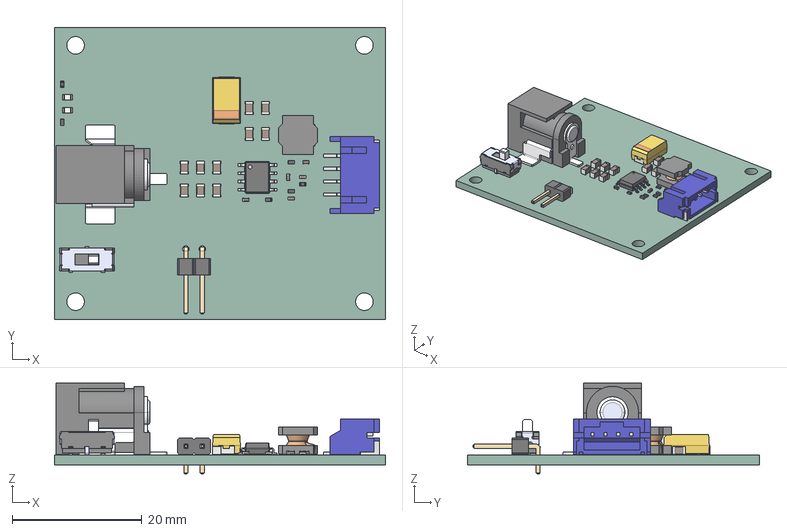
[picture p115: CAD file, 2024-06-29]
power/NB3_power/NB3_power.step
51.0 x 45.0 x 14.0 mm
C_0805_2012Metric x 10
R_0402_1005Metric x 6
LED_0603_1608Metric x 2
CP_EIA_7343_31_Kemet_D
CUI_DEVICES_PJ-036AH-SMT-TR
JS102011JCQN
C_0402_1005Metric x 5
PinHeader_1x02_P254mm_Horizontal
L_Bourns_SRN6045TA
S4B-PH-SM4
SOIC_8_1EP_39x49mm_P127mm
NB3_power_PCB
