NoBlackBoxes/BlackBoxes/vision/NB3_camera_mount/NB3_camera_mount.dxf

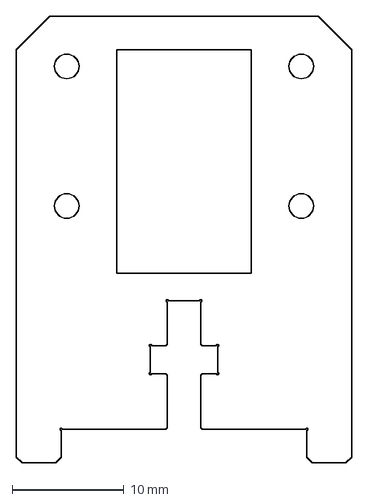
[picture p116: CAD file, 2023-09-02]
vision/NB3_camera_mount/NB3_camera_mount.dxf
30.0 x 40.0 mm
