NoBlackBoxes/BlackBoxes/vision/NB3_cortex_mount/NB3_cortex_mount.dxf

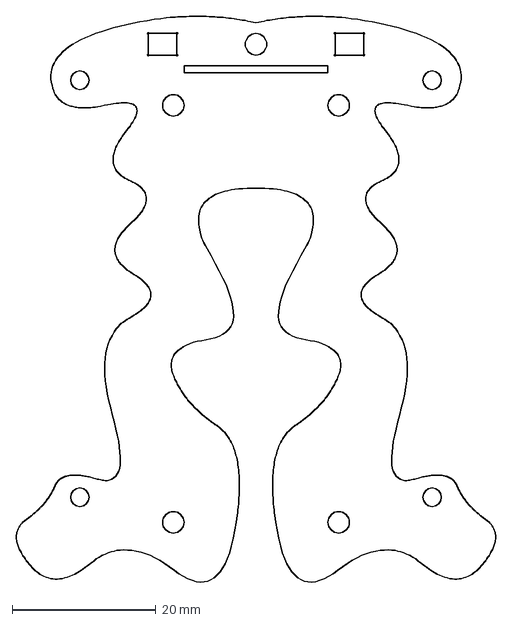
[picture p117: CAD file, 2023-09-08]
vision/NB3_cortex_mount/NB3_cortex_mount.dxf
66.7 x 78.8 mm
