NoBlackBoxes/BlackBoxes/fpgas/hdl/verilog/cpu/RISC-V Instructions.png

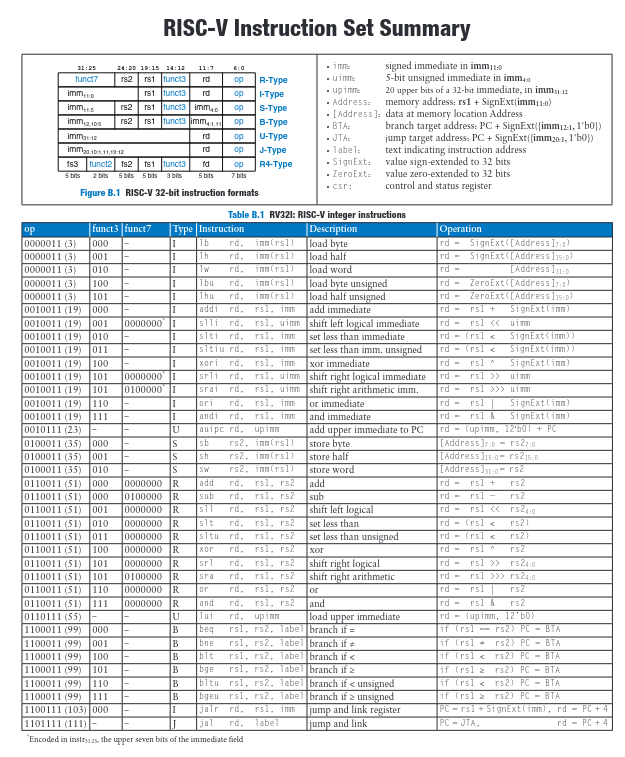
fpgas/hdl/verilog/cpu/RISC-V Instructions.png
