NoBlackBoxes/BlackBoxes/fpgas/hdl/verilog/uart/NB3_hindbrain_uart.pcf

# Clock (12 MHz)
set_io -nowarn clock 35

# GPIO pins, left side
set_io -nowarn gpio[0] 12
set_io -nowarn gpio[1] 11
set_io -nowarn gpio[2] 10
set_io -nowarn gpio[3] 9
set_io -nowarn gpio[4] 6
set_io -nowarn gpio[5] 4
#set_io -nowarn gpio[6] 3
#set_io -nowarn gpio[7] 2

# GPIO pins, right side
set_io -nowarn leds[0] 25
set_io -nowarn leds[1] 26
set_io -nowarn leds[2] 27
set_io -nowarn leds[3] 28
set_io -nowarn leds[4] 31
set_io -nowarn leds[5] 32
set_io -nowarn leds[6] 34
set_io -nowarn leds[7] 36

# UART port
set_io -nowarn rx_pin 3
set_io -nowarn tx_pin 2
