NoBlackBoxes/BlackBoxes/(commit log)

2020-08-20 Serial echo example in AVR assemblu
2020-08-29 Prep for auto-BOM
2020-08-30 Update _template box, add White box
    [materials.csv]
2020-08-30 Added "materials.csv" to each box, for auto-BOM
    [materials.csv]
2020-08-31 Added materials/datasheets
    [materials.csv]
2020-08-31 Remove search refs from links
    [materials.csv]
2020-09-01 BOM tweaks
    [materials.csv]
2020-09-04 Added "hearing" box, amongst other tweaks
    [materials.csv]
2020-09-05 "kit" becomes "course"
    [materials.csv]
2020-09-05 Updates to BOM
    [materials.csv]
2020-09-07 Add mouning hardware to BOM
    [materials.csv]
2020-09-07 More additions to BOM
    [materials.csv]
2020-09-09 Split large boxes (e.g. electrons)
    [materials.csv]
2020-09-09 Add content for data
    [materials.csv]
2020-09-09 Add decisions links
    [materials.csv]
2020-09-10 Add 2019 content, unorganized
    [picam_holder.stl]
2020-09-10 Add words and images to memory box
    [materials.csv]
2020-09-10 Update decisions with comparator BOM
    [materials.csv]
2020-09-10 BOM tweaks/datasheets
    [materials.csv]
2020-09-10 Regen BOM
2020-09-11 Tweak BOM
    [materials.csv]
2020-09-14 Fix datasheet links (issue)
    [materials.csv]
2020-09-14 Add NB3 stage diagrams to box READMEs and _images
2020-09-16 Add motor driver circuit mage
2020-09-18 Update BOM (digital boxes)
    [materials.csv]
2020-09-23 Add "arduino" programming examples
2020-09-25 Added CLI instructions for Arduino programming
2020-09-28 Added some example code: serial, keyboard, arduino
2020-09-28 Added instructions for installing Arduino-CLI
2020-09-29 Added camera setup instructions
2020-11-12 Draft for NB3 power board PCB
    [NB3_power.kicad_pcb, NB3_power.kicad_sch, materials.csv]
2020-11-13 Work on NB3_power PCB
    [NB3_power.kicad_pcb, NB3_power.kicad_sch]
2020-11-13 More work on NB3_power PCB
    [NB3_power.kicad_pcb, NB3_power.kicad_sch]
2020-11-16 Work on NB3_power PCB (layout)
    [NB3_power.kicad_pcb, NB3_power.kicad_sch]
2020-11-17 More work on NB£_power PCB
    [NB3_power.kicad_pcb, NB3_power.kicad_sch]
2020-11-17 Still NB3_power PCB
    [NB3_power.kicad_pcb, NB3_power.kicad_sch]
2020-11-18 NB3_power PCB layout finished
    [NB3_power.csv, NB3_power.kicad_pcb, NB3_power.kicad_sch, NB3_power.ods]
2020-11-18 NB3_power PCB fab submisson
    [NB3_power.csv, NB3_power.kicad_pcb, NB3_power.kicad_sch, NB3_power.ods, NB3_power.step]
2021-06-25 Added new NB3 board drafts (body and power)
    [NB3_body.kicad_pcb, NB3_body.kicad_sch, NB3_body.ods, NB3_power.kicad_pcb, NB3_power.kicad_sch]
2021-06-28 Final draft (rev 0.0.1) of NB3_power PCB
    [NB3_power.csv, NB3_power.kicad_pcb, NB3_power.kicad_sch, NB3_power.ods, NB3_power.step]
2021-06-28 Work on NB3_body PCB...
    [NB3_body.dxf, NB3_body.kicad_pcb, NB3_body.kicad_sch]
2021-06-29 Optimized NB3_power BOM for cost
    [NB3_power-B_Cu.gbl, NB3_power-B_Mask.gbs, NB3_power-B_Paste.gbp, NB3_power-B_Silkscreen.gbo, NB3_power-Edge_Cuts.gm1, NB3_power-F_Cu.gtl, NB3_power-F_Mask.gts, NB3_power-F_Paste.gtp]
2021-06-30 Work on NB£_body PCB layout
    [NB3_body.kicad_pcb, NB3_body.kicad_sch]
2021-06-30 Work on NB3_body routing
    [NB3_body.kicad_pcb, NB3_body.kicad_sch]
2021-07-02 NB3 pcb design tweaks
    [NB3_body.kicad_pcb, NB3_body.kicad_sch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]
2021-07-05 Added laser cut (DXF) designs for NB3 mounts
    [NB3_camera_mount.dxf, NB3_npu_mount.dxf, NB3_spacer.dxf]
2021-07-06 Work on NB£_body PCB
    [NB3_body.kicad_pcb, NB3_body.kicad_sch]
2021-07-06 Finished NB3_body PCB (pre-Fab)
    [NB3_body-B_Cu.gbl, NB3_body-B_Mask.gbs, NB3_body-B_Paste.gbp, NB3_body-B_Silkscreen.gbo, NB3_body-Edge_Cuts.gm1, NB3_body-F_Cu.gtl, NB3_body-F_Mask.gts, NB3_body-F_Paste.gtp]
2021-07-06 Submitted NB3_body PCB
    [NB3_body-B_Cu.dxf, NB3_body-B_Mask.dxf, NB3_body-B_Paste.dxf, NB3_body-B_Silkscreen.dxf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]
2021-07-06 Draft design for NB3 Ear PCB
    [NB3_ear.kicad_pcb, NB3_ear.kicad_sch]
2021-07-07 Added NB3 Ear PCB design
    [NB3_body.kicad_pcb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]
2021-07-12 FPGA hindbrain PCB draft
    [NB3_ear-B_Cu.gbl, NB3_ear-B_Mask.gbs, NB3_ear-B_Paste.gbp, NB3_ear-B_Silkscreen.gbo, NB3_ear-Edge_Cuts.gm1, NB3_ear-F_Cu.gtl, NB3_ear-F_Mask.gts, NB3_ear-F_Paste.gtp]
2021-07-15 Tweaks to NB3_hindbrain
    [NB3_hindbrain.kicad_pcb, NB3_hindbrain.kicad_sch]
2021-07-17 Work on NB3_hindbrain
    [NB3_hindbrain.kicad_pcb, NB3_hindbrain.kicad_sch]
2021-07-18 Update NB3_hindbrain (3D models)
    [NB3_hindbrain.kicad_pcb, NB3_hindbrain.kicad_sch]
2021-07-18 NB£_hindbrain layout update
    [NB3_hindbrain.kicad_pcb, NB3_hindbrain.kicad_sch]
2021-07-20 NB£_hindbrain PCB placement done
    [NB3_hindbrain.kicad_pcb, NB3_hindbrain.kicad_sch]
2021-07-21 NB£_hindbrain routing...work in progress
    [NB3_hindbrain.kicad_pcb]
2021-08-06 Draft PWM module
2021-08-23 Prep for 2021
    [materials.csv]
2021-08-24 Updating BOM...added Tasks file
    [materials.csv]
2021-08-24 Interim 2021 BOM update and refactor
    [materials.csv]
2021-08-25 Update H-bridge
    [materials.csv]
2021-09-01 Update BOM and datasheets
    [materials.csv]
2021-09-01 Draft Linux driver for NB3_ear
2021-09-06 Added first baremetal arm/rpi examples
2021-09-08 Added new NB3 mount laser cuts
    [NB3_camera_mount.dxf, NB3_cortex_mount.dxf]
2021-09-13 Update BOM
2021-09-13 Update topics (magnets, electrons) and BOM
    [materials.csv]
2021-09-14 UPdate goals, BOM, and topics
    [materials.csv]
2021-09-18 Added Atoms box
    [materials.csv]
2021-09-18 Added goals/topics for data/logic/memory/power
2021-09-20 Update Comparator datasheet/BOM
    [materials.csv]
2021-09-20 add some example bins and zadig for testing windows, test WSL builds for PWM and counter
2021-09-22 Changed "?" box name for lame windows users
    [materials.csv]
2021-09-25 Remove question box
    [materials.csv]
2021-09-29 Changed FPGAs box to ICs
    [NB3_hindbrain.kicad_pcb, NB3_hindbrain.kicad_sch, materials.csv]
2021-10-12 Update NB3 driver instructions
2021-10-12 Update NB3 Ear driver
2022-08-01 Tweaked BOM (vision)
    [materials.csv]
2022-08-01 Update NB3_body (motor mount holes)
    [NB3_body.kicad_pcb, NB3_body.kicad_sch]
2022-08-02 Updated NB3_power: compatible w/replacement PS
    [NB3_power.kicad_pcb, NB3_power.kicad_sch]
2022-08-02 Update NB3_body: new power dimensions
    [NB3_body.kicad_pcb, NB3_power.kicad_pcb]
2022-08-02 Added new NB3_body fab details
    [NB3_body-B_Cu.gbl, NB3_body-B_Mask.gbs, NB3_body-B_Paste.gbp, NB3_body-B_Silkscreen.gbo, NB3_body-Edge_Cuts.gm1, NB3_body-F_Cu.gtl, NB3_body-F_Mask.gts, NB3_body-F_Paste.gtp]
2022-08-08 Modified Cortex Mount
    [NB3_cortex_mount.dxf]
2022-09-27 Added mystery music CSV files Hearing box
    [mystery_music_A.csv, mystery_music_B.csv, mystery_music_C.csv]
2022-10-06 Updated Fab details for NB3 power (rev 3)
    [NB3_body-B_Cu.dxf, NB3_body-B_Mask.dxf, NB3_body-B_Paste.dxf, NB3_body-B_Silkscreen.dxf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]
2022-10-11 Update NB3 Body (for servo drive)
    [NB3_body-B_Cu.dxf, NB3_body-B_Mask.dxf, NB3_body-B_Paste.dxf, NB3_body-B_Silkscreen.dxf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]
2022-10-21 Tests of ULX3S Board
2022-10-27 Added draft NB3_bug design
    [NB3_bug.kicad_pcb, NB3_bug.kicad_sch]
2022-11-01 Added NB3_camera draft
    [NB3_camera.kicad_pcb, NB3_camera.kicad_sch]
2022-11-10 Added IOT box
    [materials.csv]
2023-01-22 Added goas.md inserter
    [materials.csv]
2023-01-22 Added gradient descent examples to learning box
    [complex.csv, simple.csv]
2023-01-22 Added data generators
    [complex.csv, simple.csv]
2023-03-05 Added website box
    [materials.csv]
2023-06-06 Added servo mount DXF
    [NB3_servo_mount.dxf]
2023-07-12 Updated driver install and wiring image for Ears
2023-07-17 Update NB£_caera_mount for v3 Rpi cam
    [NB3_camera_mount.dxf]
2023-07-23 Update KiCAD for NB3 hindbrain
    [NB3_hindbrain.kicad_sch]
2023-07-27 Reorder i2s driver install steps
2023-07-29 Change hearing to audio (added NB3_mouth)
    [NB3_ear-B_Cu.gbl, NB3_ear-B_Mask.gbs, NB3_ear-B_Paste.gbp, NB3_ear-B_Silkscreen.gbo, NB3_ear-Edge_Cuts.gm1, NB3_ear-F_Cu.gtl, NB3_ear-F_Mask.gts, NB3_ear-F_Paste.gtp]
2023-07-31 Update NB3 PCBs and parts
    [NB3_body.kicad_pcb, NB3_body.kicad_sch, NB3_hindbrain.kicad_sch, NB3_mouth.kicad_pcb, NB3_mouth.kicad_sch]
2023-08-03 Update NB3_Ear (R&E Only)
    [NB3_ear.kicad_pcb, NB3_ear.kicad_sch]
2023-08-03 Tweak NB3_mouth
    [NB3_mouth.kicad_pcb, NB3_mouth.kicad_sch]
2023-08-03 Update NB3_power (R&E Only)
    [NB3_power.kicad_pcb, NB3_power.kicad_sch]
2023-08-03 Add JST connector to NB3_mouth
    [NB3_mouth.kicad_pcb, NB3_mouth.kicad_sch]
2023-08-05 Revert to box "FPGAs" vs "ICs"
    [NB3_hindbrain.kicad_pcb, NB3_hindbrain.kicad_sch, materials.csv]
2023-08-10 Tweaks and tests for NB3_Audio
    [mystery_music_A.csv, mystery_music_B.csv, mystery_music_C.csv]
2023-08-12 Upload NB3_ear "fab" v2
    [NB3_ear-B_Cu.gbl, NB3_ear-B_Mask.gbs, NB3_ear-B_Paste.gbp, NB3_ear-B_Silkscreen.gbo, NB3_ear-Edge_Cuts.gm1, NB3_ear-F_Cu.gtl, NB3_ear-F_Mask.gts, NB3_ear-F_Paste.gtp]
2023-08-12 Update NB£_power (v4)
    [NB3_power-B_Cu.gbl, NB3_power-B_Mask.gbs, NB3_power-B_Paste.gbp, NB3_power-B_Silkscreen.gbo, NB3_power-Edge_Cuts.gm1, NB3_power-F_Cu.gtl, NB3_power-F_Mask.gts, NB3_power-F_Paste.gtp]
2023-08-12 Ref 1 of NB3 Mouth
    [NB3_body-B_Cu.gbl, NB3_body-B_Mask.gbs, NB3_body-B_Paste.gbp, NB3_body-B_Silkscreen.gbo, NB3_body-Edge_Cuts.gm1, NB3_body-F_Cu.gtl, NB3_body-F_Mask.gts, NB3_body-F_Paste.gtp]
2023-08-12 Fab details for NB3 mouth (v1)
    [NB3_mouth-B_Cu.gbl, NB3_mouth-B_Mask.gbs, NB3_mouth-B_Paste.gbp, NB3_mouth-B_Silkscreen.gbo, NB3_mouth-Edge_Cuts.gm1, NB3_mouth-F_Cu.gtl, NB3_mouth-F_Mask.gts, NB3_mouth-F_Paste.gtp]
2023-08-12 Work on NB3_bidy (v4) - TT DC motors
    [NB3_body.kicad_pcb, NB3_body.kicad_sch]
2023-08-13 Updated NB3 body (v4) - ear/mouth and TT motors
    [NB3_body-B_Cu.dxf, NB3_body-B_Mask.dxf, NB3_body-B_Paste.dxf, NB3_body-B_Silkscreen.dxf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]
2023-08-16 Added draft Assembler for NBBPU
2023-08-17 Added test framework (verficiation) for NBBPU
2023-08-19 Switched to crude multi-cycle to accomondate BRAM
2023-08-22 Work on NBBPU I/O (PWM ok, ADC not)
2023-08-23 ADC is working...
2023-08-23 Clean up ADC
2023-08-23 Tested UART hijack for RPi connection
2023-08-23 Brainsotmring NB3_hindbrain
    [NB3_hindbrain.kicad_pcb, NB3_hindbrain.kicad_sch]
2023-08-24 Work on NB£_hindbrain schematic
    [NB3_hindbrain.kicad_pcb, NB3_hindbrain.kicad_sch]
2023-08-25 NB3_hindbrain updated 1.2V LDO and parts list
    [NB3_hindbrain.kicad_sch]
2023-08-25 Finished NB3 Hindbrain schematic
    [NB3_hindbrain.kicad_pcb, NB3_hindbrain.kicad_sch]
2023-08-26 Work on NB3 Hindbrain routing...
    [NB3_hindbrain.kicad_pcb, NB3_hindbrain.kicad_sch]
2023-08-27 More work on NB£ Hindbrain wiring...FTDI done
    [NB3_hindbrain.kicad_pcb, NB3_hindbrain.kicad_sch]
2023-08-27 More wiring...
    [NB3_hindbrain.kicad_pcb]
2023-08-28 Hmm....wiring chaos (NB3 Hindbrain)
    [NB3_hindbrain.kicad_pcb, NB3_hindbrain.kicad_sch]
2023-08-29 Wiring progress...
    [NB3_hindbrain.kicad_pcb, NB3_hindbrain.kicad_sch]
2023-08-29 Finished DRAFT wiring (NB3 Hindbrain)
    [NB3_hindbrain.kicad_pcb, NB3_hindbrain.kicad_sch]
2023-08-29 NB3 Hindbrain prototype (sent to fab)
    [NB3_hindbrain-B_Cu.gbl, NB3_hindbrain-B_Mask.gbs, NB3_hindbrain-B_Paste.gbp, NB3_hindbrain-B_Silkscreen.gbo, NB3_hindbrain-Edge_Cuts.gm1, NB3_hindbrain-F_Cu.gtl, NB3_hindbrain-F_Mask.gts, NB3_hindbrain-F_Paste.gtp]
2023-08-30 Fix DRC fill in NB3_hindbrain
    [NB3_hindbrain-B_Cu.gbl, NB3_hindbrain-B_Mask.gbs, NB3_hindbrain-B_Paste.gbp, NB3_hindbrain-B_Silkscreen.gbo, NB3_hindbrain-Edge_Cuts.gm1, NB3_hindbrain-F_Cu.gtl, NB3_hindbrain-F_Mask.gts, NB3_hindbrain-F_Paste.gtp]
2023-09-02 Modify mounts (camera, cortex, mouth)
    [NB3_camera_mount.dxf, NB3_cortex_mount.dxf, NB3_mouth_mount.dxf]
2023-09-02 Updated mounts
    [NB3_camera_mount.dxf, NB3_cortex_mount.dxf, NB3_speaker_mount.dxf, materials.csv]
2023-09-02 Update NB3_Body (fix right ear orientation)
    [NB3_body.kicad_pcb, NB3_body.kicad_sch]
2023-09-02 Update LBB BOM
    [materials.csv]
2023-09-03 Added periodic table card
    [materials.csv]
2023-09-04 Refactor all "Boxes" to repo root
    [NB3_body-B_Cu.gbl, NB3_body-B_Mask.gbs, NB3_body-B_Paste.gbp, NB3_body-B_Silkscreen.gbo, NB3_body-Edge_Cuts.gm1, NB3_body-F_Cu.gtl, NB3_body-F_Mask.gts, NB3_body-F_Paste.gtp]
2023-09-06 Update NBB_sound library (using callbacks)
    [materials.csv]
2023-09-06 Updating materials
    [materials.csv]
2023-09-06 Update materials and datasheets
    [materials.csv]
2023-09-06 NB3 ear driver becomes NB3 audio driver
2023-09-07 Update standoffs in BOM
    [materials.csv]
2023-09-08 Update hardware, 2x20 mm standoffs, adjust cortex
    [NB3_cortex_mount.dxf, NB3_npu_mount.dxf, materials.csv]
2023-09-09 Update pin1 marker RGB1
    [NB3_hindbrain.kicad_pcb]
2023-09-09 Added Linux box
    [materials.csv]
2023-09-11 Correct D1 inNB3 Hindbrain BOM
    [NB3_hindbrain.xlsx]
2023-09-11 Update power BOM
    [materials.csv]
2023-09-18 Added "controller" Arduino example for H-Bridge
2023-09-19 Cleanup some old, out dated, instructions
    [picam_holder.stl]
2023-09-20 Add DXF to NB3 body
    [NB3_body-Edge_Cuts.dxf, NB3_body.kicad_pcb]
2023-09-20 Updated DXF with drill holes (oversized)
    [NB3_body-Edge_Cuts.dxf, NB3_body.dxf]
2023-09-22 Update chatNB3 default devices
2023-09-23 Update piezo part
    [materials.csv]
2023-10-10 Update audio driver instructions
2023-11-21 Partial update to NB3_mouth (SD_MODE for disable)
    [NB3_body.kicad_pcb, NB3_body.kicad_sch, NB3_mouth.kicad_pcb, NB3_mouth.kicad_sch]
2023-11-23 Update NB3 mouth and body (Enable pin + 2.54 c)
    [NB3_body.kicad_pcb, NB3_body.kicad_sch, NB3_mouth.kicad_pcb, NB3_mouth.kicad_sch, NB3_mouth.ods, materials.csv]
2023-11-24 Draft work on new Ear and Mouth i2s driver
2023-11-27 Added updated NB£ audio driver (now debugging clk)
2023-11-29 Update PCBs (body, ear, mouth, and power)
    [NB3_body.kicad_pcb, NB3_body.kicad_sch, NB3_ear.kicad_pcb, NB3_ear.kicad_sch, NB3_mouth.kicad_pcb, NB3_power.kicad_pcb, NB3_power.kicad_sch]
2023-12-05 Work on GPIO and UART
2023-12-05 Should switch to full UART (0)
2023-12-06 Mess direct memory vs pointer array reg access
    [config.txt]
2023-12-06 Cleanup NBBOS (put32,get32)....not working
    [config.txt]
2023-12-07 Work on mailbox and framebuffer...
2023-12-08 WTF long long int unsigned ugh...switch to stdint
2023-12-12 Attempting to turn on MMU (still)
    [config.txt]
2023-12-13 It works! 340 Hz HD fbuffer clears (w/MMU+cache)
2023-12-13 remove old attempts
    [config.txt]
2024-01-10 Refactor box names
    [NB3_bug.kicad_pcb, NB3_bug.kicad_sch, NB3_servo_mount.dxf, NB3_spacer.dxf, materials.csv]
2024-01-15 Update BOM with package info/dimensions
    [materials.csv]
2024-01-23 Update materials (unique names)
    [materials.csv]
2024-01-23 Update material dimensions
    [materials.csv]
2024-01-24 Update material dimensions and BOM
    [materials.csv]
2024-02-26 Update NB3 audio and body PCB fab details
    [NB3_body-Edge_Cuts.dxf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]
2024-04-16 Update materials (inlcude level)
    [materials.csv]
2024-06-29 Update NB3_ear to rev3 fab
    [NB3_ear-B_Cu.gbl, NB3_ear-B_Mask.gbs, NB3_ear-B_Paste.gbp, NB3_ear-B_Silkscreen.gbo, NB3_ear-Edge_Cuts.gm1, NB3_ear-F_Cu.gtl, NB3_ear-F_Mask.gts, NB3_ear-F_Paste.gtp]
2024-06-29 Update NB3_power rev5 fab
    [NB3_power-B_Cu.gbl, NB3_power-B_Mask.gbs, NB3_power-B_Paste.gbp, NB3_power-B_Silkscreen.gbo, NB3_power-Edge_Cuts.gm1, NB3_power-F_Cu.gtl, NB3_power-F_Mask.gts, NB3_power-F_Paste.gtp]
2024-06-29 Updated NB3_power BOM
    [NB3_power.kicad_sch, NB3_power.ods, NB3_power.xls]
2024-07-16 Update to audio driver Rev2
2024-07-16 Tweak to audio/i2s/driver README
2024-07-19 Fix materials listing in READMEs
2024-07-24 Sample sound to 48kHz/S32
2024-08-02 Test UART implementation, echo
2024-08-07 Update and refactor UART verilog modules
2024-08-08 Polished and refactored UART and demo (no testbench yet)
